PI2-2020-1/documentos/Estrutura/Simulações/Numero de nós.PNG

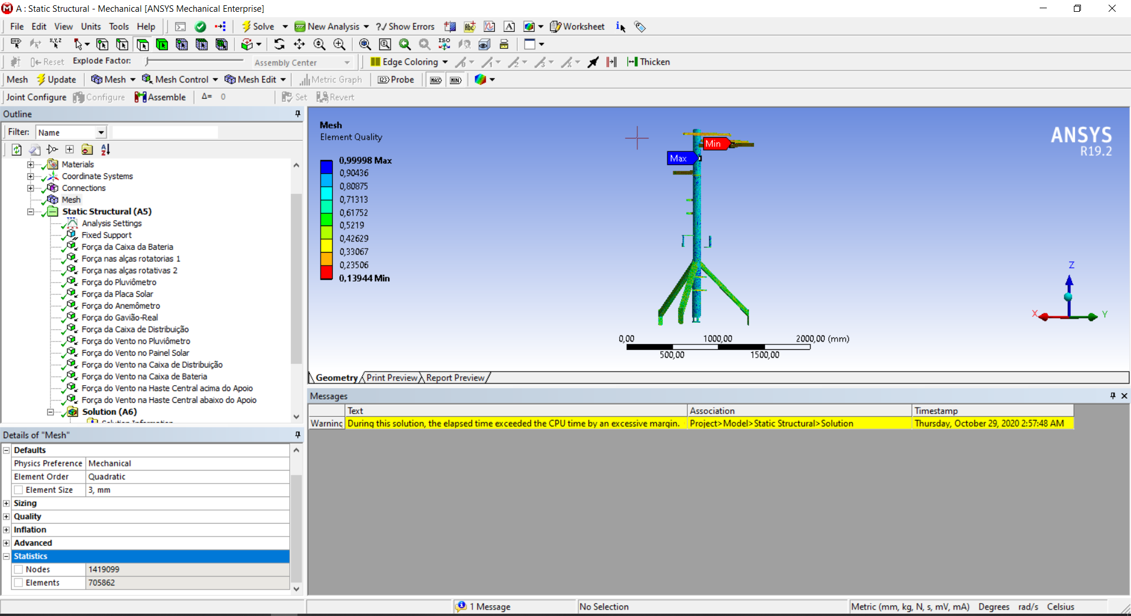
Estrutura/Simulações/Numero de nós.PNG
