PI2-2020-1/documentos/Estrutura/Simulações/vento.png

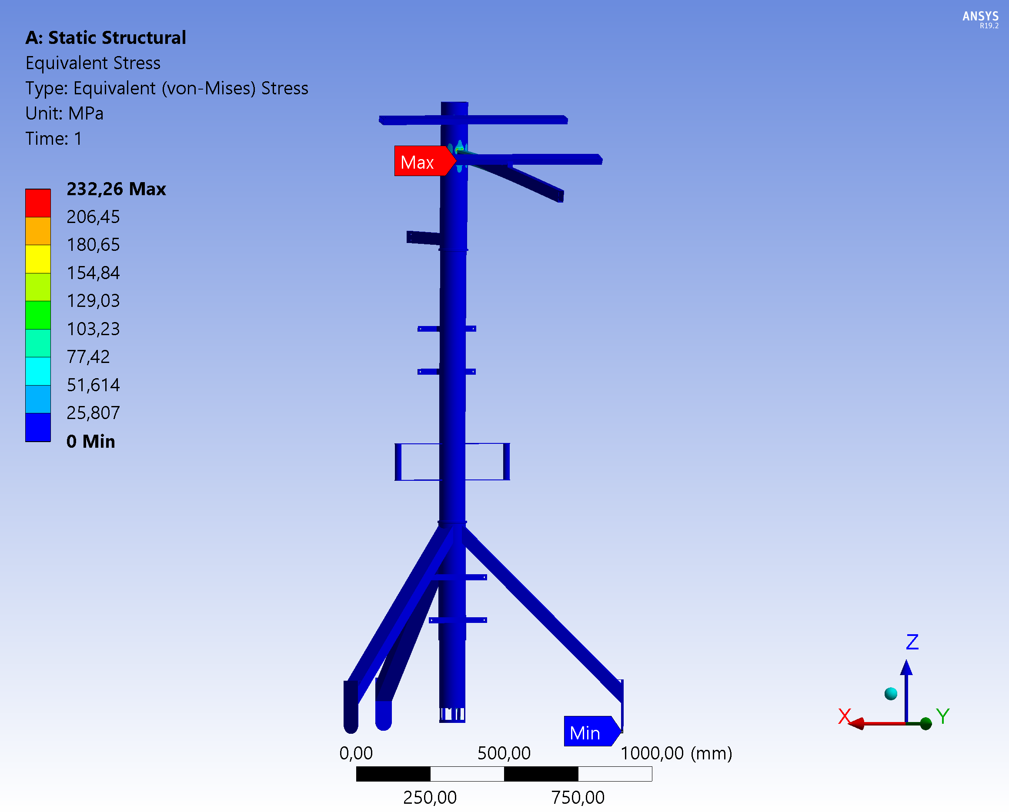
Estrutura/Simulações/vento.png
