PI2-2020-1/documentos/Arquitetura do projeto/Arquitetura_do_Projeto.pptx

Sensores

Estação de Verificação

Estação de Exposição

Sistema de condicionamento de sensores

Leitura e
Processamento
de Dados

Banco
de Dados

Bateria

Sistema de proteção

Sistema de proteção

Controlador de carga

Central de
Envio de Dados

Gerenciamento de
Energia

Software/
Aplicativo

Sistema de proteção

Painel
Fotovoltaico

Radiação solar

## Slide 2

ESP32

Estação de Verificação

Sensor de Velocidade do Vento

Sensor de pH

Sensor de Temperatura

Sensor de Umidade do Ar

Sensor de Umidade do Solo

Antena
LoRa

Controlador de Carga

Sensor de Pressão

Módulo GPS

Módulo GSM

Sistema de condicionamento de potência

Placa Fotovoltaica

Bateria

Radiação Solar
