PI2-2020-1/documentos/Arquitetura do projeto/EAP.pptx

## EAP das áreas

- Adicionar aqui os itens das respectivas EAPs para que seja feita a formatação.

EAP de Estrutura
DEFINIÇÃO DOS REQUISITOS
CÁLCULO DAS CARGAS
ESCOLHA DO MATERIAL
ELABORAÇÃO DO CAD
ANÁLISES CAE
CONFECÇÃO DOS DESENHOS TÉCNICOS
COMPRA DOS MATERIAIS
FABRICAÇÃO
BATERIA DE TESTES
FABRICAÇÃO: ACABAMENTO

EAP de Energia
CÁLCULO DA DEMANDA
DIMENSIONAMENTO DA GERAÇÃO
DIMENSIONAMENTO DO CONTROLADOR DE CARGA
DIMENSIONAMENTO DO BANCO DE BATERIAS
DESENVOLVER SISTEMA DE PROTEÇÃO ELÉTRICA
SISTEMA DE CONDICIONAMENTO DE TENSÃO
ATERRAMENTO DO SISTEMA DE ALIMENTAÇÃO
DIMENSIONAMENTO DOS CABOS
DESENVOLVER O PROJETO ELÉTRICO

EAP de Software
PLANEJAMENTO/DOCS
LEVANTAMENTO DE REQUISITOS
ELABORAÇÃO DO ROADMAP
DOCUMENTO DE CONTROLE DE RISCOS
DOCUMENTO DE CONTROLE DE QUALIDADE
PROTOTIPAÇÃO DA APLICAÇÃO
DOCUMENTO DE VISÃO
DOCUMENTO DE ARQUITETURA
MODELAÇÃO DO BANCO DE DADOS
IMPLEMENTAÇÃO
CRIAÇÃO DO BANCO DE DADOS
DESENVOLVIMENTO DA API
DESENVOLVIMENTO DA APLICAÇÃO WEB (FRONT END)

EAP de Eletrônica
Programar sensores do solo;
Programar sensores da estação meteorológica;
Programar módulo GPS;
Posicionar sensores do solo;
Testar os sensores do solo;
Posicionar a estação meteorológica e GPS;
Testar da estação meteorológica e GPS;
Agrupar os dados;
Verificação do envio e recebimento dos dados;

EAP de Gestão
RISCOS
EAP
CUSTOS
MONITORAMENTO DO PROJETO
INTEGRAÇÃO

## Slide 2

NOME DO PROJETO

GESTÃO

ELETRÔNICA

ENERGIA

ESTRUTURA

SOFTWARE

RISCOS

PROGRAMAÇÃO DOS SENSORES DO SOLO

CÁLCULO DA DEMANDA

LEVANTAMENTO DOS REQUISITOS

LEVANTAMENTO DOS REQUISITOS

EAP

PROGRAMAÇÃO DOS SENSORES DA ESTAÇÃO

DIMENSIONAMENTO DA GERAÇÃO

CÁLCULO DAS CARGAS

ELABORAÇÃO DO ROADMAP

CUSTOS

MONITORA-MENTO

PROGRAMAÇÃO DO MÓDULO GPS

POSICIONAMENTO DOS SENSORES DO SOLO

DIMENSIONAMENTO DO CONTROLADOR DE CARGA

DIMENSIONAMENTO DO BANCO DE BATERIAS

ESCOLHA DO MATERIAL

ELABORAÇÃO DO CAD

DOCUMENTO DE CONTROLE DE RISCOS

DOCUMENTO DE CONTROLE DE QUALIDADE

INTEGRAÇÃO

TESTE DOS SENSORES DO SOLO

DIMENSIONAMENTO DO INVERSOR

ANÁLISES CAE

PROTOTIPAÇÃO DA APLICAÇÃO

POSICIONAMENTO DA ESTAÇÃO E GPS

CONFECÇÃO DOS DESENHOS TÉCNICOS

DOCUMENTO DE VISÃO

TESTE DA ESTAÇÃO E GPS

COMPRA DOS MATERIAIS

DOCUMENTO DE ARQUITETURA

AGRUPAMENTO DOS DADOS

FABRICAÇÃO

MODELAÇÃO DO BANCO DE DADOS

TESTE DA TRANSFERÊNCIA DE DADOS

TESTES

CRIAÇÃO DO BANCO DE DADOS

ACABAMENTO

DESENVOLVIMENTO DA API

DESENVOLVIMENTO DA APLICALÇAO WEB (FRONT END)
