PI2-2020-1/documentos/Eletrônica/EAP-Eletrônica.docx

EAP - Eletrônica

- Programar sensores do solo;
- Programar sensores da estação meteorológica;
- Programar módulo GPS;
- Posicionar sensores do solo;
- Testar os sensores do solo;
- Posicionar a estação meteorológica e GPS;
- Testar da estação meteorológica e GPS;
- Agrupar os dados;
- Verificação do envio e recebimento dos dados;

Restrições e Metas Arquiteturais

O sistema de obtenção de dados do solo será implementado em conjunto com uma estação meteorológica capaz de fornecer dados climáticos acerca do local evitando eventuais danos causados pela intensidade do sol e de chuvas. Com isso os dados colhidos do solo serão fornecidos adequadamente para análise do agricultor. A seguir estão colocados restrições e metas para o uso adequado desse sistema:

- Os sensores de medição de umidade do solo e pH do solo são usadas para obter parâmetros necessários para identificar se o solo está apto a fazer plantações e indicar eventuais medidas corretivas.
- Os dados enviados à estação serão importantes para que o agricultor use procedimentos adequados caso precise melhorar os nutrientes do solo.
- Todos os dados obtidos pelos sensores serão enviados via LoRa para uma estação de processamento de dados em um local específico com a gerência da plantação capaz de analisar corretamente.
