PI2-2020-1/documentos/Eletrônica/Riscos_Eletrônica.docx

Riscos de eletrônica

- Sensores queimarem;
- Não encontrar componentes à venda
- Fios condutores romperem;
- Algoritmos complexos e incorretos;
- Falha na comunicação LoRa
- Falhas ao se integrar sistemas
- Leitura incorreta dos dados
