PI2-2020-1/documentos/Eletrônica/Tarefas_PC2.docx

Daniel | Igor | Wilton
sensor de ph | Colocar sleep | Introduzir restrições e metas
sensor de umidade do solo | Planilha Avaliação Interna | Corrigir páginas em branco
| adicionar referência cap 7 | sensor bme 280
| Anemômetro | pluviômetro
| módulo gsm

- Pesquisar detalhadamente sobre os sensores e escrever no pc2
