PI2-2020-1/documentos/Eletrônica/Untitled document (2).docx

Estação do solo | Preço
Sensor de pH do solo | 178,50
Sensor de umidade do solo | 9,90
Esp 32 | 42,00
Modulo gsm | 179,00
Total | 409,40

Estação Meteorológica | Preço
Anemometro | 237,03
Pluviometro | 265,53
Sensor bme280 | 30,99
Total | 533,55

Sensores | Preço
Sensor de pH do solo | 178,50
Sensor de umidade do solo | 9,90
Esp 32 | 42,00
Anemometro | 237,03
Pluviometro | 265,53
Sensor bme280 | 30,99
Modulo gsm | 179,00
Total | 942,95

[1] Ph do solo: https://produto.mercadolivre.com.br/MLB-797773127-modulo-sensor-ph-eletrodo-sonda-bnc-arduinophmetro-_JM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

[2] Umidade do Solo

https://www.eletrogate.com/modulo-sensor-de-umidade-de-solo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

[3] Esp32

https://produto.mercadolivre.com.br/MLB-1614475865-esp32-wroom-devkit-_JM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

[4] Anemometro

https://www.usinainfo.com.br/estacao-meteorologica-arduino/anemometro-arduino-sensor-de-vento-para-estacao-meteorologica-sv10-3686.html

[5] Pluviometro

https://www.usinainfo.com.br/estacao-meteorologica-arduino/pluviometro-de-bascula-digital-arduino-para-estacao-meteorologica-pb10-4637.html

[6] Sensor Bme280

https://produto.mercadolivre.com.br/MLB-1410976290-sensor-bme280-presso-temperatura-e-umidade-alta-preciso-_JM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

[7] Modulo gsm

https://produto.mercadolivre.com.br/MLB-820363244-modulo-gsm-gprs-quad-band-sim808-com-gps-arduino-_JM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
