PI2-2020-1/documentos/Energia/Anotações de Reuniões com professores/Reunião   09_10_2020.docx

Reunião com o Professor Aléx 09/10/2020

- Revisar o dimensionamento da bateria da Estação Meteorológica
- Calcular fator de segurança
- *Circuito de condicionamento*
- *A corrente do controlador de carga tem que ser maior que a corrente da carga*
- **Conversor CC** (BUCK - sTEP DOWN) *para cada carga*
- Sistema de proteção (fusível/chave)

Empresa que a ICOANA recomendou :
