PI2-2020-1/documentos/PC2_apresentacao_grupo_10.pdf

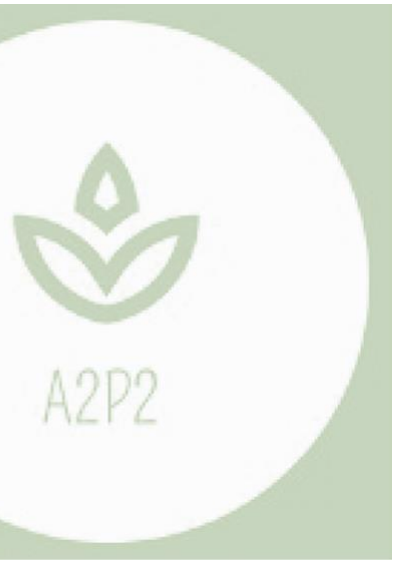
[picture p51: figure]

A2P2

### Analisador de Ambiente para Plantações

Monitoramento de dados do solo e do clima para
tomada de decisão

Seja bem-vindo ao

Responsabilidade
Ambiental

Resposta a demandas
do produtor

# Estrutura

# Sistema de Alimentação

### Demanda energética

- Tempo de medição

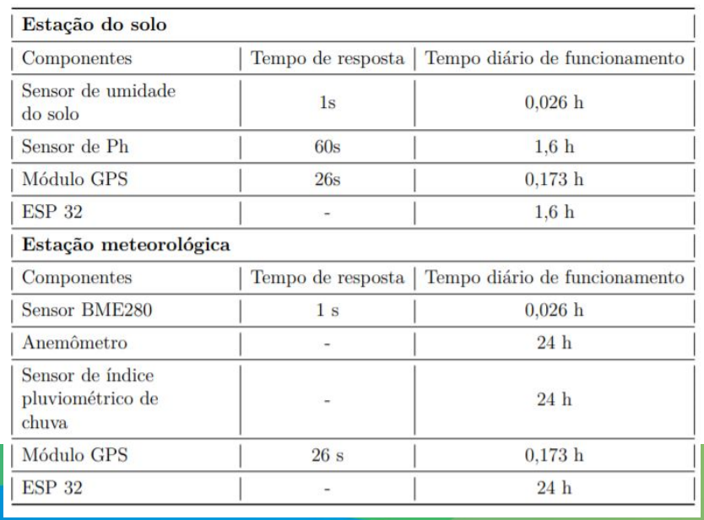
[picture p52: figure]

### Demanda energética

Estação do solo

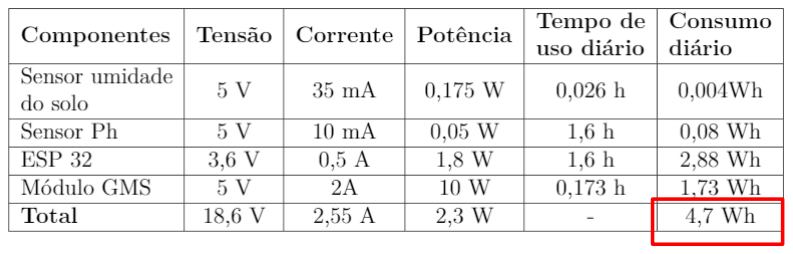
[picture p53: figure]

### Demanda energética

Estação Meteorológica

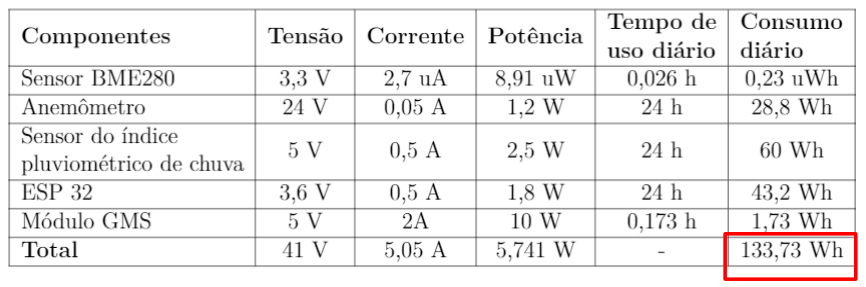
[picture p54: figure]
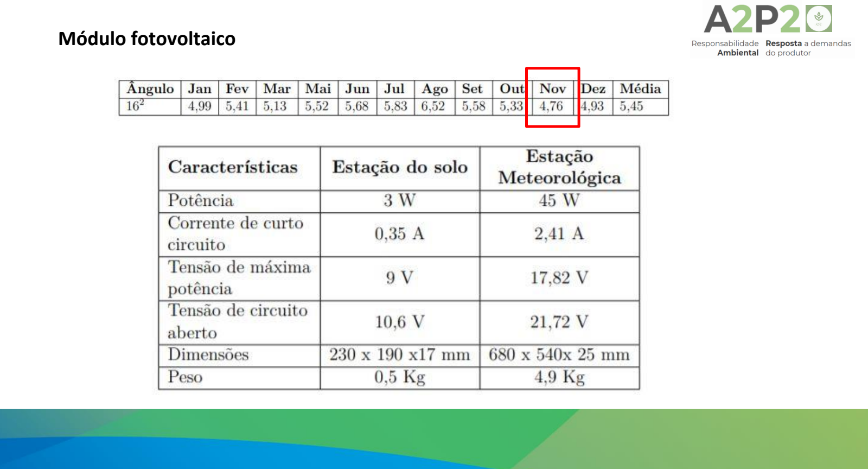
[picture p55: page 8]

### Módulo fotovoltaico

## Bateria

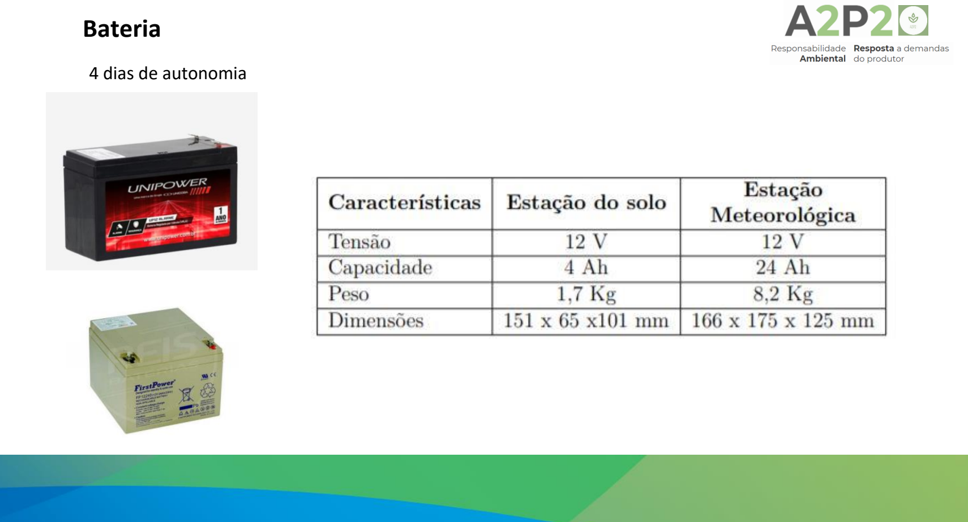
[picture p56: page 9]

4 dias de autonomia

## Controlador de carga

Estação do solo | Estação Meteorológica

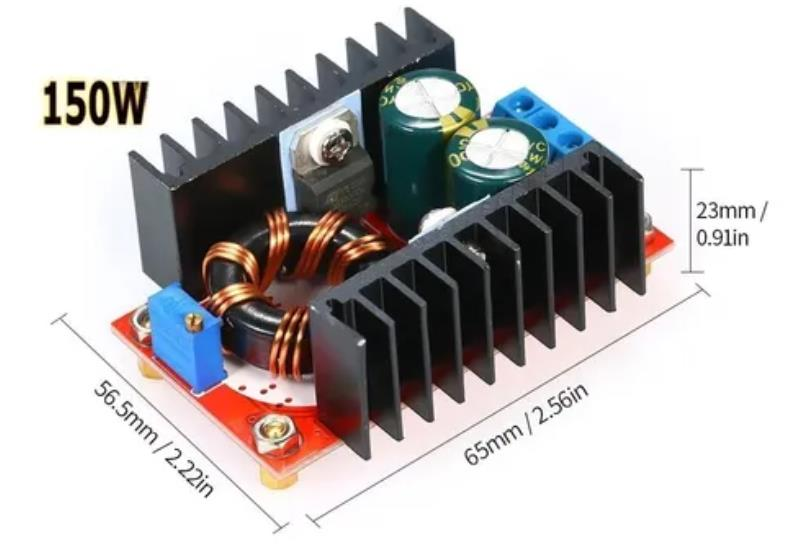
[picture p57: figure]

Entrada: 5V | Corrente: 5A
Saída: 12V

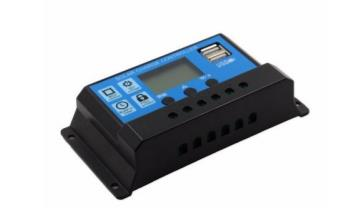
[picture p58: figure]

Entrada: 18V Corrente: 10A Saída: 12V

# Sistema de Condicionamento de Potência

Sistema de
armazenamento

Sistema de
Geração

Sistema de
Condicionamento
de Potência

Cargas

Sistema de condicionamento de potência como conexão entre os sistemas de geração, armazenamento e carga.

## Sistema de Condicionamento de Potência

Estação Meteorológica Estação do solo

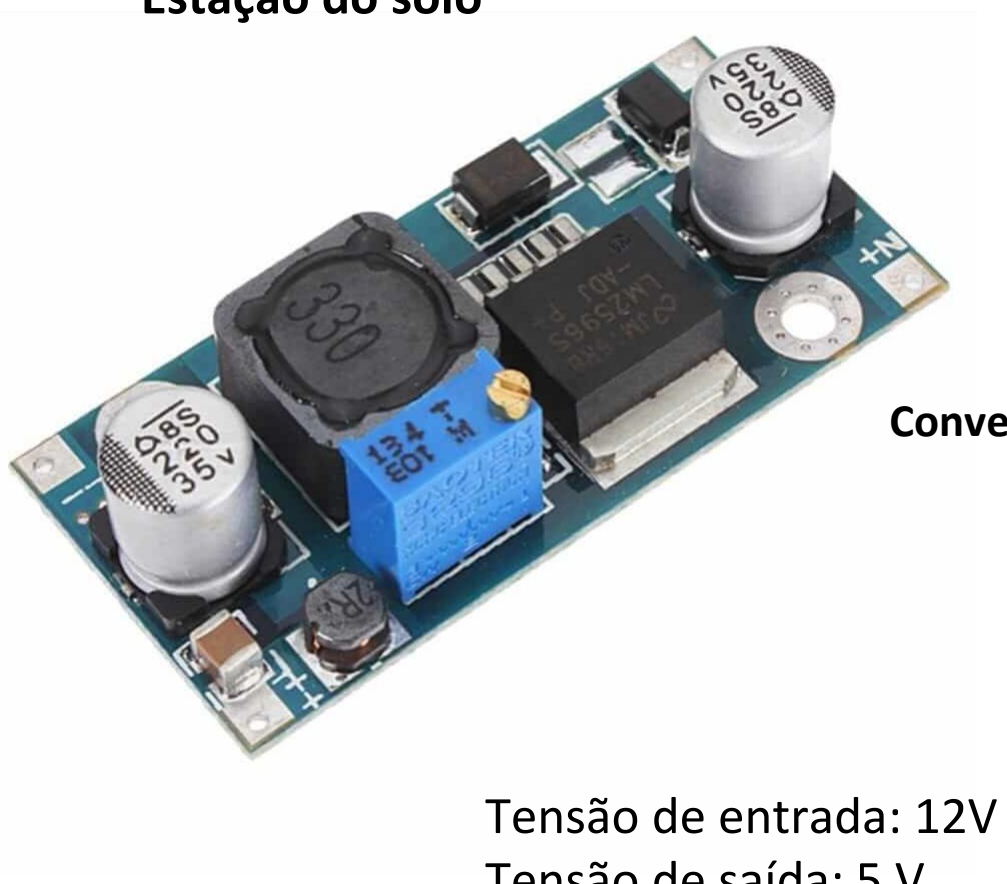
[picture p59: figure]
Tensão de entrada: 12V

Tensão de saída: 5 V
Corrente de saída: 2,5 A

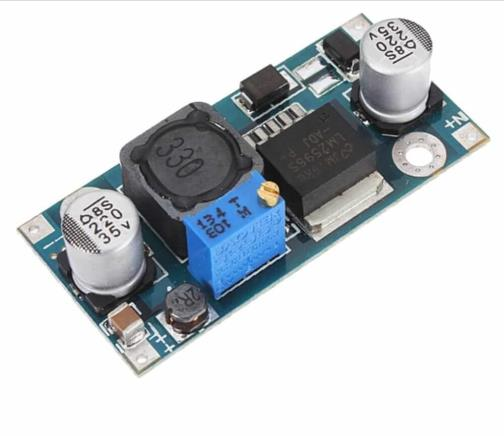
[picture p60: figure]

Tensão de entrada: 12 V
Tensão de saída: 3,3 V e 5 V Corrente de saída: 3 A

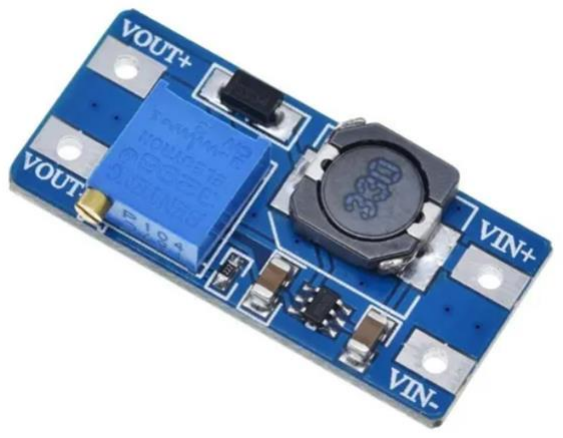
[picture p61: figure]

Conversor CC/CC Step-up

Conversor CC/CC Step
Down

Conversor CC/CC Step Down

Tensão de entrada: 12 V
Tensão de saída: 24 V
Corrente de saída: 3 A

## Diagrama unifilar: Estação do Solo

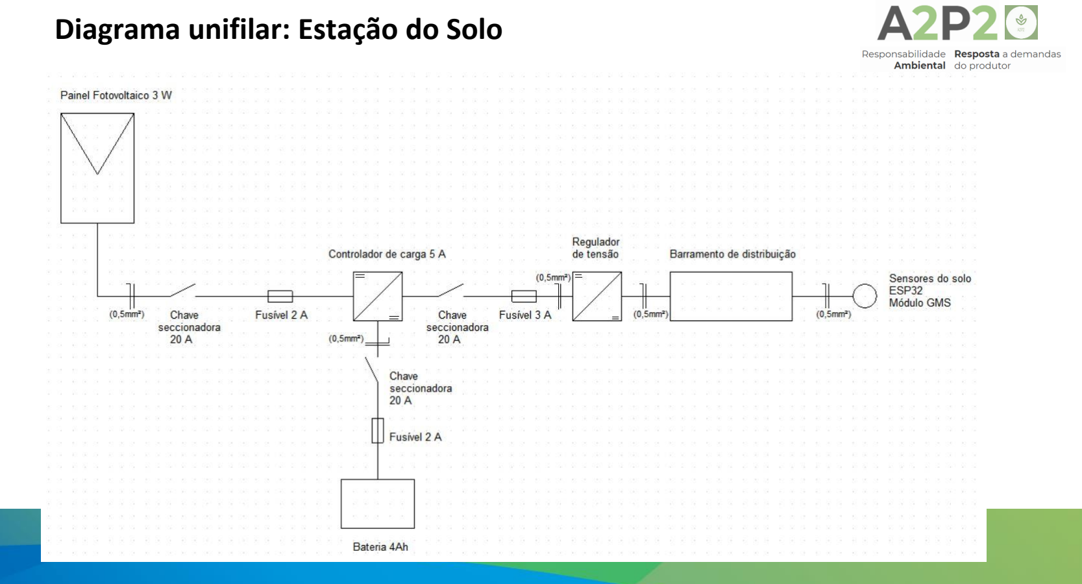
[picture p62: page 13]

## Diagrama unifilar: Estação Meteorológica

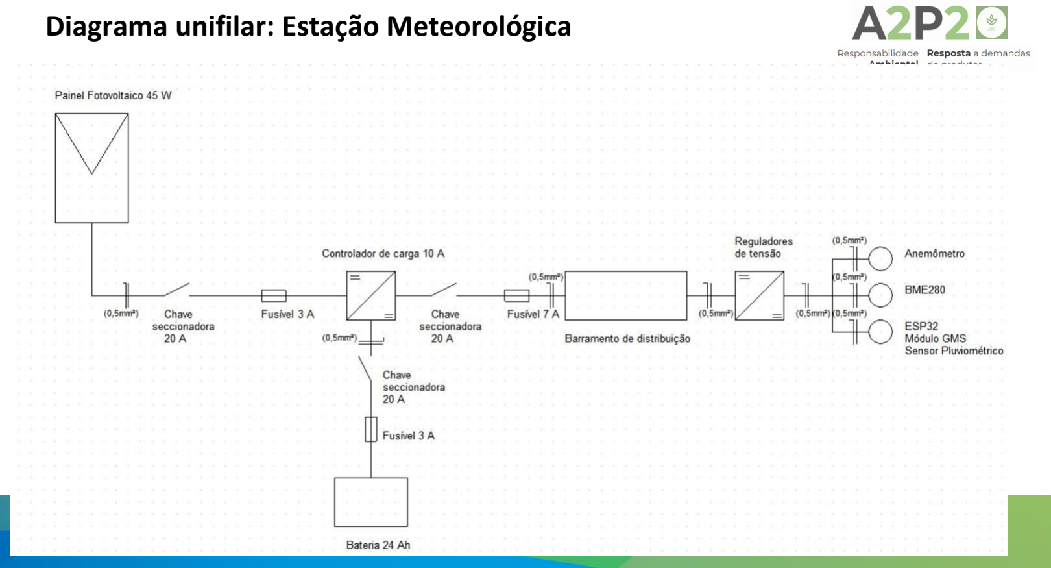
[picture p63: page 14]

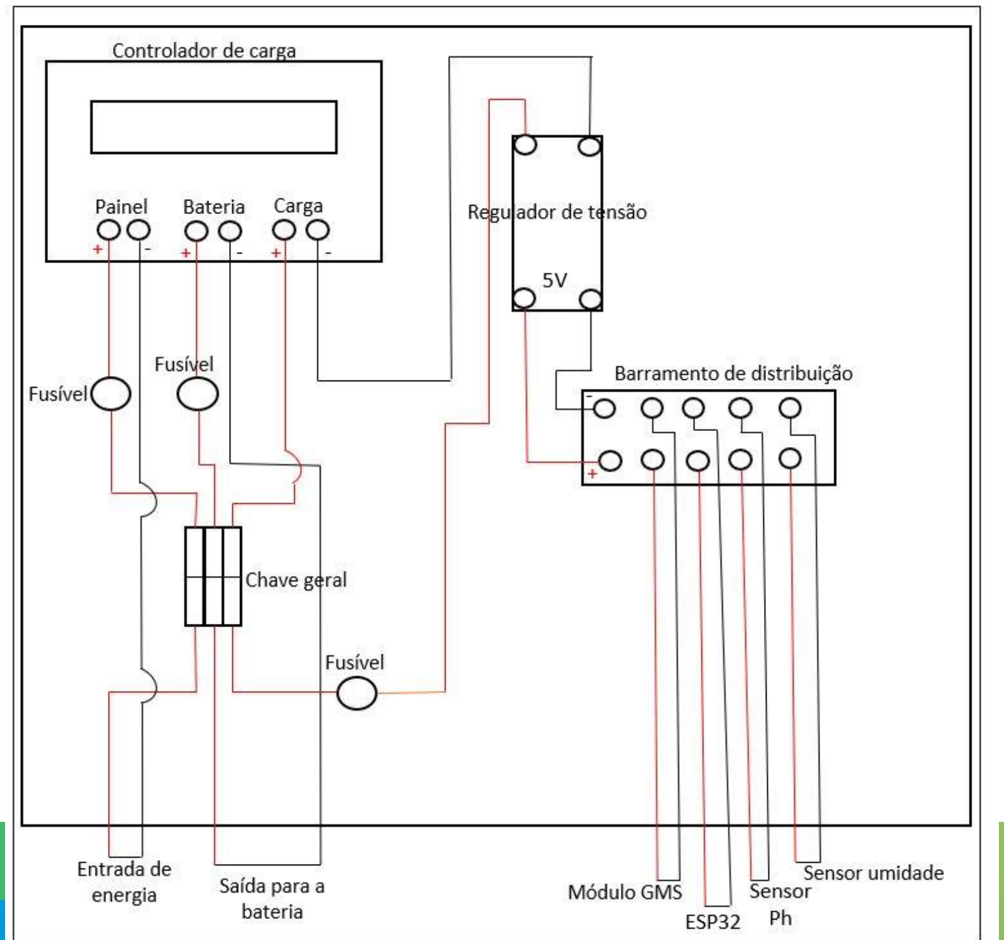
[picture p64: figure]

## Estação do solo

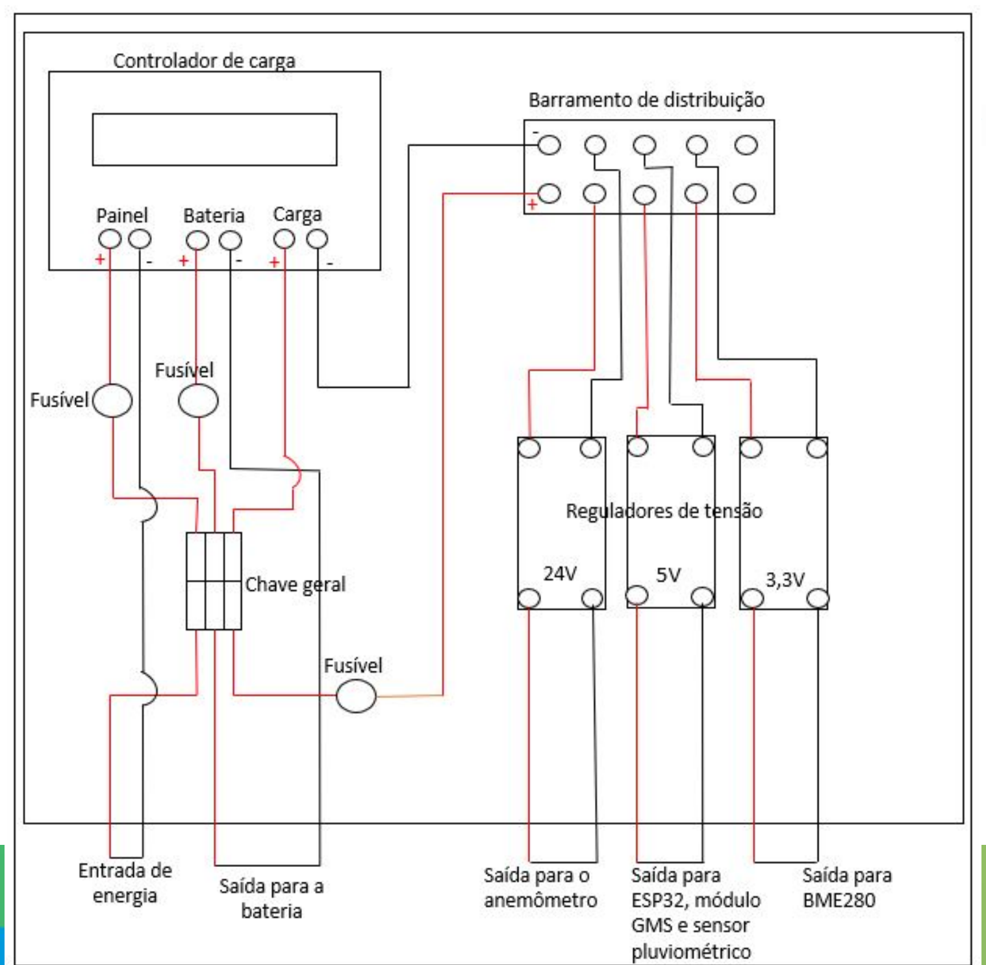
[picture p65: figure]

## Estação Meteorológica

# Eletrônica

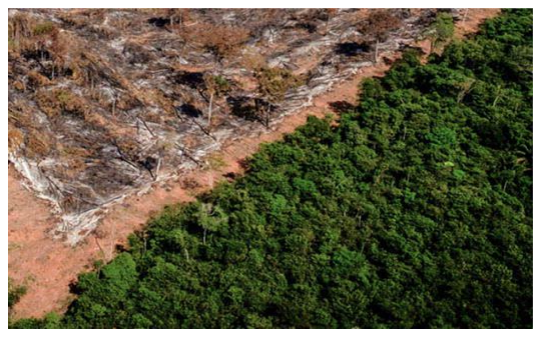
[picture p66: figure]
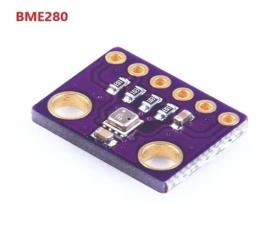
[picture p67: figure]
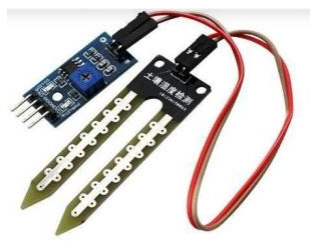
[picture p68: figure]
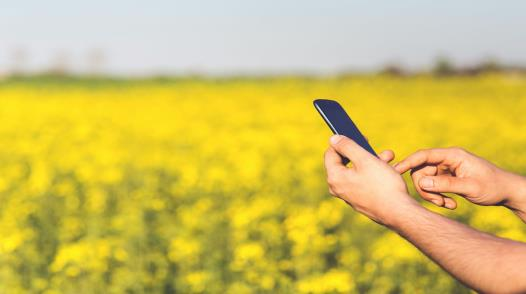
[picture p69: figure]

Responsabilidade
Ambiental

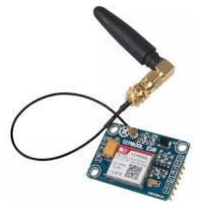
[picture p70: figure]

Resposta a demandas
do produtor

# Características Técnicas

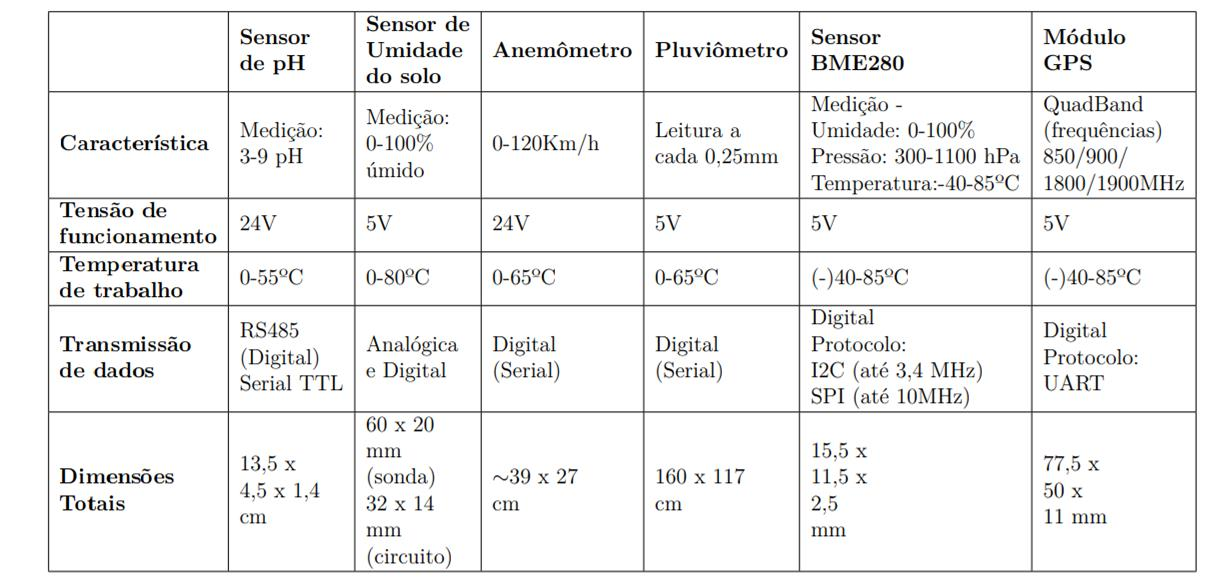
[picture p71: figure]

# Especificações Microcontroladores

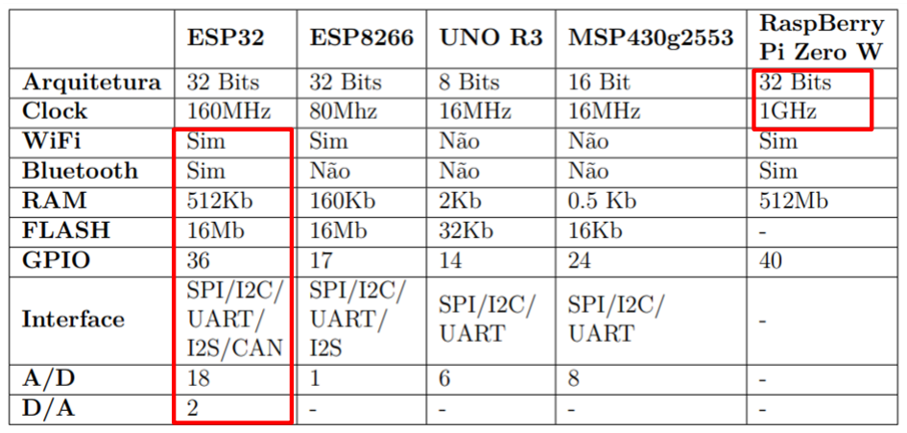
[picture p72: figure]

# Diagramas Lógicos

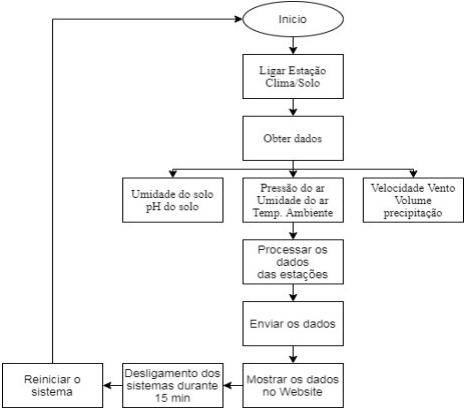
[picture p73: figure]

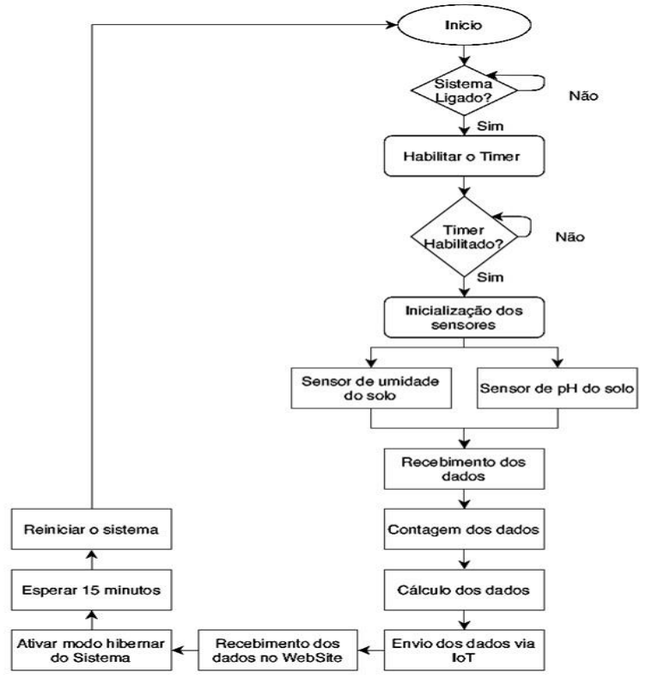
[picture p74: figure]

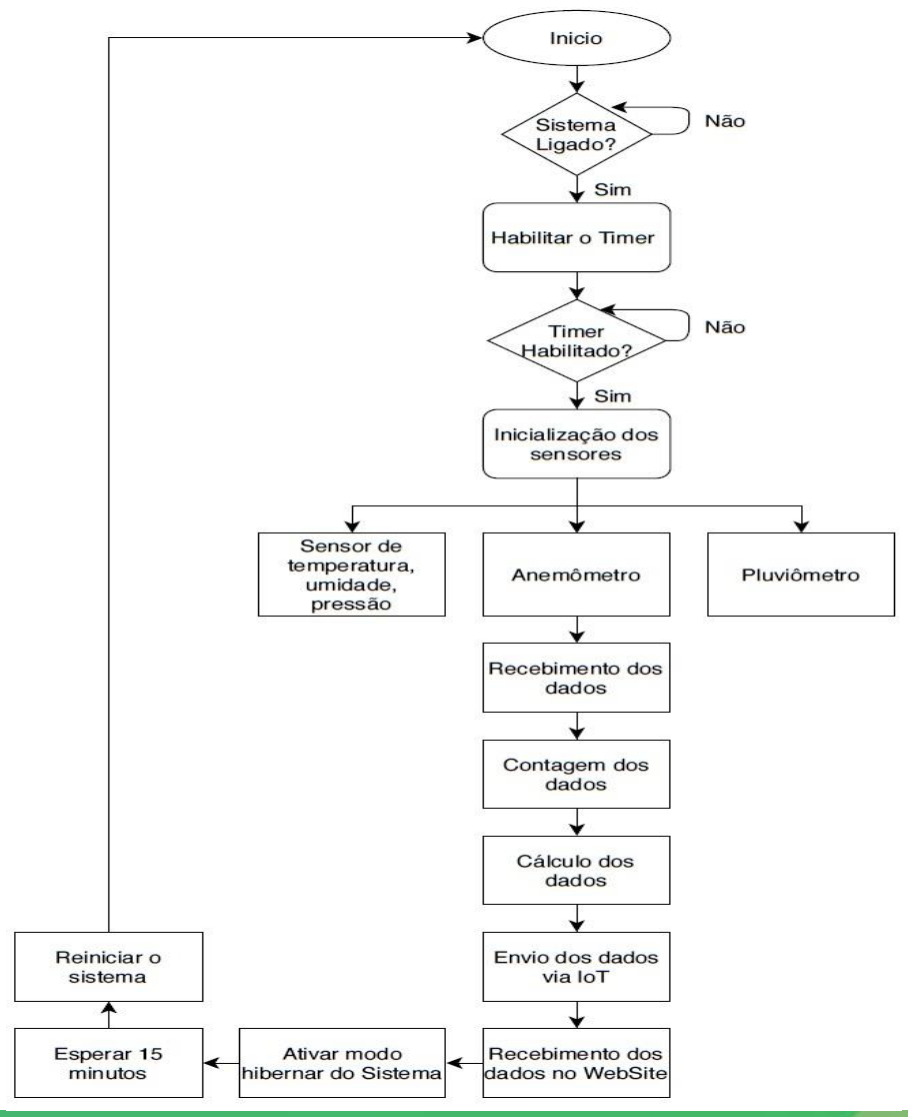
[picture p75: figure]

# Códigos dos Sensores

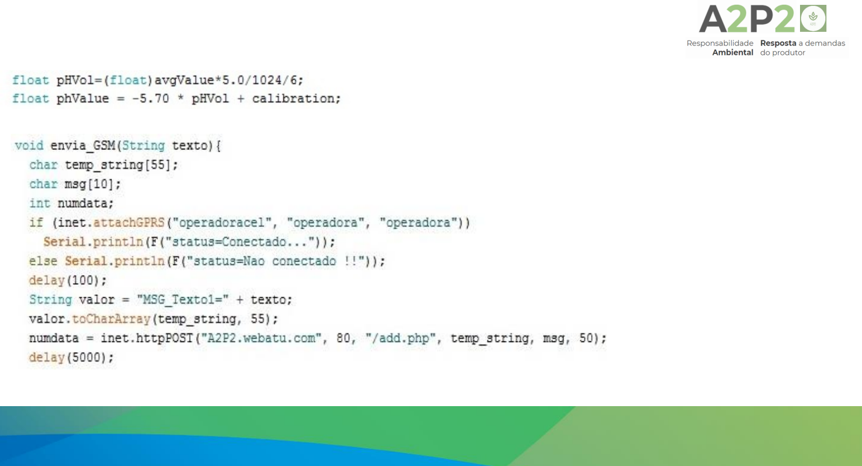
[picture p76: page 26]

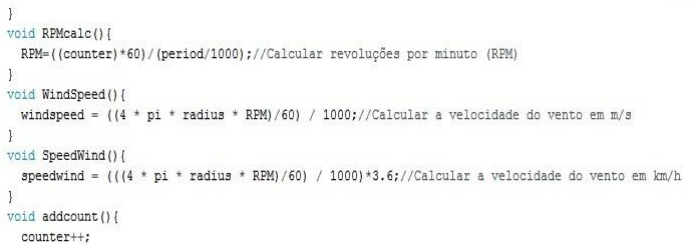
[picture p77: figure]

# Software

# Diagrama Geral

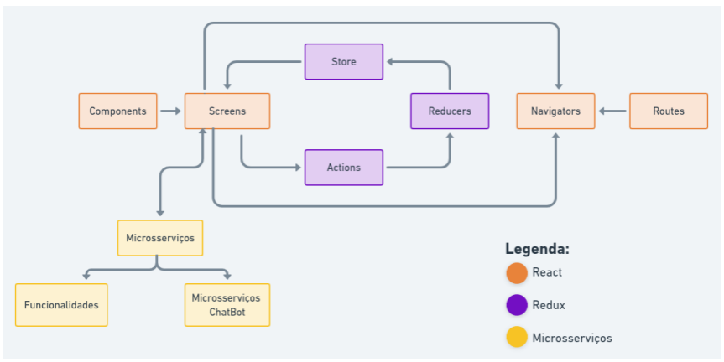
[picture p78: figure]

Diagrama Entidade-Relacionamento (DER) (https://www.devmedia.com.br/modelo-entidade-relacionamento-mer-e-diagrama-entidade-relacionamento-der/14332)

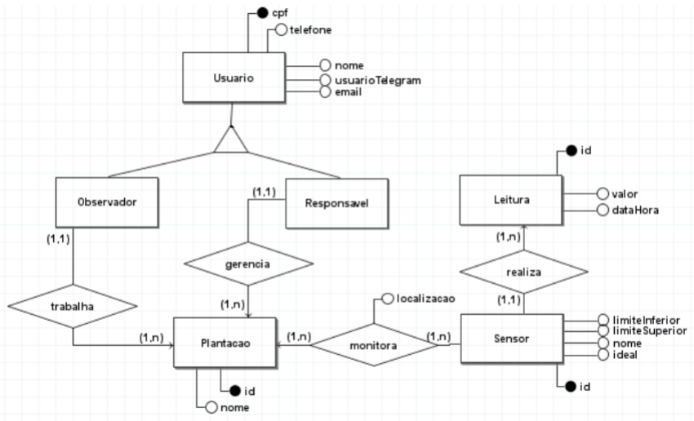
[picture p79: figure]

Demonstração (https://www.devmedia.com.br/modelo-entidade-relacionamento-mer-e-diagrama-entidade-relacionamento-der/14332)

# Schema

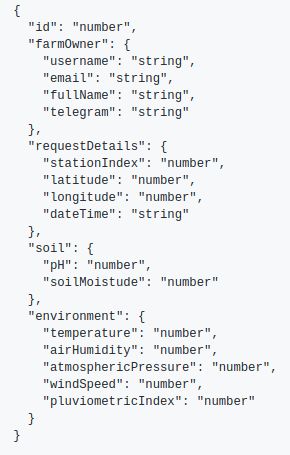
[picture p80: figure]

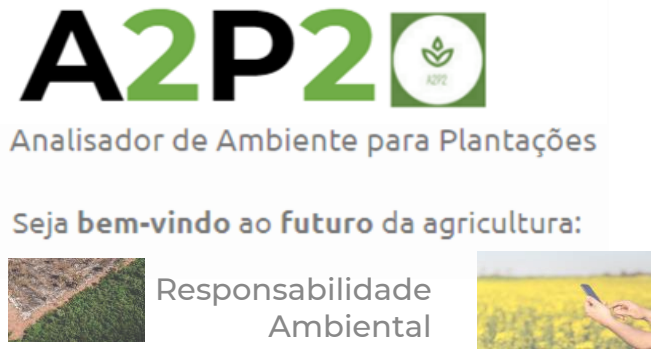
[picture p81: figure]
Responsabilidade Ambiental

# Muito Obrigado

!

Resposta a demandas
do produtor
