PI2-2020-1/documentos/PC3_apresentacao_grupo_10.pdf

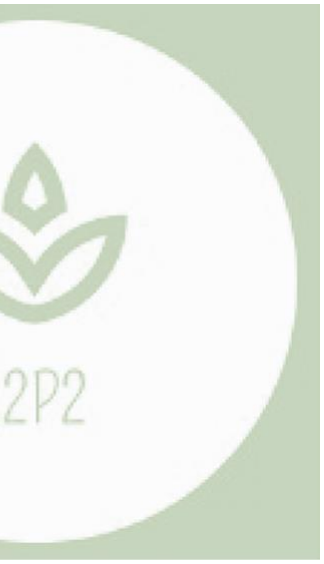
[picture p82: figure]

A2P2

Analisador de Ambiente para Plantações

Monitoramento de dados do solo e do clima para
tomada de decisão

Seja bem-vindo ao

Responsabilidade
Ambiental

Resposta a demandas
do produtor

# Software

# Software

# Web

Admin | Fazendeiro | Funcionário

# Perfis de Usuário

(Empresa) | (Cliente)

# Software

# Chatbot

# Eletrônica

## Comunicação do sistema embarcado

A ligação entre os sensores e a ESP32 depende do protocolo ou padrão de comunicação em que os sensores se baseiam. Dessa forma, os protocolos ou padrão presentes são:

- I²C
- RS-485
- UART

## Plano de montagem

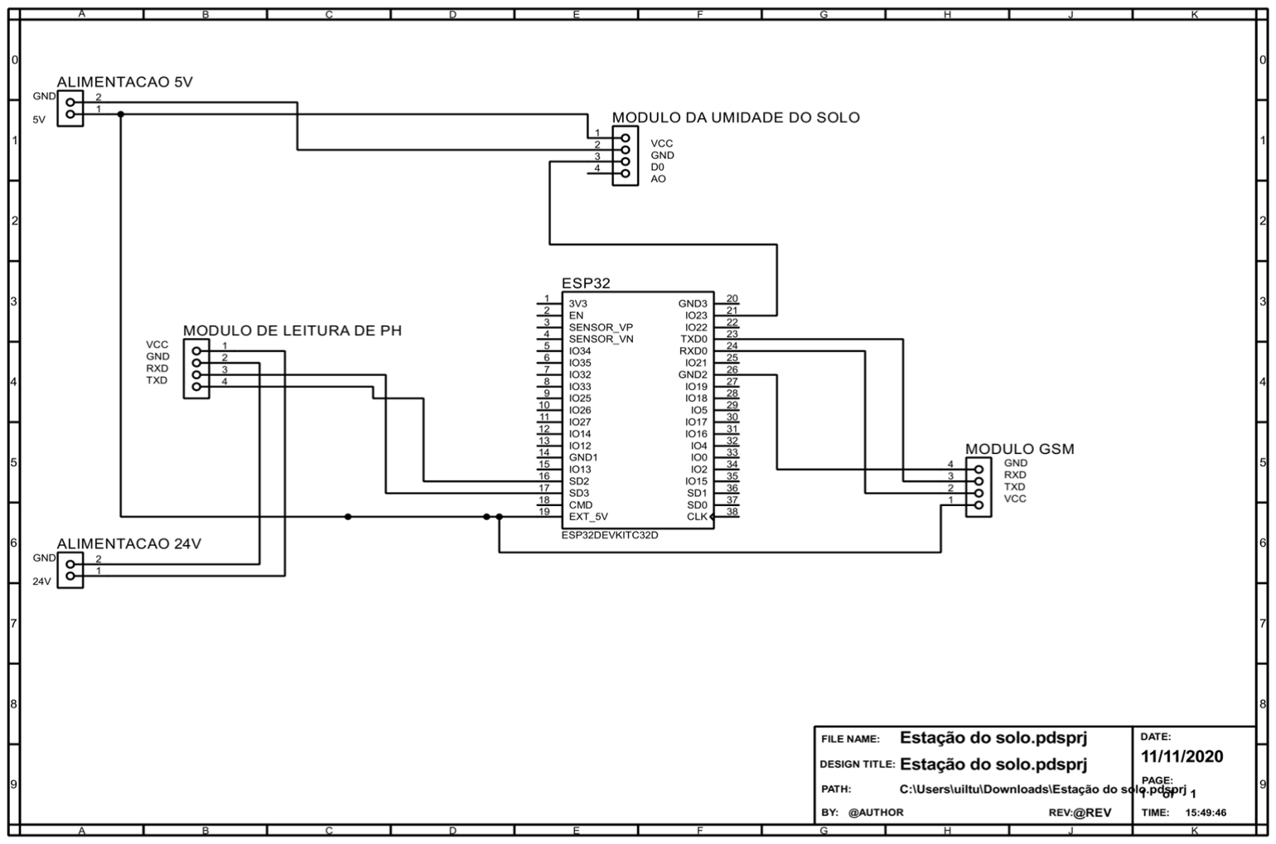
[picture p83: figure]

## Plano de montagem

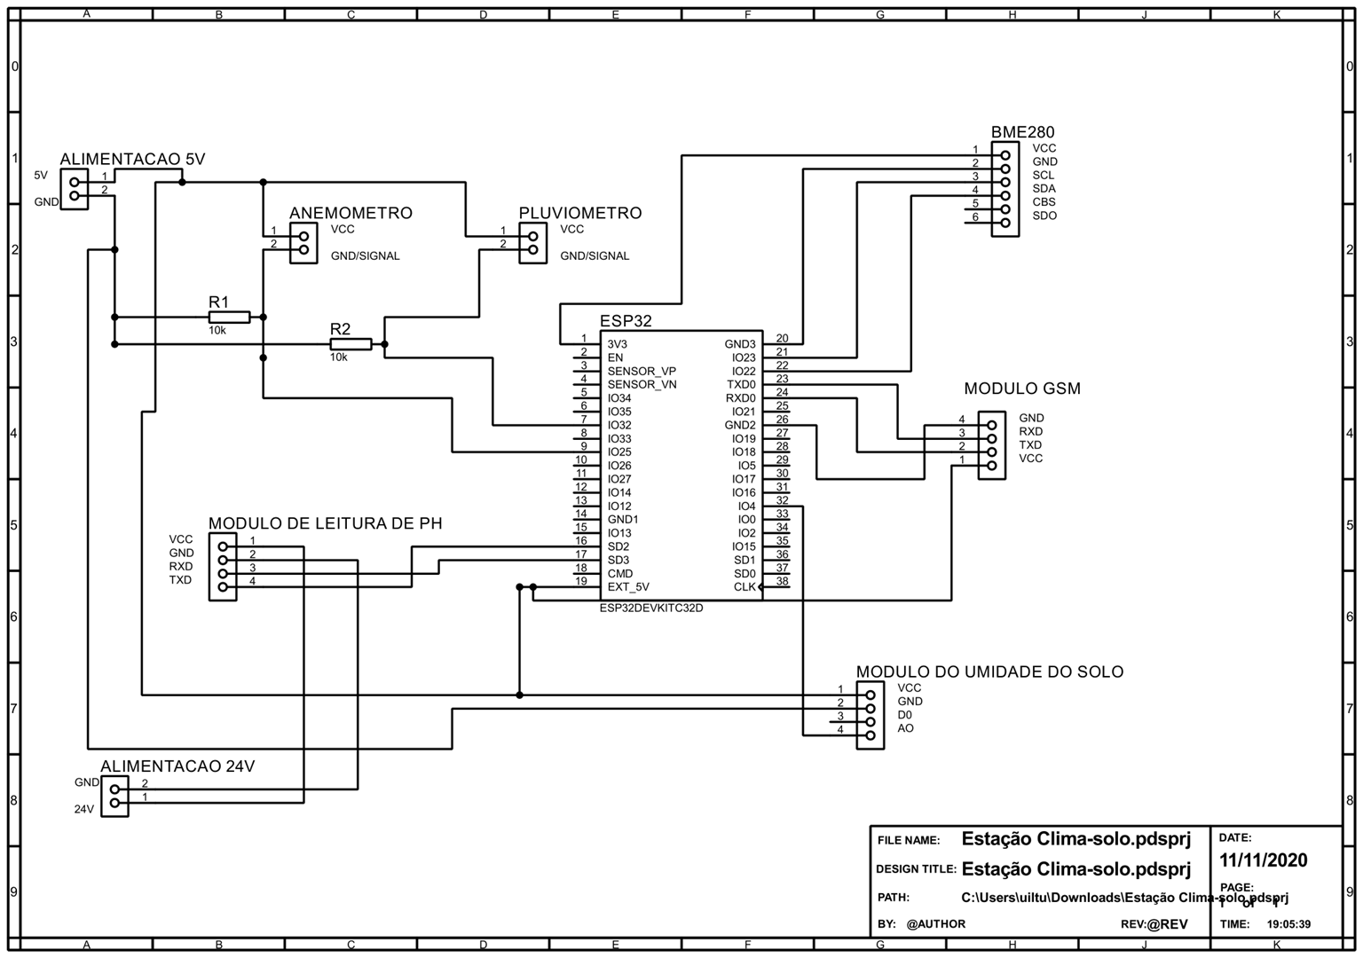
[picture p84: figure]

## Plano de fabricação

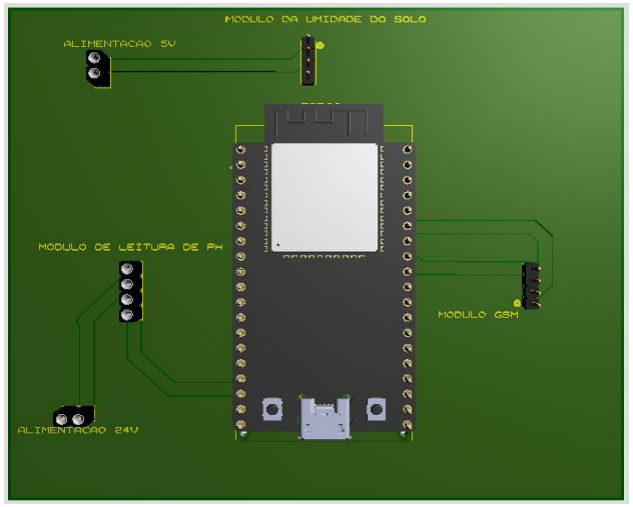
[picture p85: figure]

## Plano de fabricação

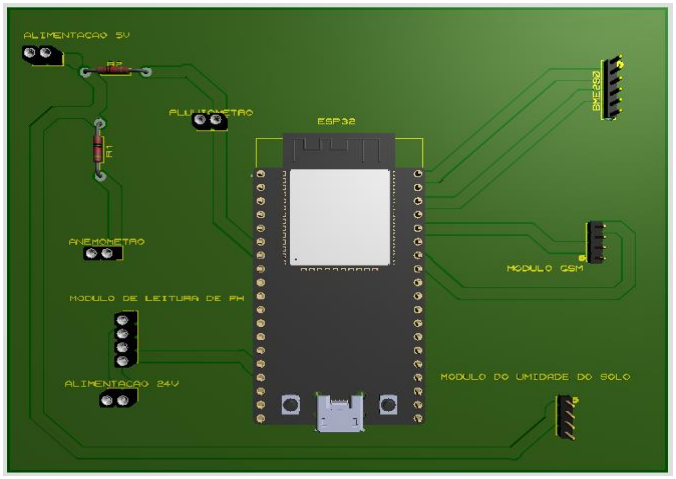
[picture p86: figure]

# Testes dos sensores

- Bme 280;
- Anemômetro;
- Pluviômetro;
- Umidade do solo e pH;
- Módulo GSM;

# Testes dos sensores

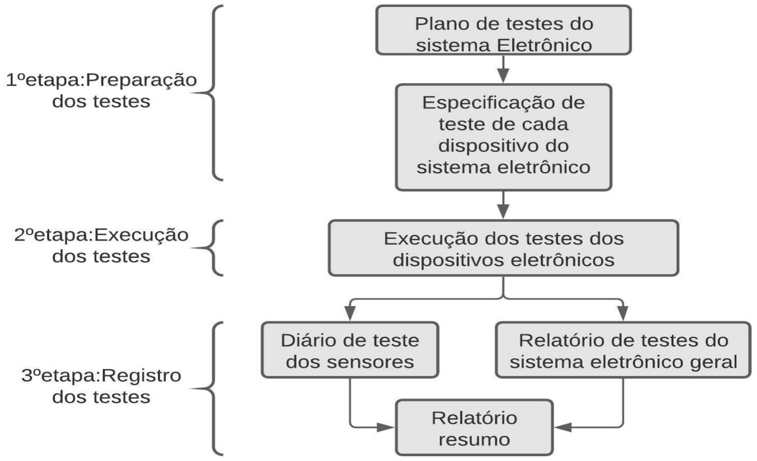
[picture p87: figure]

# Manutenção dos sensores

- Estação Clima-Solo;
- Estação Solo;

# Validação dos sensores - Comparação dos valores medidos por todos

os | sensores | utilizando | equipamentos
validados que sensoriam as mesmas variáveis;

# - Comparação dos valores obtidos pelos

sensores com valores padronizados. Ex:pH;

# Manutenção dos sensores

# - Comparação dos dados obtidos por meio dos sensores do clima, da estação Clima-Solo, com os dados do banco de dados obtidos em tempo real disponibilizados a partir do site do

INMET.

# Sistema de Alimentação

## Sistema de Alimentação

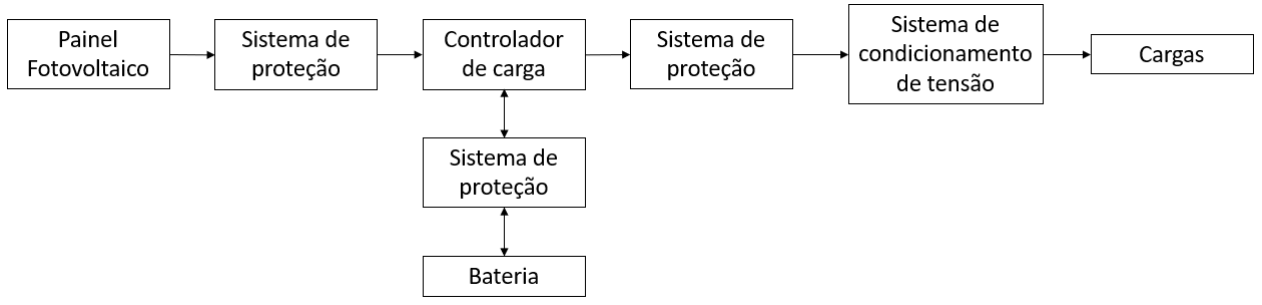
[picture p88: figure]

## Sistema de Alimentação

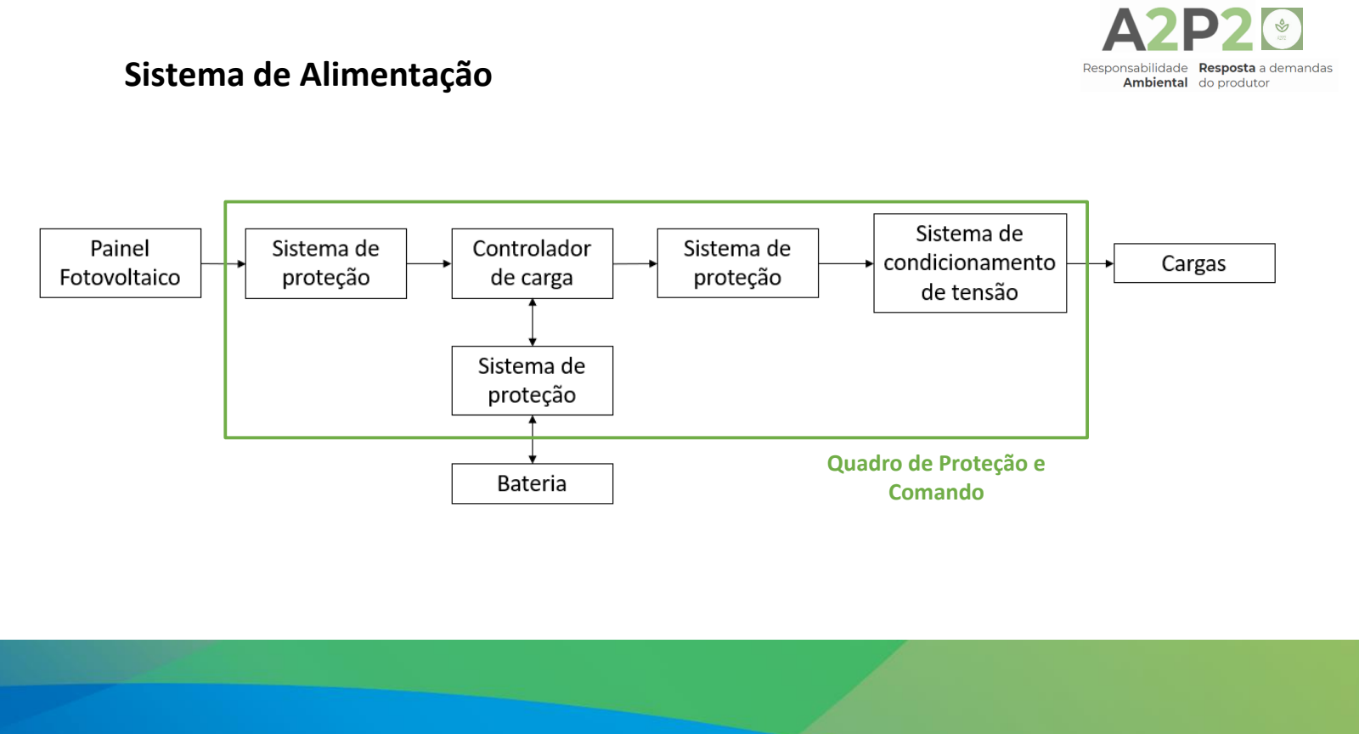
[picture p89: page 19]

Quadro de Proteção e
Comando

## Quadro de proteção e comando

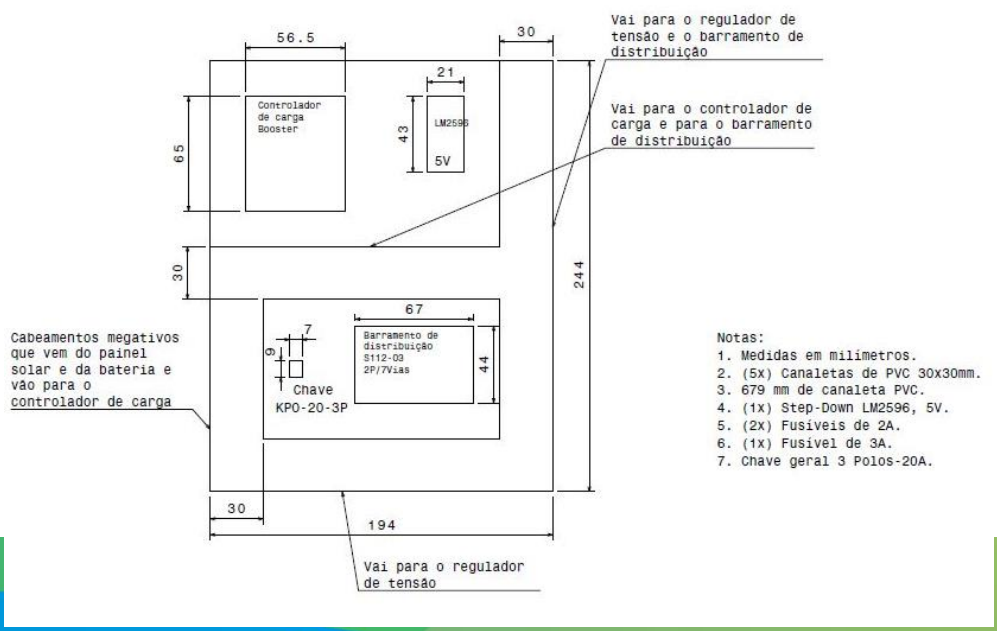
[picture p90: figure]

## Estação Solo

## Quadro de proteção e comando

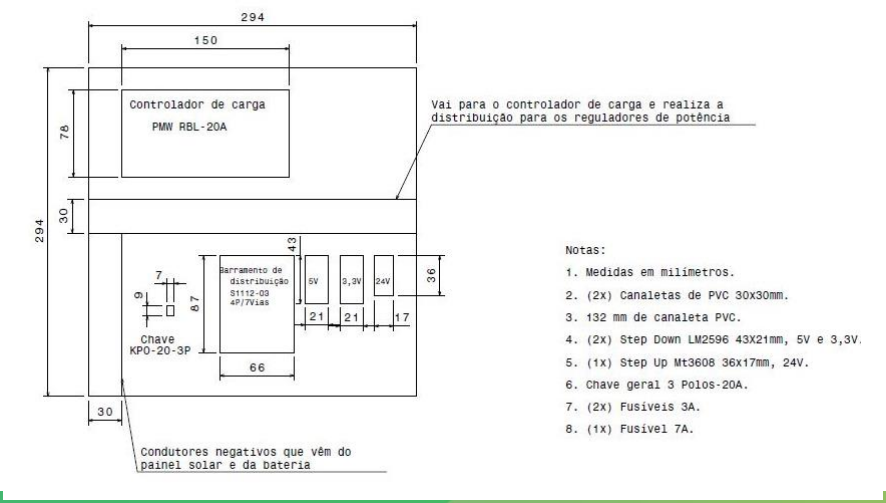
[picture p91: figure]

## Estação Clima-Solo

## Plano de fabricação

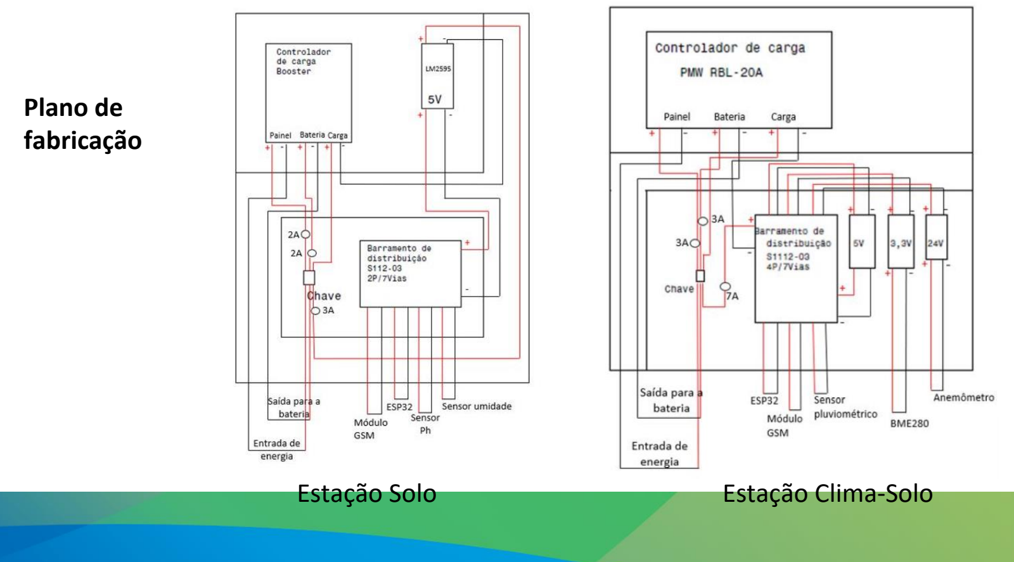
[picture p92: page 22]

Estação Solo | Estação Clima-Solo

## Plano de fabricação

Para o painel solar,

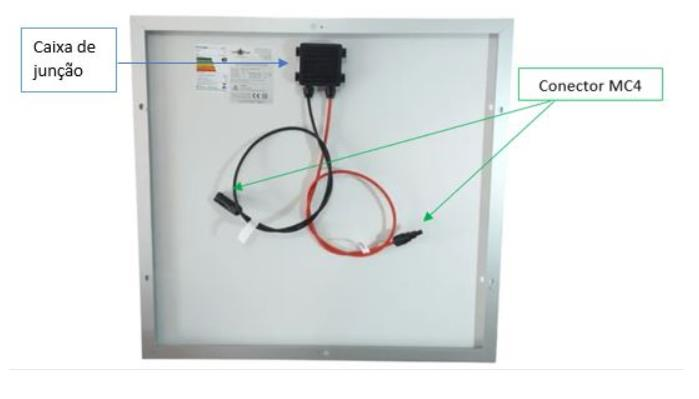
[picture p93: figure]

## Plano de teste

## Atividade de Comissionamento

## Inspeção visual

## Testes operacionais

## Plano de teste

## Inspeção visual:

Qualidade dos equipamentos;
Identificar as conexões;
Presença de placas de advertência de choque elétrico;
Montagem e segurança do painel solar e da estrutura de sustentação; Orientação e inclinação do painel solar;
Se a estrutura e o painel solar não apresentam danos aparentes; Montagem adequada da bateria;
Documentação completa do sistema de alimentação.

## Plano de teste

## Testes operacionais:

Medição da tensão de circuito aberto Voc.

Medição da corrente de curto-circuito Isc.

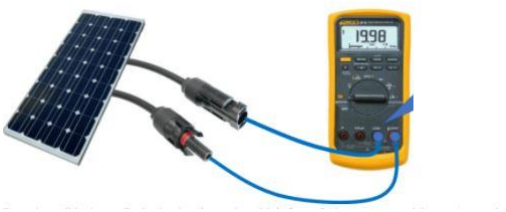
[picture p94: figure]

# Estrutura

# Integração

# Integração

# Módulos e Alimentação

## Modo sleep

## Tempo de uso diário = 24h

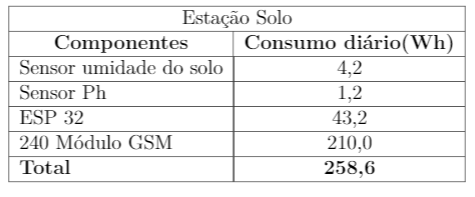
[picture p95: figure]
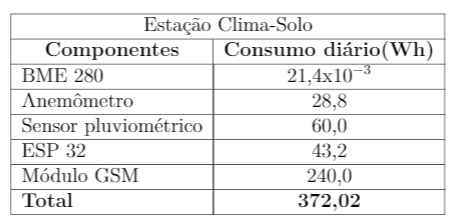
[picture p96: figure]

## Modo sleep: 15 min

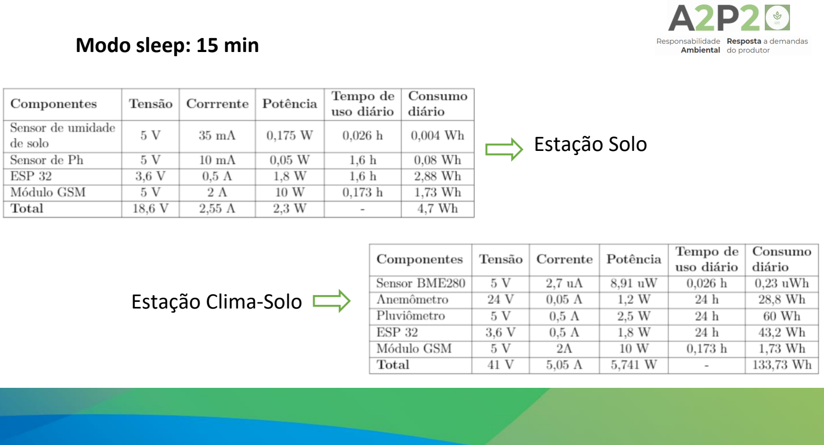
[picture p97: page 31]

## Estação Clima-Solo

## Estação Solo

## Modo sleep

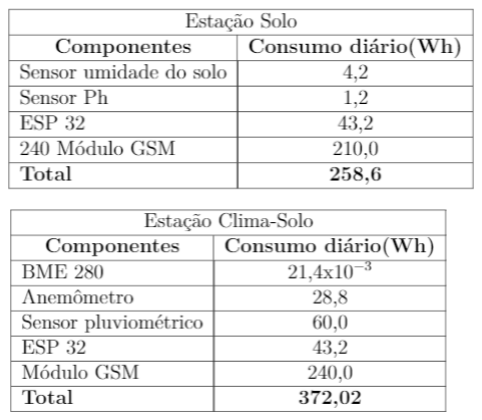
[picture p98: figure]

## Redução de 54% e

1,8%

Tempo de medição 15min:
Estação Solo = 4,7 Wh
Estação Clima-Solo = 133,73 Wh

# Integração

# Software e Sensores

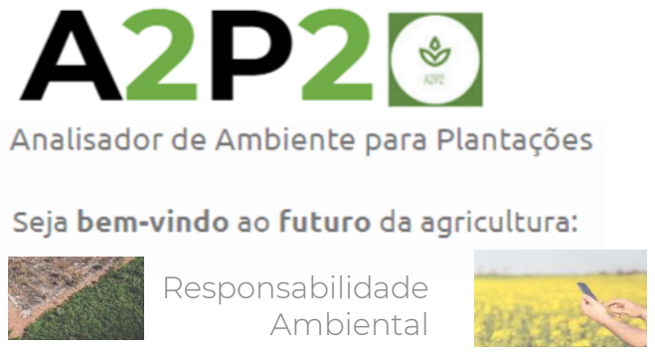
[picture p99: figure]
Responsabilidade Ambiental

# Muito Obrigado

!

Resposta a demandas
do produtor
