PI2-2020-1/documentos/Energia/ Roteiro_Dimensionamento.docx

1. Cálculo da demanda
2. Dimensionamento da geração

2.1 Avaliação da irradiação solar

2.2 Escolha do painel fotovoltaico

3. Dimensionamento do controlador de carga
4. Dimensionamento do banco de baterias

4.1 Autonomia sem insolação

4.2 Escolha da bateria

4.3 Profundidade de descarga

5. Dimensionamento do controlador de carga
6. Sistema de proteção elétrica
7. Sistema de condicionamento de potência
8. Aterramento
9. Dimensionamento dos cabos
10. Projeto elétrico
