PI2-2020-1/documentos/Energia/Tabela_Preços_Energia.docx

Componente | Preço
Painel fotovoltaico | R$ 21,87
Bateria | R$ 79,50
Controlador de carga | R$ 89,00
