PI2-2020-1/documentos/Software/Roteiro Apresentação PC3.docx

Específico

- Perfis de Usuário
  - Admin
  - Fazendeiro
  - Funcionário
- WEB
  - Fluxo de Cadastro (Para todos os perfis)
  - Dashboard
  - Página de Perfil
  - Relatórios
  - Definição e Alteração dos Parâmetros
- CHATBOT
  - Alterar Parâmetro
  - Simular notificação de parâmetro fora do limite
  - Mostrar dados mais recentes

Integração

- POST da placa para a API no insomnia (valor dos sensores)
- CHATBOT
  - Mostrar notificação
