PI2-2020-1/documentos/Estrutura/DTs/0_clima_solo/DT2_CLIMA-SOLO.jpg

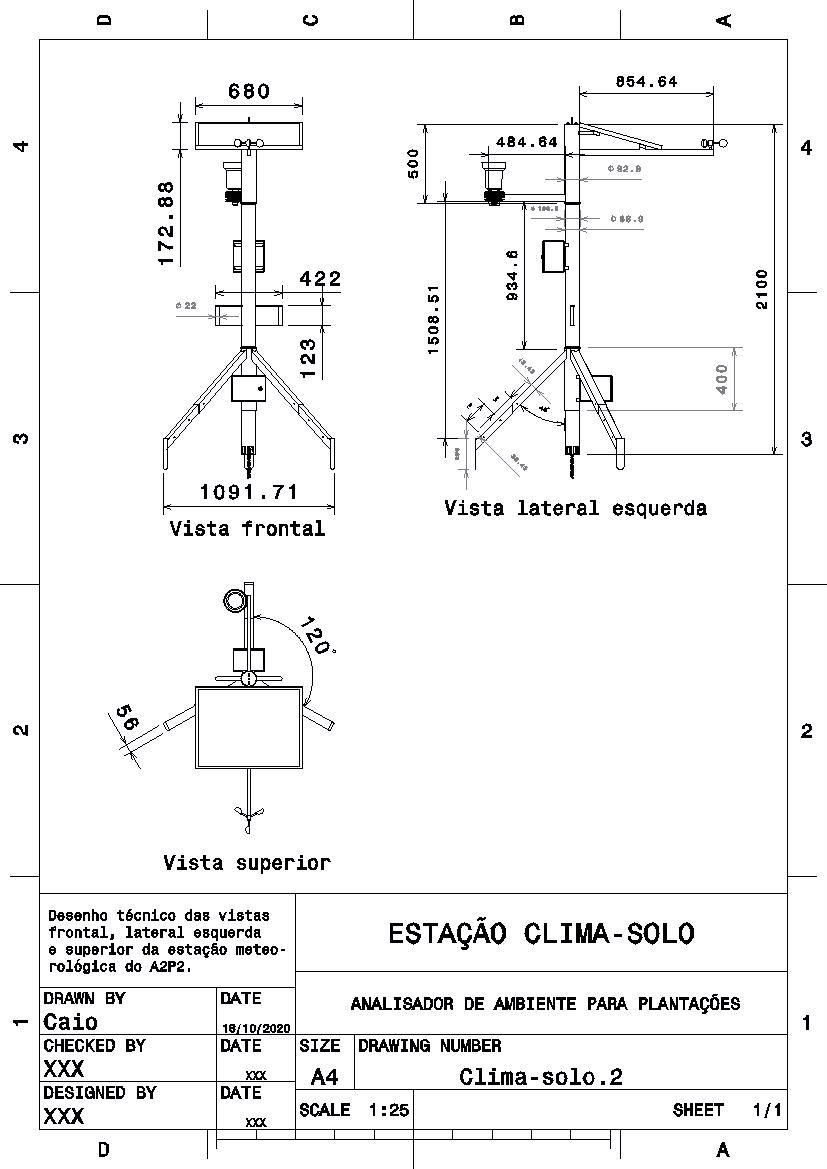
Estrutura/DTs/0_clima_solo/DT2_CLIMA-SOLO.jpg
