PI2-2020-1/documentos/Estrutura/DTs/0_clima_solo/DT4_CLIMA-SOLO-exploded.jpg

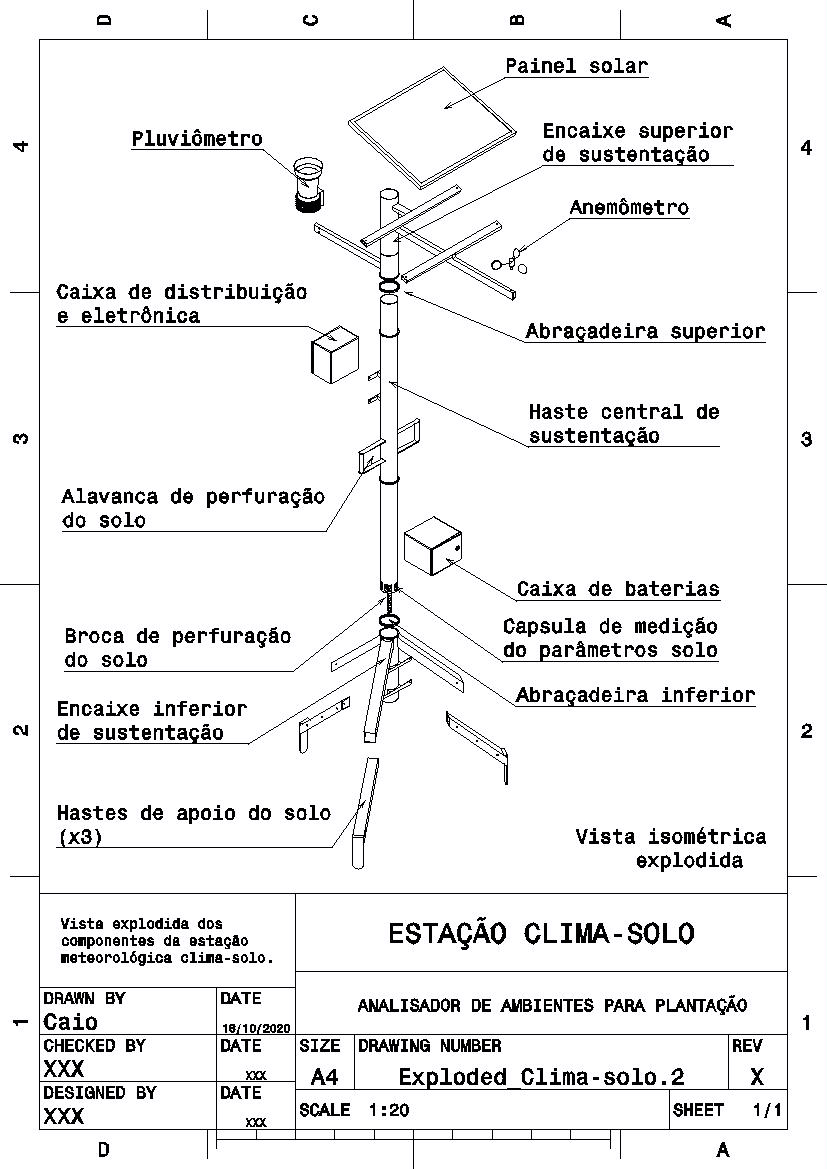
Estrutura/DTs/0_clima_solo/DT4_CLIMA-SOLO-exploded.jpg
