PI2-2020-1/documentos/Estrutura/DTs/0_CORTES_CHAPAS_3MM/CORTES_CHAPAS_3MM.jpg

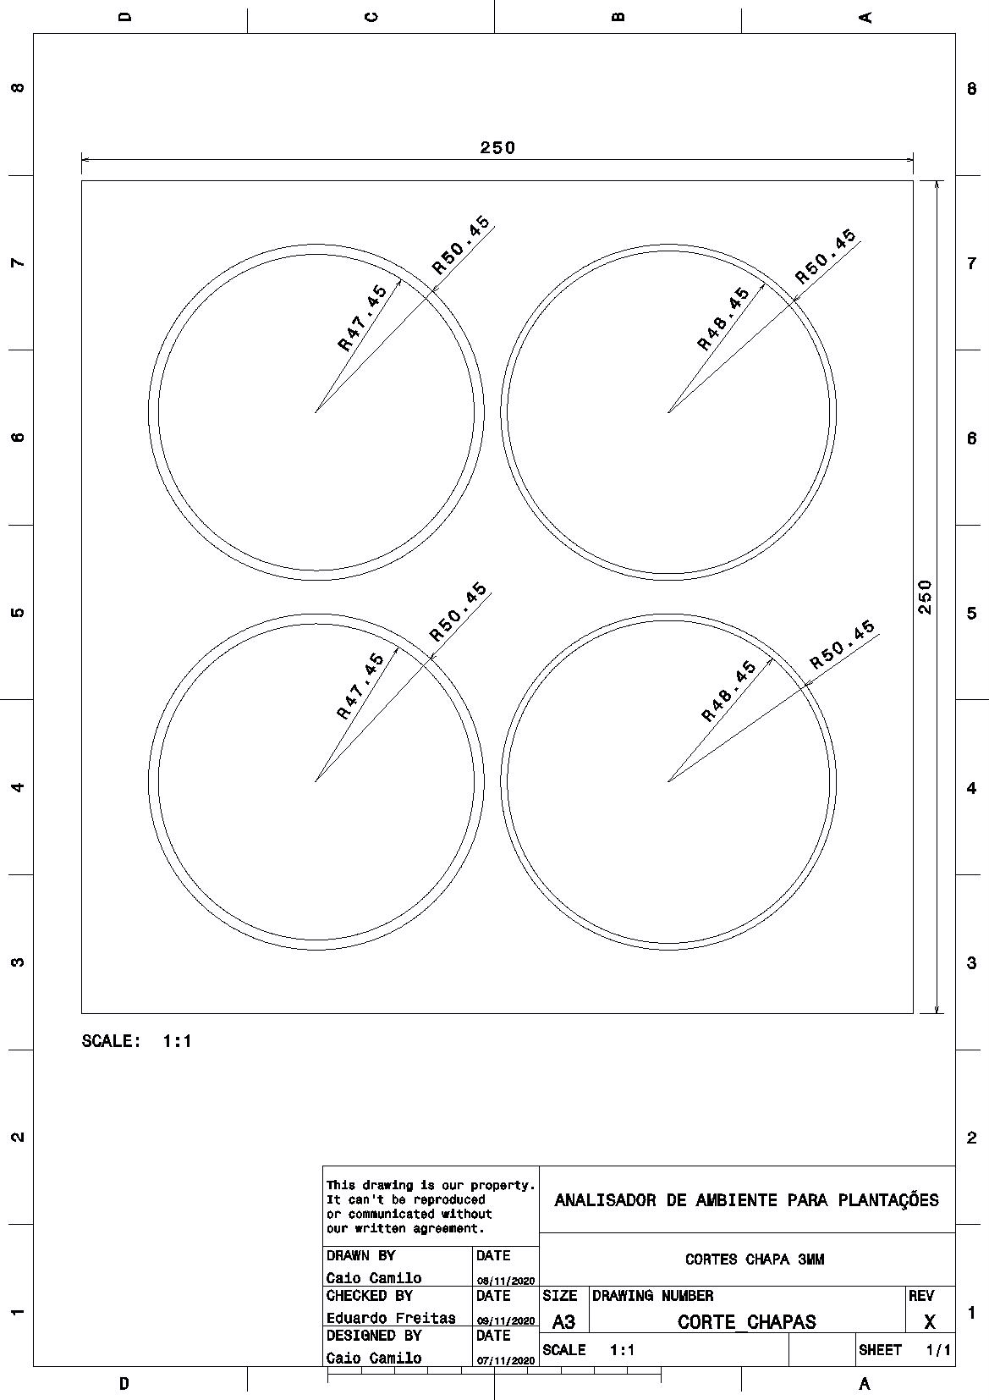
Estrutura/DTs/0_CORTES_CHAPAS_3MM/CORTES_CHAPAS_3MM.jpg
