PI2-2020-1/documentos/Estrutura/DTs/broca_DT06/broca.jpg

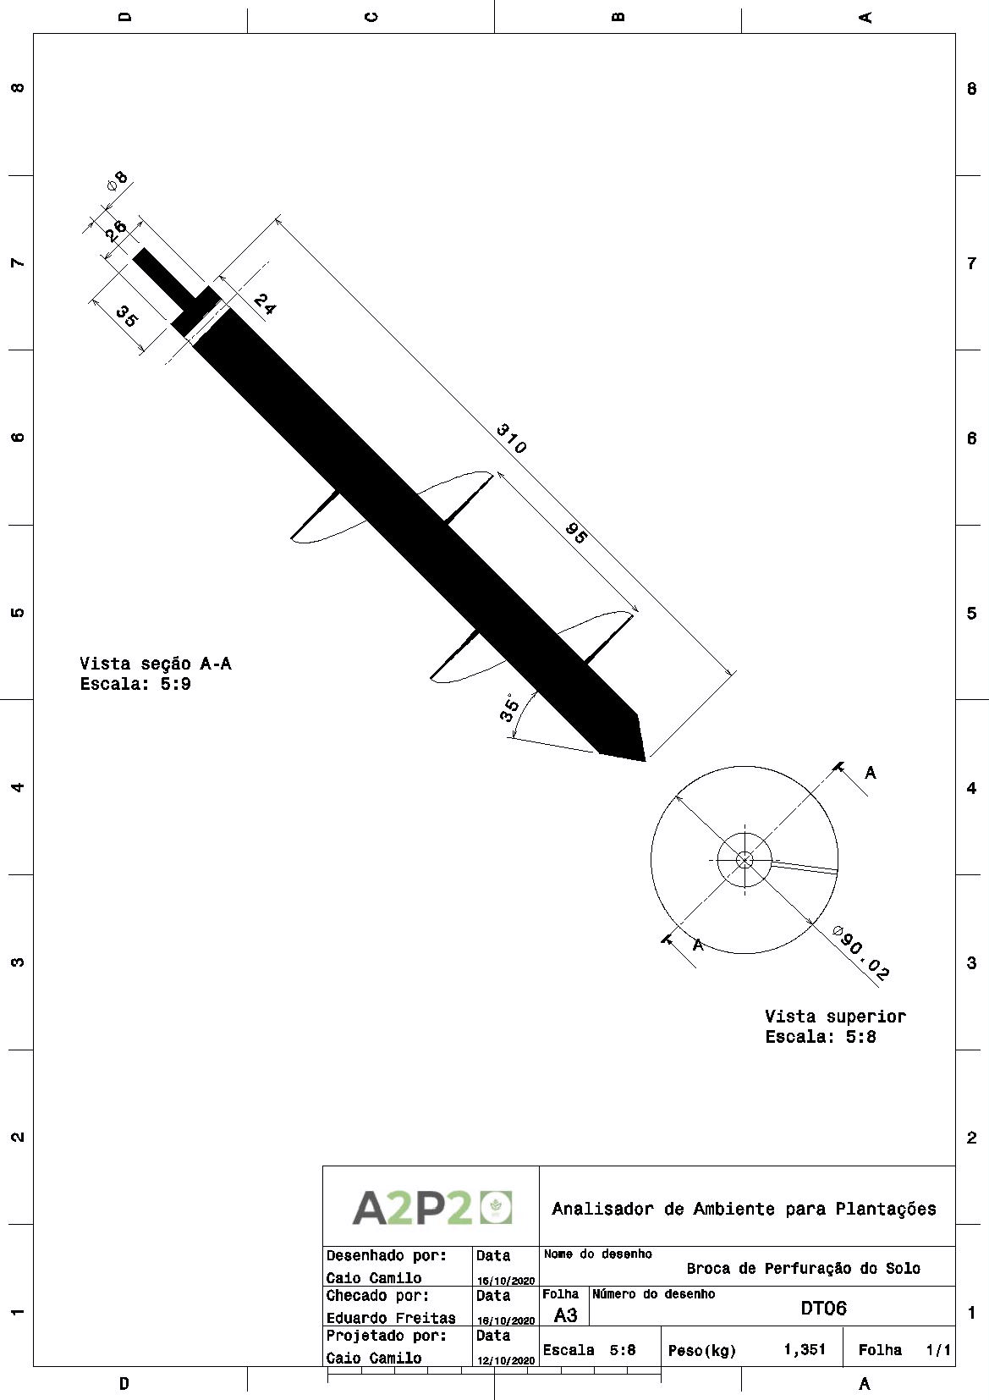
Estrutura/DTs/broca_DT06/broca.jpg
