PI2-2020-1/documentos/Estrutura/DTs/clima-solo_DT07_2/clima-solo.jpg

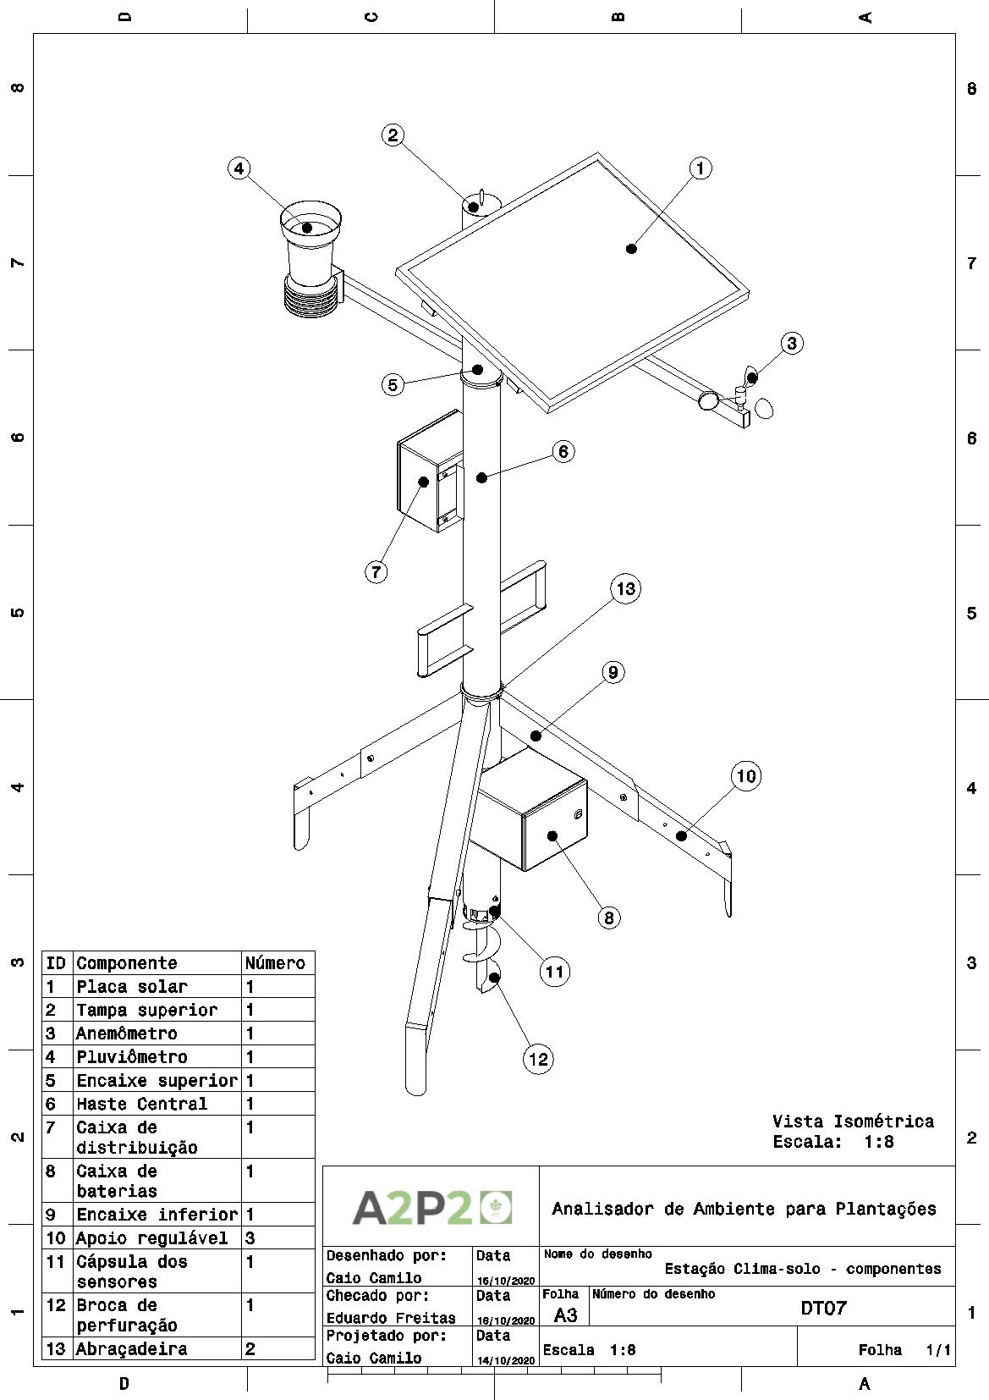
Estrutura/DTs/clima-solo_DT07_2/clima-solo.jpg
