PI2-2020-1/documentos/Estrutura/DTs/encaixe_inferior_DT02/encaixe_inferior.jpg

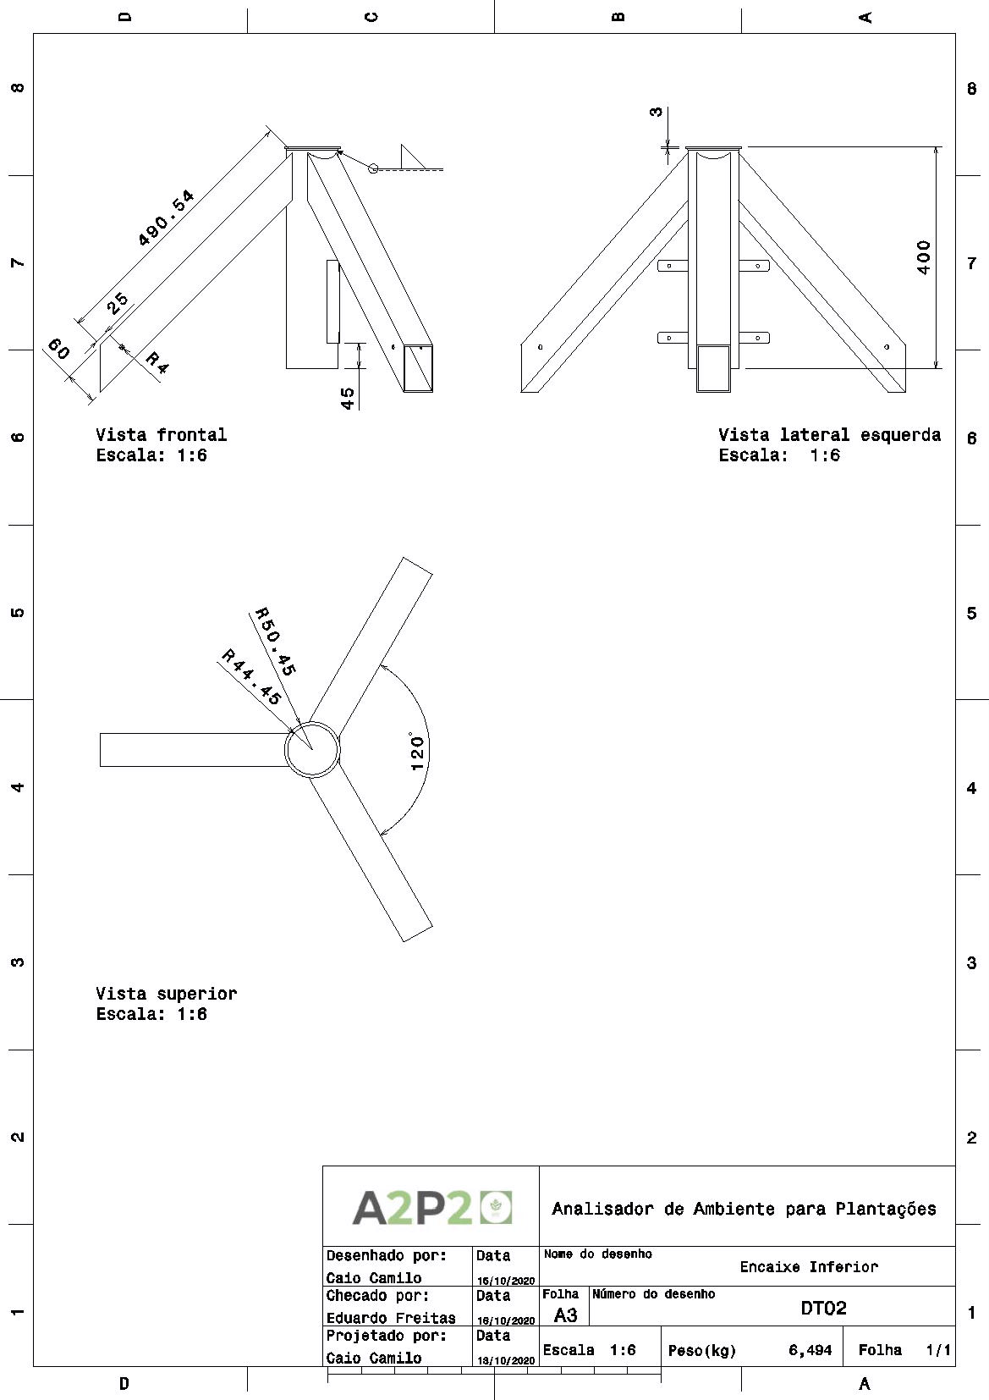
Estrutura/DTs/encaixe_inferior_DT02/encaixe_inferior.jpg
