PI2-2020-1/documentos/Estrutura/DTs/encaixe_superior_DT03/encaixe_superior.jpg

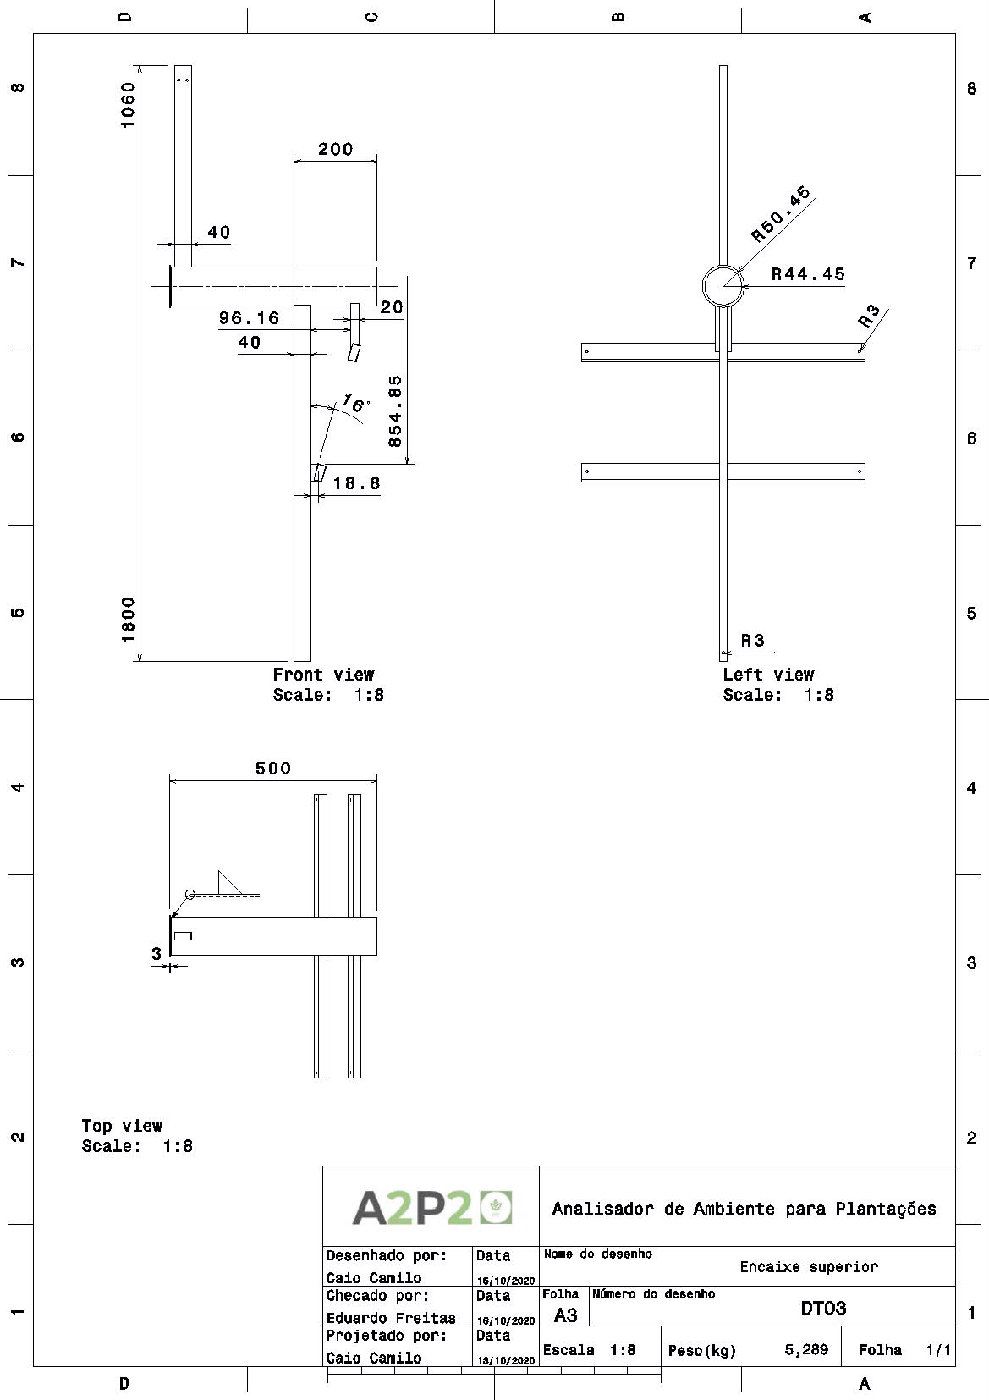
Estrutura/DTs/encaixe_superior_DT03/encaixe_superior.jpg
