PI2-2020-1/documentos/Estrutura/DTs/haste_central_clima_solo_DT01/haste_central_clima_solo.jpg

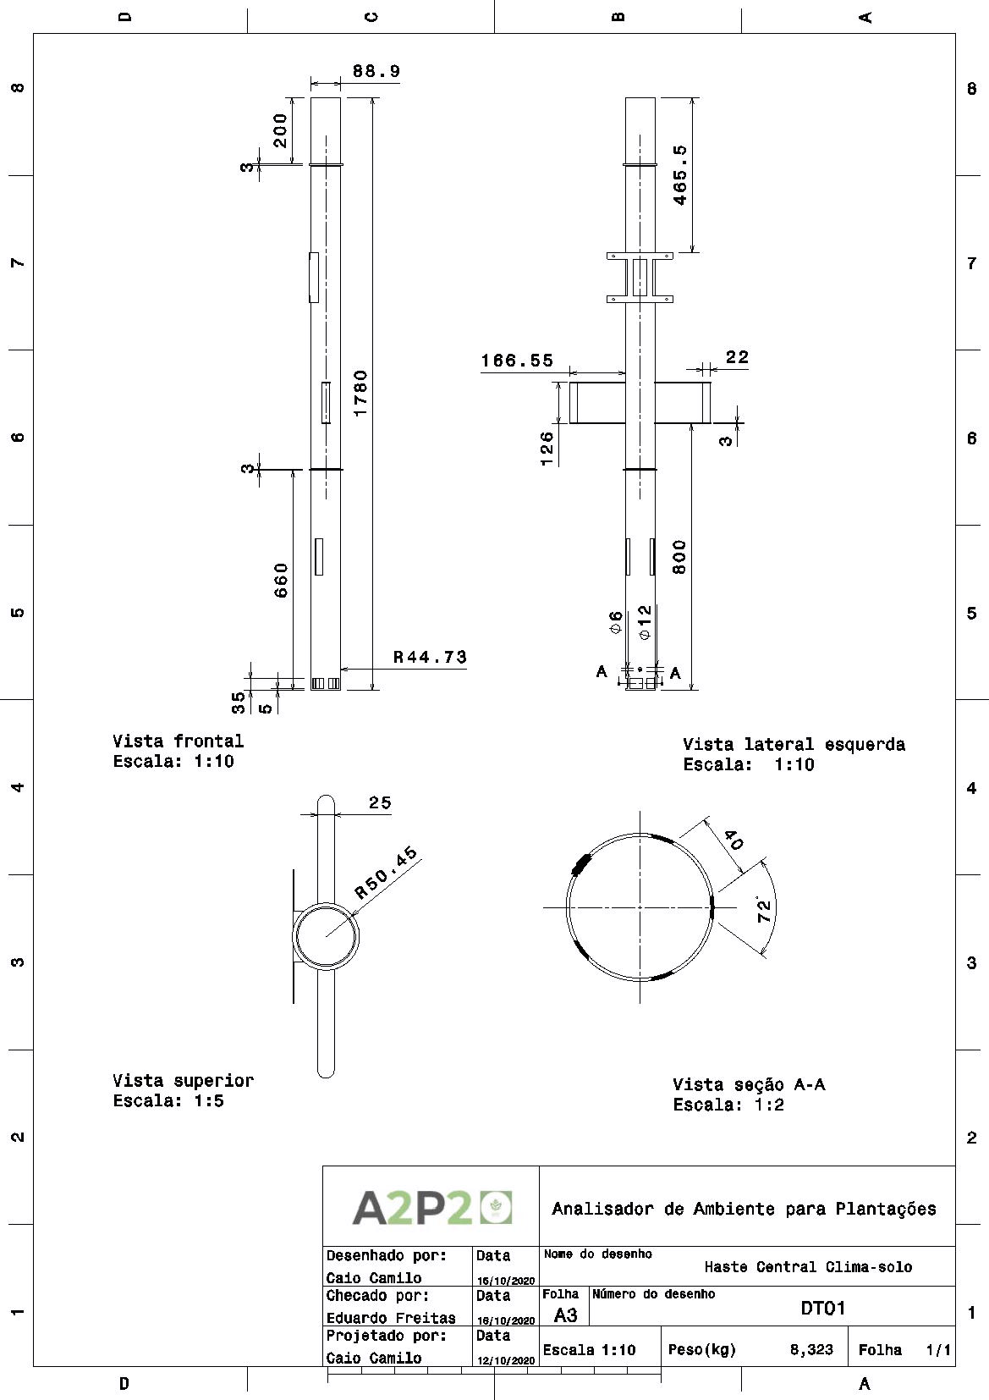
Estrutura/DTs/haste_central_clima_solo_DT01/haste_central_clima_solo.jpg
