PI2-2020-1/documentos/Estrutura/DTs/haste_central_solo_DT10/haste_central_solo.jpg

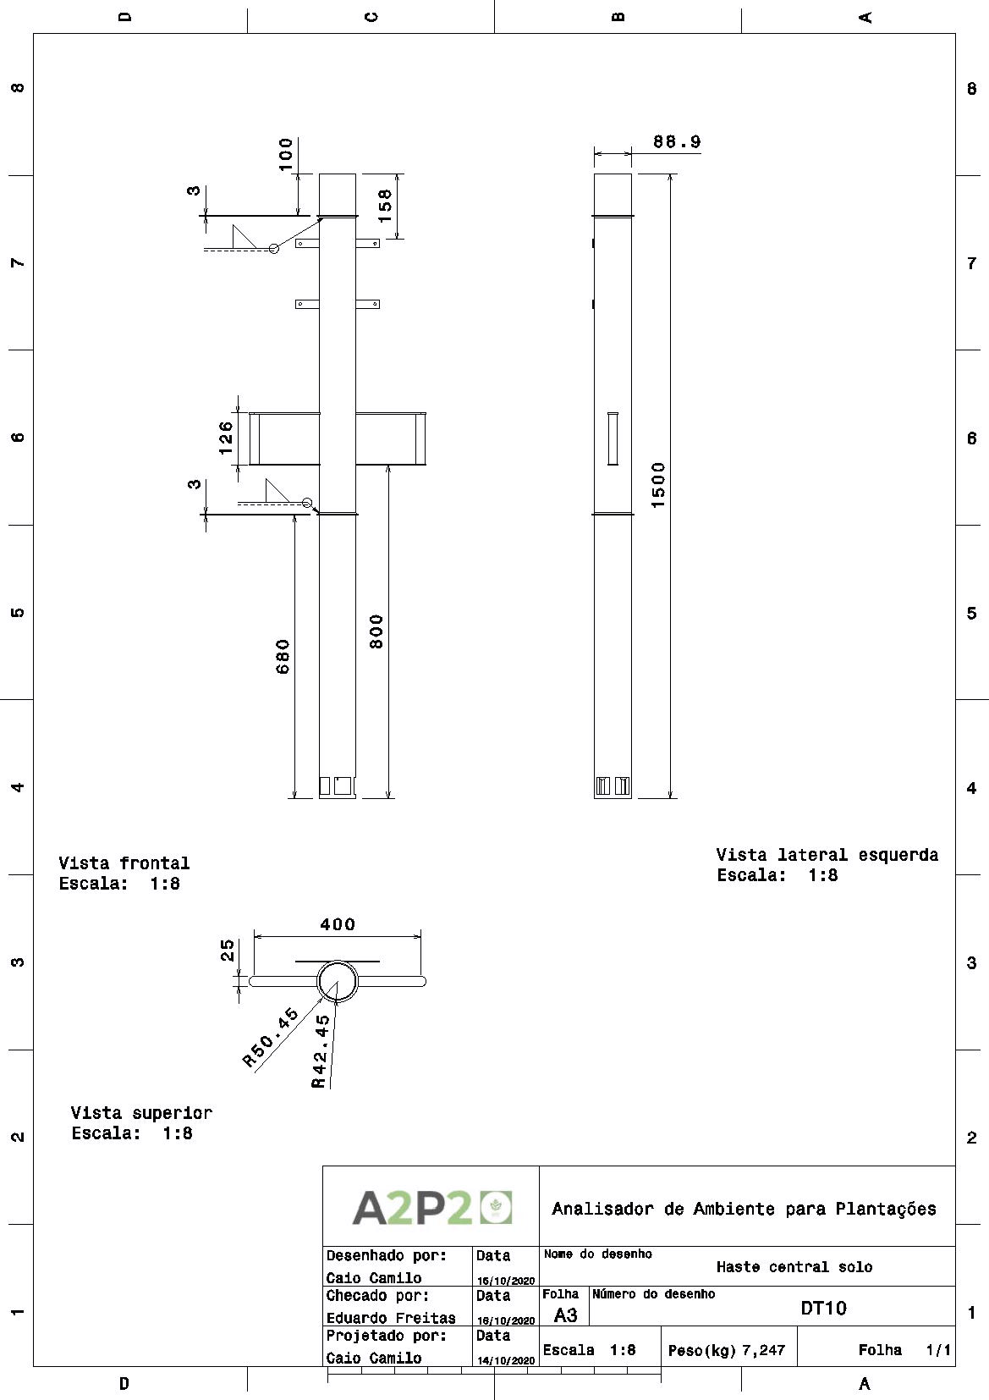
Estrutura/DTs/haste_central_solo_DT10/haste_central_solo.jpg
