PI2-2020-1/documentos/Estrutura/DTs/regulagem_apoio_DT07/regulagem_apoio.jpg

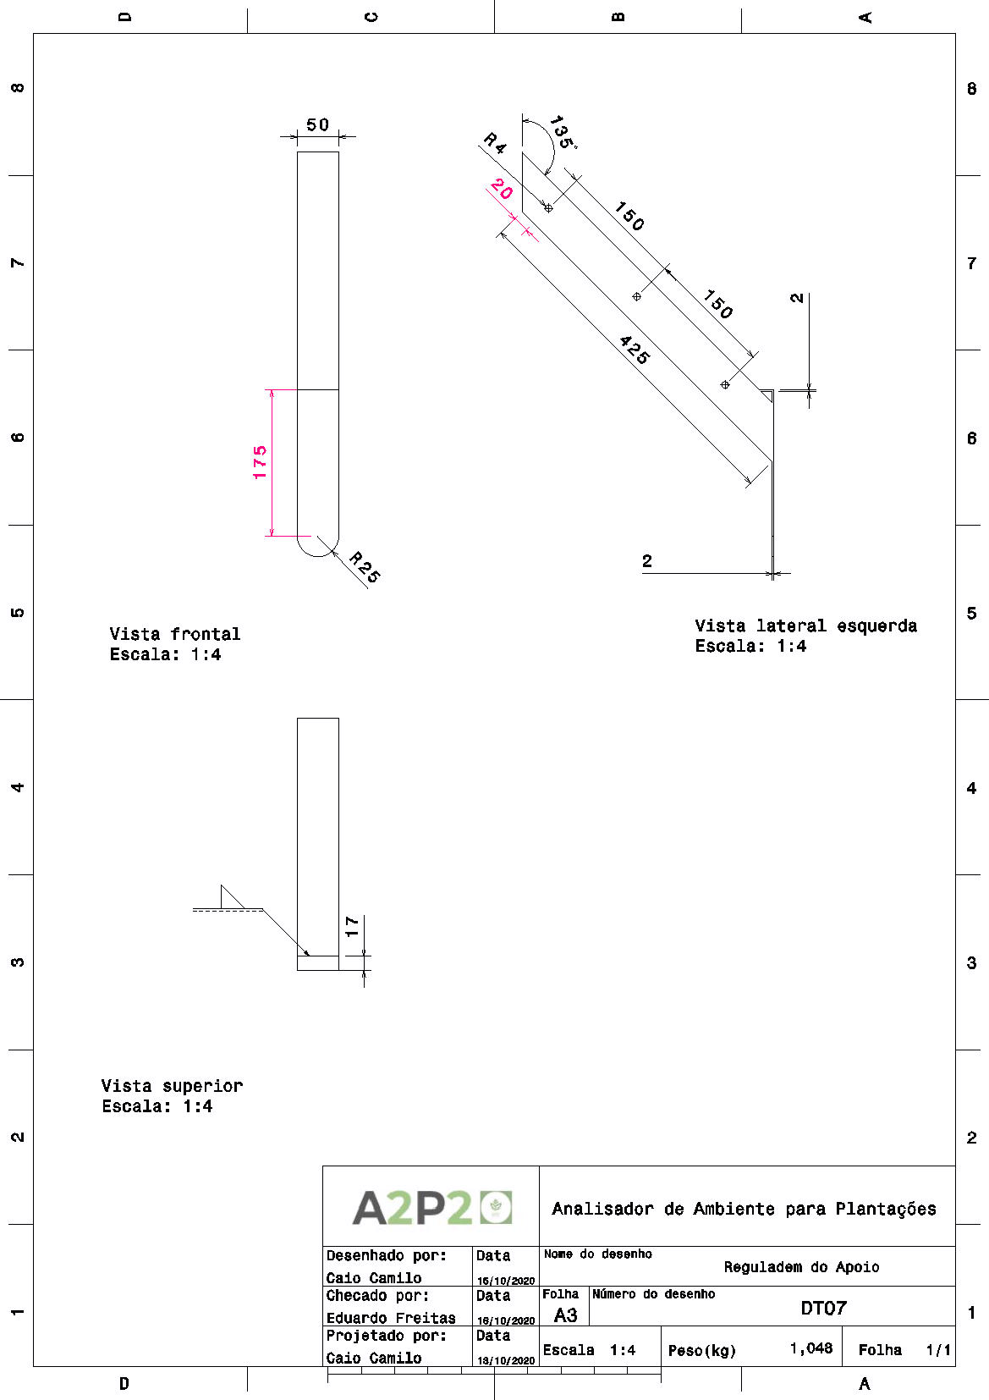
Estrutura/DTs/regulagem_apoio_DT07/regulagem_apoio.jpg
