PI2-2020-1/documentos/Estrutura/DTs/solo_DT09/solo.jpg

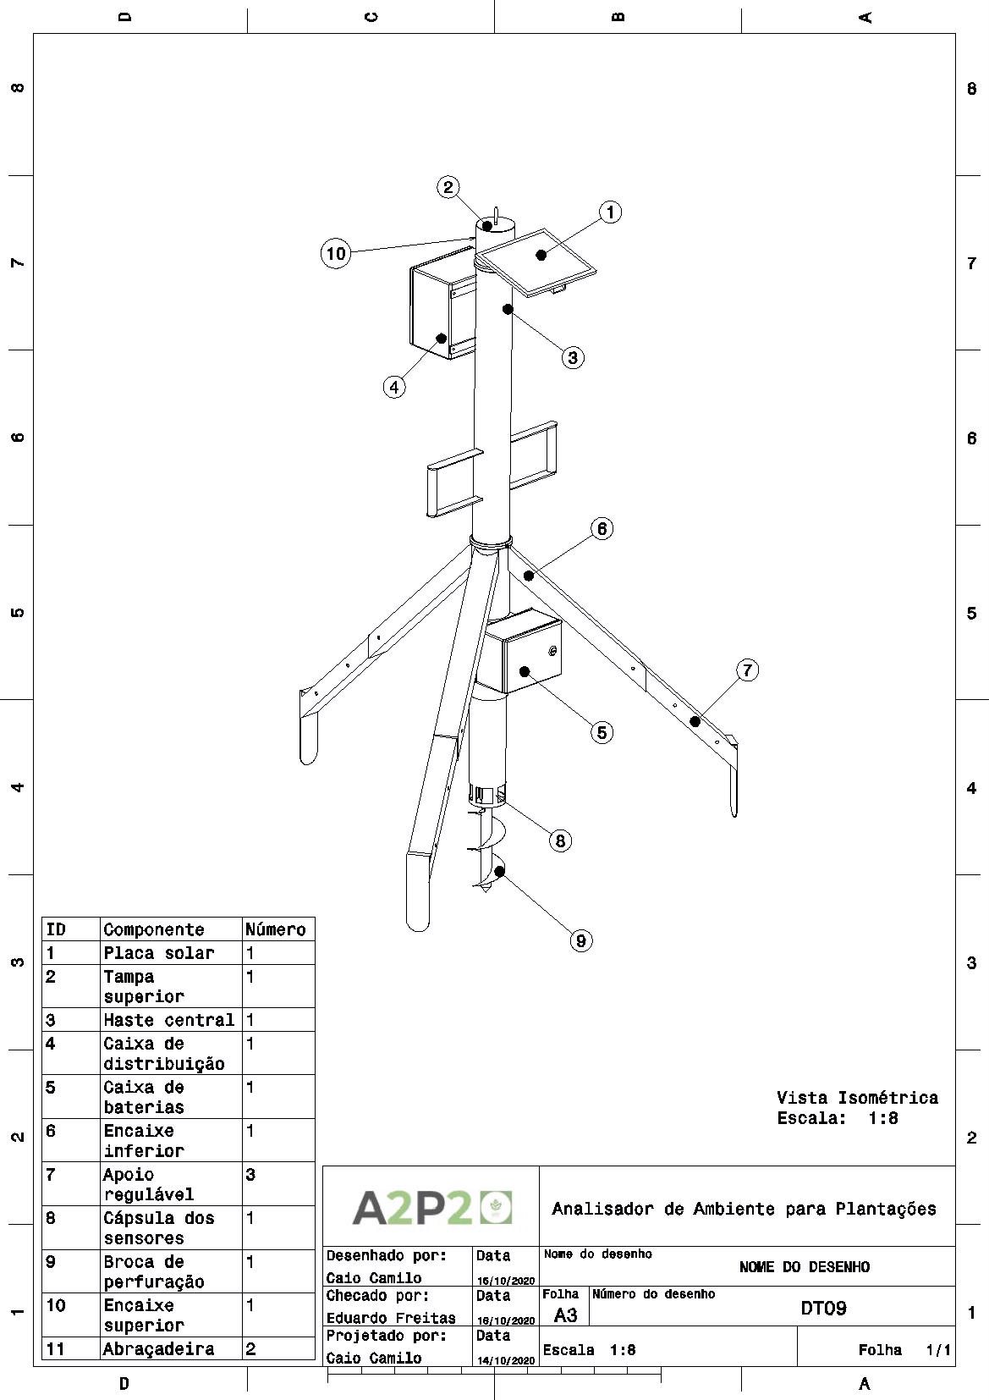
Estrutura/DTs/solo_DT09/solo.jpg
