PI2-2020-1/documentos/Estrutura/DTs/tampa_inferior_DT04/tampa_inferior.jpg

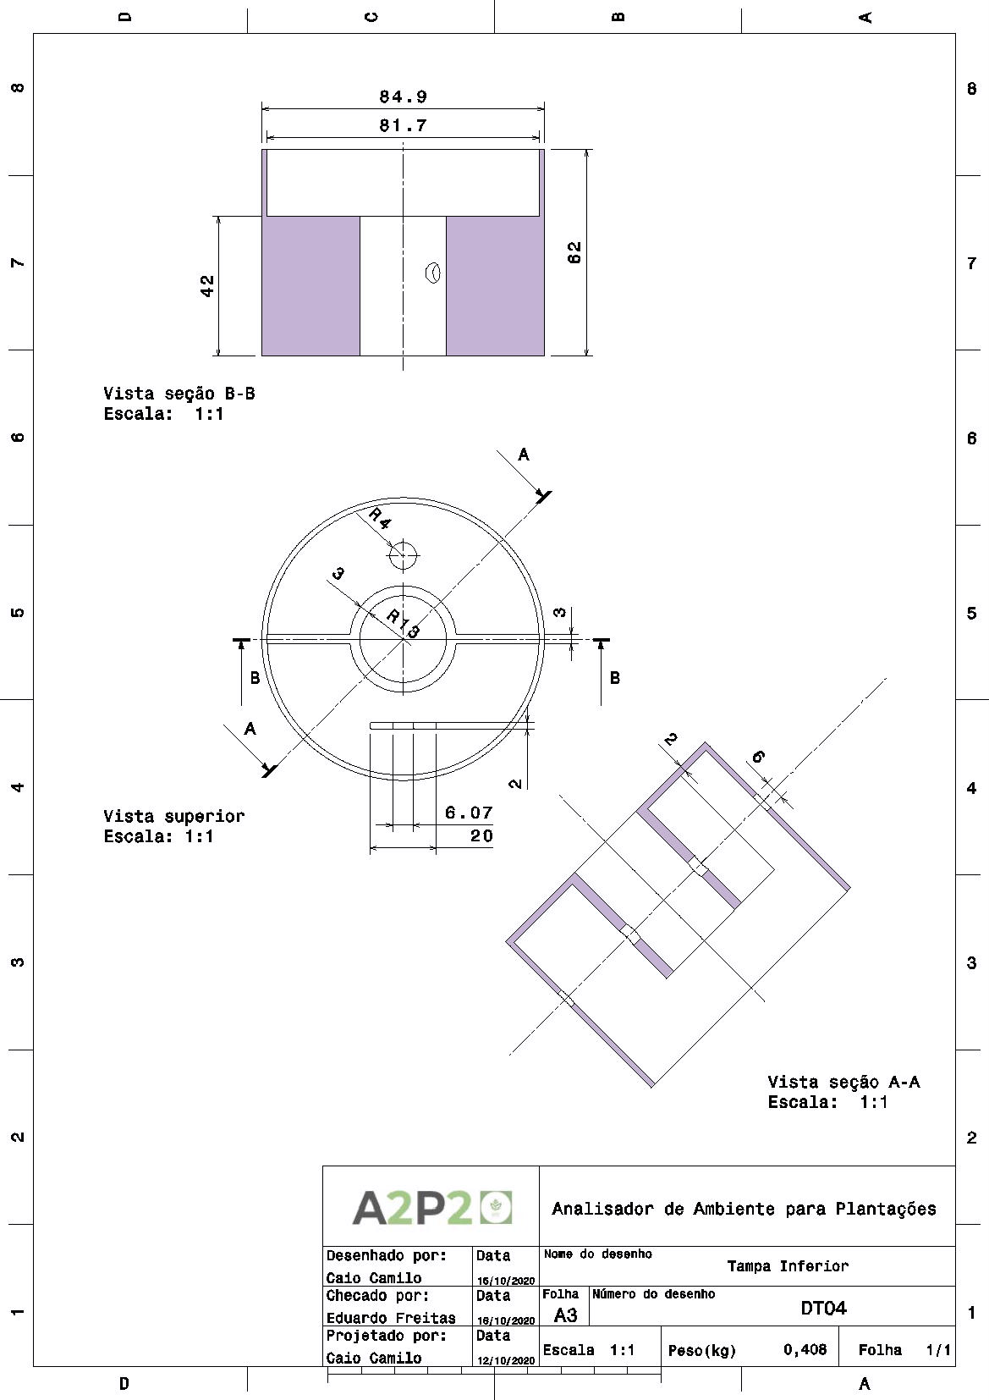
Estrutura/DTs/tampa_inferior_DT04/tampa_inferior.jpg
