PI2-2020-1/documentos/Estrutura/DTs/tampa_superior_DT05/tampa_superior.jpg

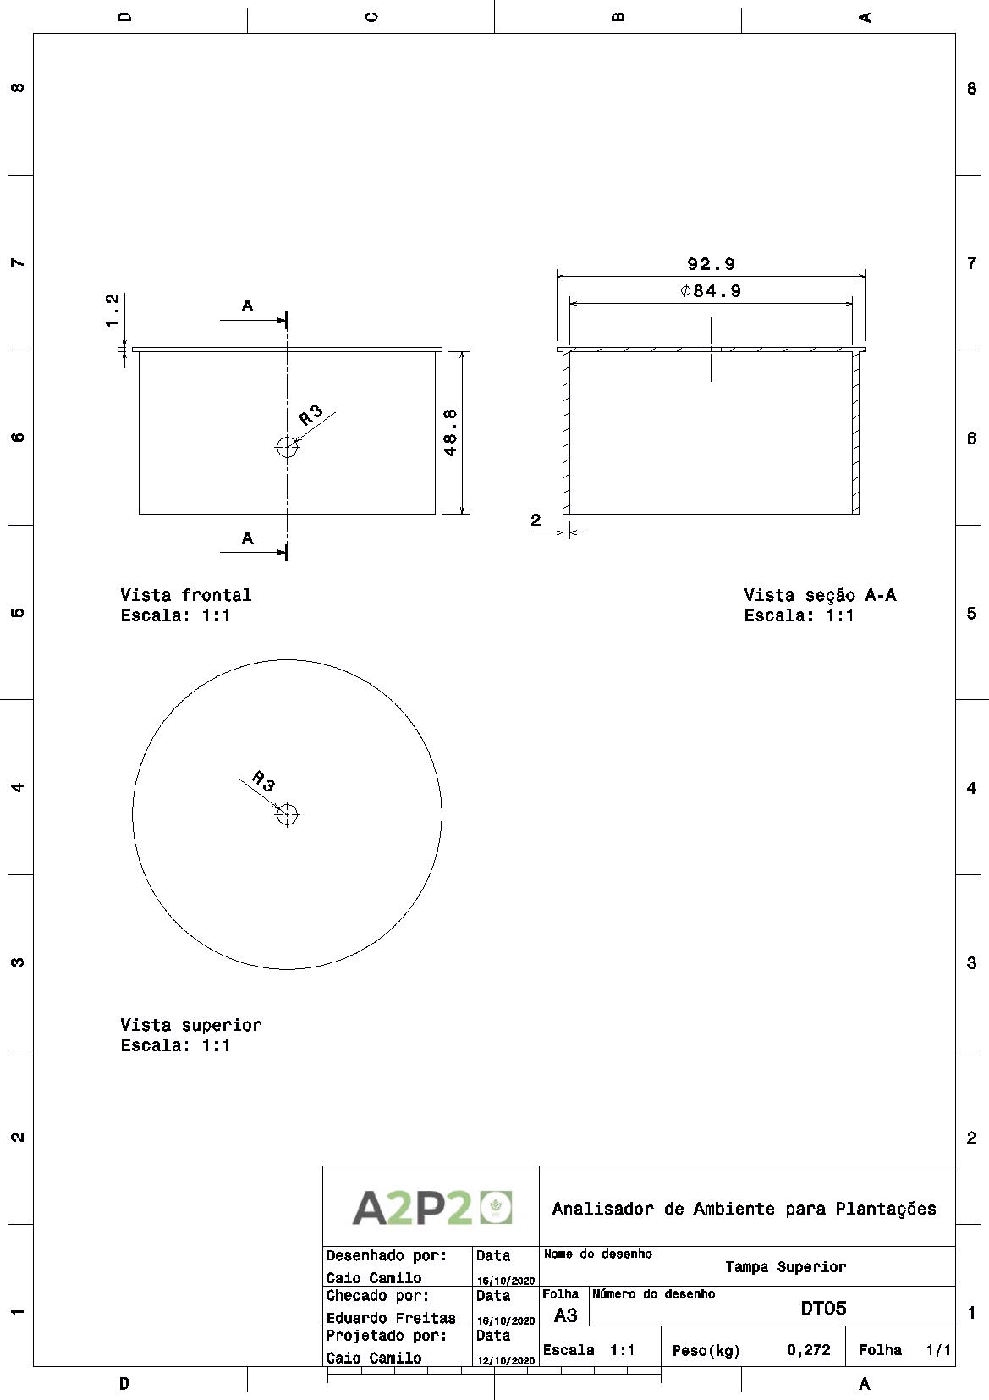
Estrutura/DTs/tampa_superior_DT05/tampa_superior.jpg
