PI2-2020-1/documentos/Estrutura/Simulações/alcas.png

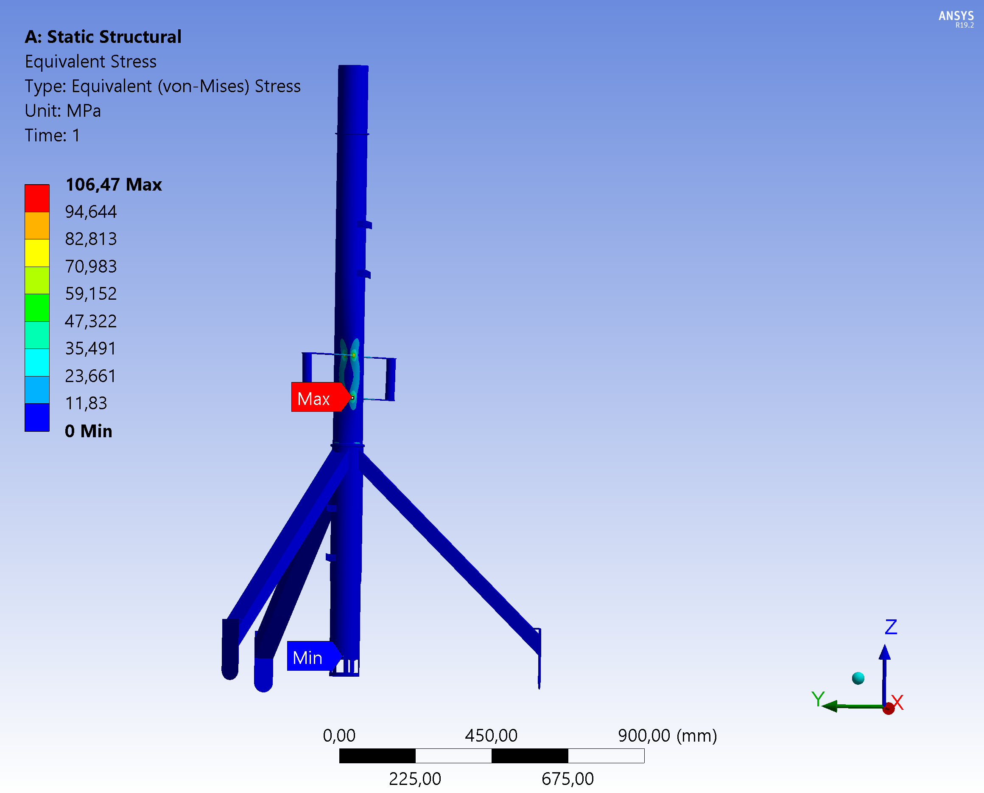
Estrutura/Simulações/alcas.png
