PI2-2020-1/documentos/Estrutura/Simulações/Cargas Aplicadas Na estrutura só do vento.png

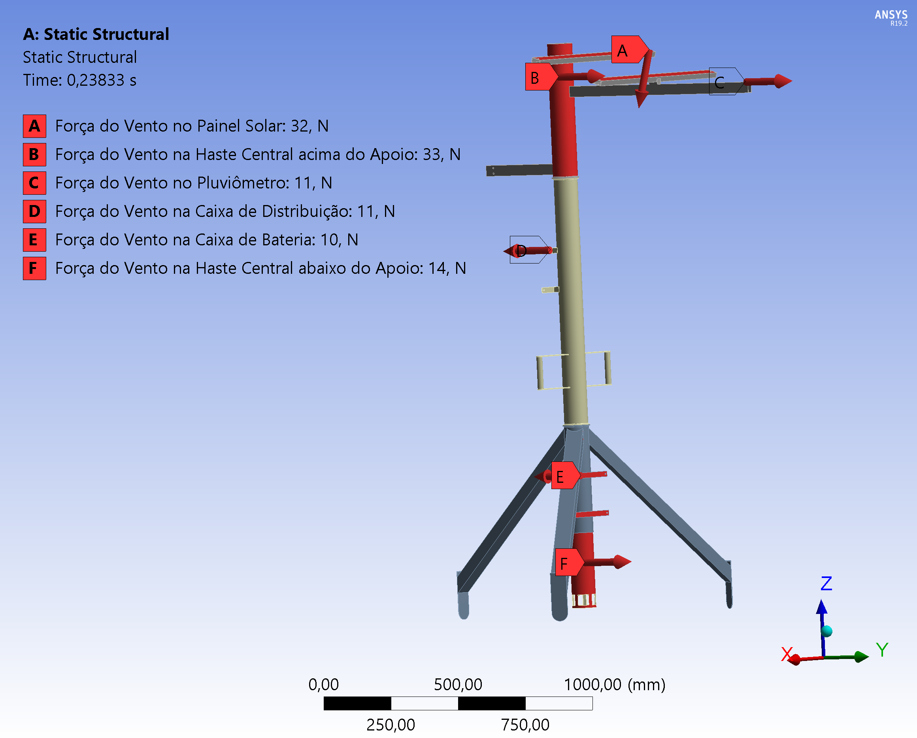
Estrutura/Simulações/Cargas Aplicadas Na estrutura só do vento.png
