PI2-2020-1/documentos/Estrutura/Simulações/Cargas Aplicadas Na estrutura.png

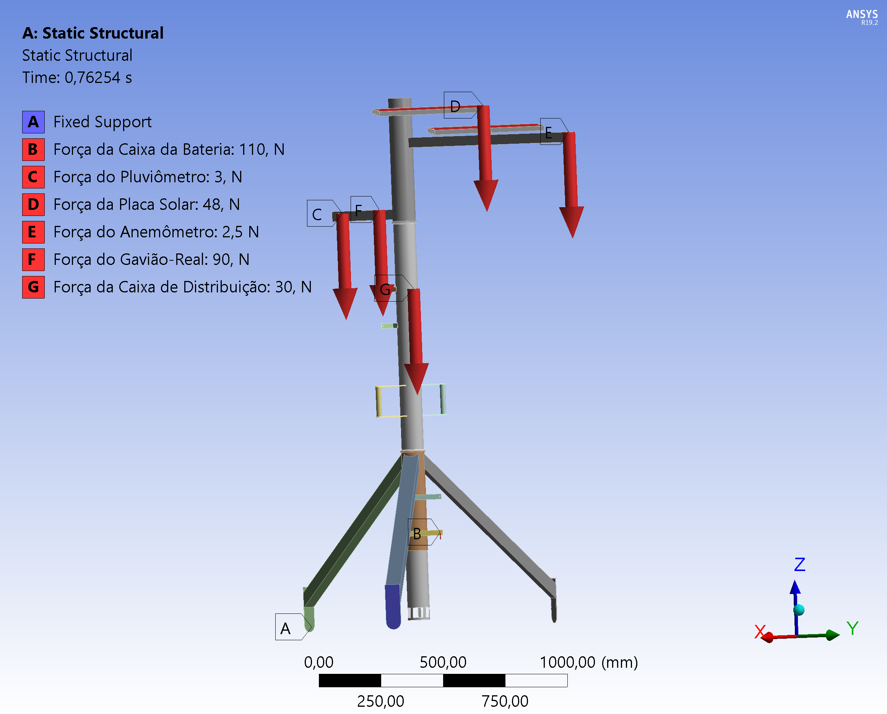
Estrutura/Simulações/Cargas Aplicadas Na estrutura.png
