PI2-2020-1/documentos/Estrutura/Simulações/Forças aplicadas nas alças.png

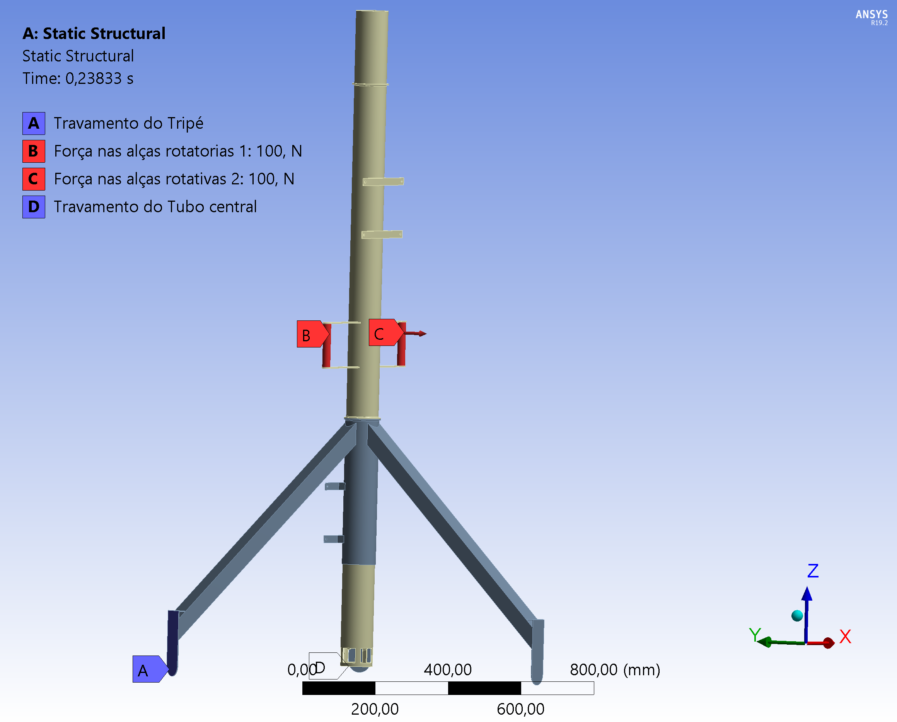
Estrutura/Simulações/Forças aplicadas nas alças.png
