PI2-2020-1/documentos/Estrutura/Simulações/malha.png

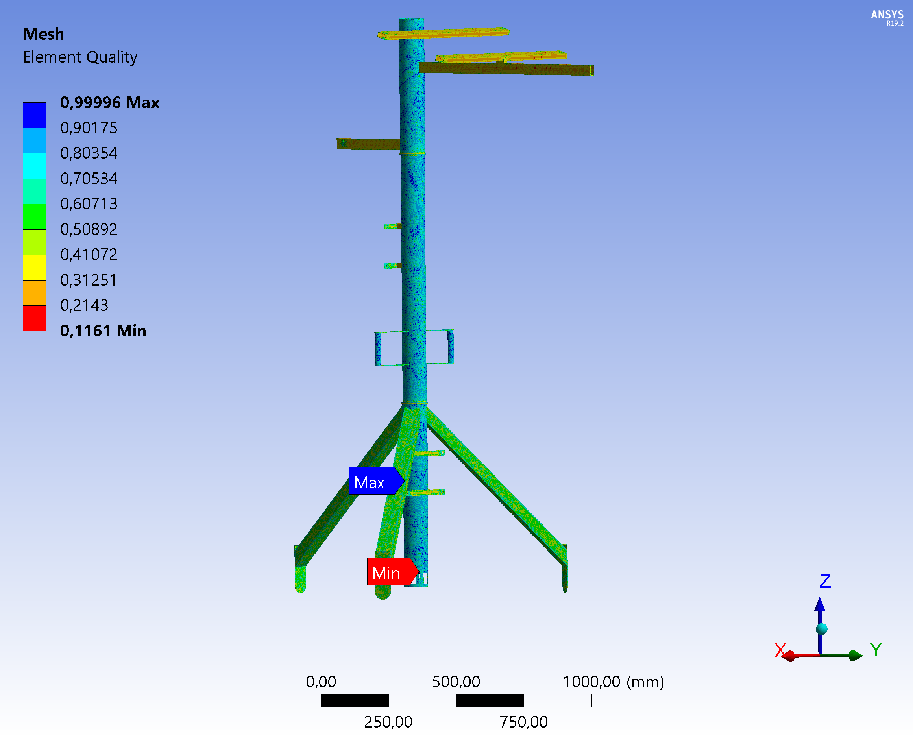
Estrutura/Simulações/malha.png
