PI2-2020-1/documentos/Software/Conceitual.png

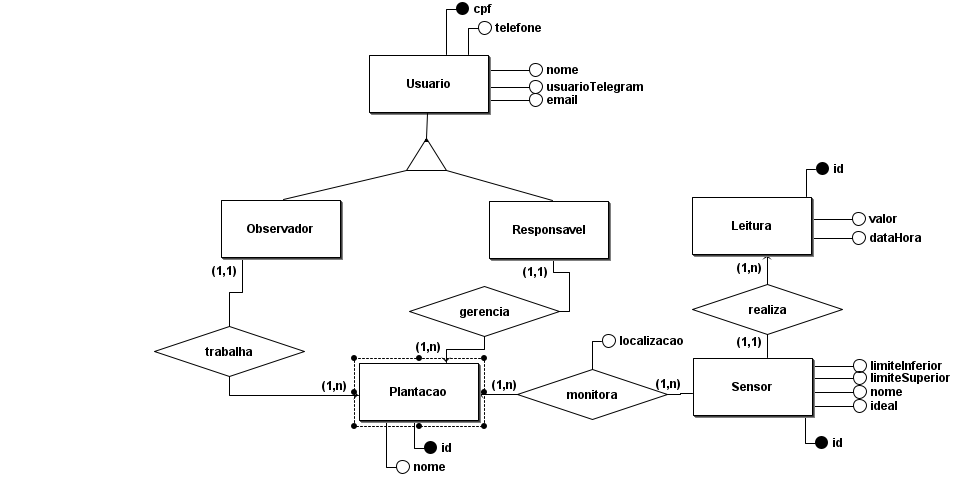
Software/Conceitual.png
