PI2-2020-1/documentos/Estrutura/Lista de Materiais.xlsx

Estação Clima/Solo
Elemento | Número de peças | Quantidade | Unidade | Preço unidade | Total preço | Link | Espessura / parede (m) | Tipo | Valor efetivo (m/m^2) / Comprimento (m) | Diâmetro Externo (m) | (in) | Diâmetro Interno (m) | (in) | Largura (m) | Altura (m)
Tubo haste central 3,5" | 1 | 2.08 | m | R$445.00 | R$925.60 | https://produto.mercadolivre.com.br/MLB-1190591746-tubo-aco-inox-316l-od-ccost-polido-pipeesp-2mm-dn-3-_JM | 0.002 | Tubo | 2.080 | 88.9 | 3.5 | - | - | - | - | o
Tubo de apoios externo superior 3,7" | 1 | 0.50 |  | R$480.00 | R$240.00 |  | 0.002 | Tubo | 0.500 | 92.9 | 3.7 | - | - | - | - | o
Tubo de apoios externo inferior 3,7" | 1 | 0.40 |  | R$480.00 | R$192.00 |  | 0.002 | Tubo | 0.400 | 92.9 | 3.7 | - | - | - | - | o
Tubo alavanca 1" | 2 | 0.24 |  | R$75.00 | R$18.00 |  | 0.0012 | Tubo | 0.120 | 0.0254 | 1.0 | - | - | - | -
Metalon 6 m (40x20X1,2) mm | 1 | 2.16 | m | R$215.00 | R$463.54 |  | 0.0012 | Metalon | 2.156
Metalon pluviômetro e bme | 1 | 0.48 |  | R$215.00 | R$104.28 | https://casaserralheiro.com.br/product/metalon-em-aco-inox/?attribute_pa_dimensoes=40x15x120mm | 0.0012 | Metalon | 0.485 |  |  |  |  | 0.04 | 0.02 | o
Metalon anemômetro | 1 | 0.85 |  | R$215.00 | R$183.82 |  | 0.0012 | Metalon | 0.855 |  |  |  |  | 0.04 | 0.02 | o
Metalon placa solar | 1 | 0.12 |  | R$215.00 | R$24.94 |  | 0.0012 | Metalon | 0.116 |  |  |  |  | 0.04 | 0.02 | o
Metalon placa solar transversal | 2 | 1.36 |  | R$215.00 | R$292.40 |  | 0.0012 | Metalon | 0.680 |  |  |  |  | 0.04 | 0.02 | o
Metalon placa solar apoio | 1 | 0.02 |  | R$215.00 | R$4.30 |  | 0.0012 | Metalon | 0.020 |  |  |  |  | 0.04 | 0.02 | o
Metalon apoio inferior (60x60) mm | 3 | 1.50 | m | R$203.00 | R$304.50 |  | 0.0016 | Metalon | 0.500 | - | - | - | - | 0.60 | 0.60 | o
Metalon pé (50x50) mm | 3 | 1.20 |  | R$192.00 | R$230.40 |  | 0.0016 | Metalon | 0.400 | - | - | - | - | 0.50 | 0.50 | o
Arranjo dos cortes em chapa 2 mm | 1 | 0.21 | m^2 | R$1929.00 | R$414.74 |  | 0.002 | Chapa | 0.2150 | - | - | - | - | 0.43 | 0.50
Chapa antena | 1 | 0.05 |  |  |  |  | 0.002 | Chapa | - | 0.0929 | 3.7 | 0.06 | 0.002 | - | - | o
Chapa fundo | 1 | 0.04 |  |  |  |  | 0.002 | Chapa | - | 0.0845 | 3.3 | 0.007408 | 0.0002916535433 | - | - | o
Chapa caixas fixação | 2 | 0.03 |  |  |  |  | 0.002 | Chapa | - | - | - | - | - | 0.20 | 0.15 | o
Chapa caixas lateral tubo | 4 | 0.04 |  |  |  |  | 0.002 | Chapa | - | - | - | - | - | 0.03 | 0.15 | o
Chapa caixas bocal de lobo tubo | 4 | 0.02 |  |  |  |  | 0.002 | Chapa | - | - | - | - | - | 0.08 | 0.25 | o
Chapas das alavancas | 4 | 0.04 |  |  |  |  | 0.002 | Chapa | - | - | - | - | - | 0.17 | 0.25 | o
Arranjo dos cortes em chapa 3 mm | 1 | 0.06 | m^2 | R$2893.00 | R$180.81 |  | 0.003 | Chapa | 0.0625 | - | - | - | - | 0.25 | 0.25 | o
Chapa batente do tubo da haste central | 2 | 0.03 |  |  |  | produto.mercadolivre.com.br/MLB-721825698-chapa-inox-316l-90cm-x-60cm''-para-hho-garantia-e-certificado-_JM#position=1&type=item&tracking_id=efe615da-208f-4379-b97e-9dbe992b523d | 0.003 | Chapa | - | 0.1009 | 4.0 | 0.0949 | 0.003736220472 | - | - | o
Chapa batente do tubo de apoio | 2 | 0.03 |  |  |  |  | 0.003 | Chapa | - | 0.1009 | 4.0 | 0.0969 | 0.00381496063 | - | - | o
Broca Escavadeira 90x300 mm | 1 | 1.00 | unid. | R$80.20 | R$80.20 | https://br.banggood.com/Drillpro-9x25304560cm-Garden-Auger-Small-Earth-Planter-Drill-Bit-Post-Hole-Digger-Earth-Planting-Auger-Drill-Bit-for-Electric-Drill-p-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 | - | Broca |  | 15.875 | 0.6 |  |  |  |  | o
Abraçadeira V-band 3,5" | 2 | 2.00 |  | R$41.00 | R$82.00 | https://produto.mercadolivre.com.br/MLB-988741016-abracadeira-de-2-polegadas-100-inox-v-band-v-clamp-_JM | - | Abraçadeira | 2.000 |  |  |  |  |  |  | o
Parafuso M6x16 Sextavado Interno | 8 | 8.00 |  | R$1.25 | R$10.00 |  | - | Parafuso | 8.000 |  |  |  |  |  |  | o
Parafuso M6x30 Sextavado Interno | 6 | 6.00 |  | R$1.75 | R$10.50 |  | - | Parafuso | 6.000 |  |  |  |  |  |  | o
Parafuso M6x50 Sextavado Interno | 1 | 1.00 |  | R$1.85 | R$1.85 |  | - | Parafuso | 1.000 |  |  |  |  |  |  | o
Parafuso M8x70 Sextavado Interno | 3 | 3.00 |  | R$2.80 | R$8.40 |  | - | Parafuso | 3.000 |  |  |  |  |  |  | o
Porca M6 | 14 | 14.00 |  | R$0.60 | R$8.40 |  | - | Porca | 14.000 |  |  |  |  |  |  | o
Porca M8 | 3 | 3.00 |  | R$0.80 | R$2.40 |  | - | Porca | 3.000 |  |  |  |  |  |  | o
Anel vedativo 3,5" | 1 | 1.00 |  | R$30.00 | R$30.00 |  | - | Anel | 1.000 |  |  |  |  |  |  | o
Caixa de distribuição | 1 | 1.00 |  | R$114.00 | R$114.00 | https://produto.mercadolivre.com.br/MLB-1392821946-caixa-painel-eletrico-20x20x14-quadro-comando-hermetica-_JM | - | Caixa | 1.000 |  |  |  |  | 0.20 | 0.20 | o
Tampa de acabamento para metalon 40x20 | 6 | 6.00 |  | R$1.00 | R$6.00
Caixa de baterias | 1 | 1.00 |  | R$156.00 | R$156.00 | https://produto.mercadolivre.com.br/MLB-1237958582-caixa-de-montagem-30x20x20-painel-eletrico-quadro-comando-_JM | - | Caixa | 1.000 |  |  |  |  | 0.21 | 0.17 | o
Organizador de Fios 12,4 mm | 1 | 5.00 | m | R$1.63 | R$8.15 | https://produto.mercadolivre.com.br/MLB-1415433270-100-mt-guaina-organizador-preto-espiral-tubo-guia-124mm-_JM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
Termoretrátil 5 mm | 1 | 5.00 | m | R$1.20 | R$6.00 | https://produto.mercadolivre.com.br/MLB-1577349320-64mm-preto-termo-retratil-padro-rolo-25-metros-cnf-_JM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
Total |  |  |  |  | R$4097.23
Estação Solo
Elemento | Número de peças | Quantidade | Unidade | Preço unidade | Total preço
Tubo haste central 3,5" | 1 | 1.50 | m | R$445.00 | R$667.50
Tubo de apoios externo superior 3,7" | 1 | 0.12 |  | R$480.00 | R$60.00
Tubo de apoios externo inferior 3,7" | 1 | 0.40 |  | R$480.00 | R$192.00
Tubo alavanca 1" | 2 | 0.24 |  | R$75.00 | R$18.00
Metalon 6 m (40x20X1,2) mm | 1 | 0.50 | m | R$215.00 | R$107.50
Metalon apoio inferior (60x60) mm | 3 | 1.50 | m | R$203.00 | R$304.50
Metalon pé (50x50) mm | 3 | 1.20 |  | R$192.00 | R$230.40
Arranjo dos cortes em chapa 2 mm | 1 | 0.22 | m^2 | R$1929.00 | R$424.38
Chapa antena | 1 | 0.05
Chapa fundo | 1 | 0.04
Chapa caixas fixação | 2 | 0.03
Chapa caixas lateral tubo | 4 | 0.04
Chapa caixas bocal de lobo tubo | 4 | 0.02
Chapas das alavancas | 4 | 0.04
Arranjo dos cortes em chapa 3 mm | 1 | 0.06 | m^2 | R$2893.00 | R$173.58
Chapa batente do tubo da haste central | 2 | 0.03
Chapa batente do tubo de apoio | 2 | 0.03
Broca Escavadeira 90x300 mm | 1 | 1.00 | unid. | R$80.20 | R$80.20
Abraçadeira V-band 3,5" | 2 | 2.00 |  | R$41.00 | R$82.00
Parafuso M6x16 Sextavado Interno | 6 | 6.00 |  | R$1.25 | R$7.50
Parafuso M6x30 Sextavado Interno | 4 | 4.00 |  | R$1.75 | R$7.00
Parafuso M6x50 Sextavado Interno | 1 | 1.00 |  | R$1.85 | R$1.85
Parafuso M8x70 Sextavado Interno | 3 | 3.00 |  | R$2.80 | R$8.40
Porca M6 | 14 | 14.00 |  | R$0.60 | R$8.40
Tampa de acabamento para metalon 40x20 | 6 | 6.00 |  | R$1.00 | R$6.00
Porca M8 | 3 | 3.00 |  | R$0.80 | R$2.40
Anel vedativo 3,5" | 1 | 1.00 |  | R$30.00 | R$30.00
Caixa de distribuição | 1 | 1.00 |  | R$114.00 | R$114.00
Caixa de baterias | 1 | 1.00 |  | R$156.00 | R$156.00
Organizador de Fios 12,4 mm | 1 | 5.00 | m | R$1.63 | R$8.15
Termoretrátil 5 mm | 1 | 5.00 | m | R$1.20 | R$6.00
Total |  |  |  |  | R$2695.76
