PI2-2020-1/documentos/Finanças/Custos.xlsx

Ítem | Quantidade | Preço (Reais) | Total
Sensor de pH do solo | 2 | 178.50 | 357.00
Sensor de Umidade do solo | 2 | 9.90 | 19.80
Anemômetro | 1 | 237.03 | 237.03
Pluviômetro | 1 | 265.53 | 265.53
Sensor bme280 | 1 | 30.99 | 30.99
Esp 32 | 2 | 42.00 | 84.00
Módulo GSM | 2 | 179.00 | 358.00
Painel fotovoltaico | 2 | 21.87 | 43.74
Bateria | 2 | 79.50 | 159.00
Controlador de carga | 2 | 89.00 | 178.00
Metalon (30 x 30 x 2) mm | 6 m | 70.50 | 70.50
Metalon (60 x 60 x 2) mm | 6 m | 185.00 | 185.00
Tinta Anticorrosiva | 1 | 79.60 | 79.60
Chapa de aço | 1 m2 | 60.00 | 60.00
Kit Parafusos e porcas | 1 | 40.00 | 40.00
Termoretratil isolante | 1 | 9.70 | 9.70
Total |  |  | 2177.89
ESTAÇÃO SOLO |  |  |  | ESTAÇÃO CLIMA-SOLO
Ítem | Quantidade | Preço (Reais) | Total | Ítem | Quantidade | Preço (Reais) | Total
Sensor de pH do solo | 1 | 178.50 | 178.50 | Sensor de pH do solo | 1 | 178.50 | 178.50
Sensor de Umidade do solo | 1 | 9.90 | 19.80 | Sensor de Umidade do solo | 1 | 9.90 | 9.90
Esp 32 | 1 | 42.00 | 42.00 | Anemômetro | 1 | 237.03 | 237.03
Módulo GSM | 1 | 179.00 | 179.00 | Pluviômetro | 1 | 265.53 | 265.53
Painel fotovoltaico | 1 | 21.87 | 43.74 | Sensor bme280 | 1 | 30.99 | 30.99
Bateria | 1 | 79.50 | 79.50 | Esp 32 | 2 | 42.00 | 42.00
Controlador de carga | 1 | 89.00 | 89.00 | Módulo GSM | 1 | 179.00 | 179.00
Metalon (30 x 30 x 2) mm | 6 m | 70.50 | 70.50 | Painel fotovoltaico | 1 | 21.87 | 43.74
Metalon (60 x 60 x 2) mm | 6 m | 185.00 | 185.00 | Bateria | 1 | 79.50 | 79.50
Tinta Anticorrosiva | 1 | 79.60 | 79.60 | Controlador de carga | 1 | 89.00 | 89.00
Chapa de aço | 1 m2 | 60.00 | 60.00 | Metalon (30 x 30 x 2) mm | 6 m | 70.50 | 70.50
Kit Parafusos e porcas | 1 | 40.00 | 40.00 | Metalon (60 x 60 x 2) mm | 6 m | 185.00 | 185.00
Termoretratil isolante | 1 | 9.70 | 9.70 | Tinta Anticorrosiva | 1 | 79.60 | 79.60
Total |  |  | 1076.34 | Chapa de aço | 1 m2 | 60.00 | 60.00
 |  |  |  | Kit Parafusos e porcas | 1 | 40.00 | 40.00
 |  |  |  | Termoretratil isolante | 1 | 9.70 | 9.70
 |  |  |  | Total |  |  | 1599.99
