PI2-2020-1/documentos/(list of files, cad)

Other CAD files:
Estrutura/Prototipos/1ª versões/MECANISMO/EIXO_DA_BROCA.CATPart
Estrutura/Prototipos/1ª versões/MECANISMO/Mecanismo_de_Perfuracao.CATProduct
Estrutura/Prototipos/1ª versões/MECANISMO/Part1.CATPart
Estrutura/Prototipos/1ª versões/MECANISMO/SENSOR_DE_PH.CATPart
Estrutura/Prototipos/1ª versões/MECANISMO/SENSOR_UMIDADE_DO_SOLO.CATPart
Estrutura/Prototipos/1ª versões/MECANISMO/TUBO_INTERNO.CATPart
Estrutura/Prototipos/1ª versões/PROTO3-solo/CASE BATERIAS.CATPart
Estrutura/Prototipos/1ª versões/PROTO3-solo/HASTE.CATPart
Estrutura/Prototipos/1ª versões/PROTO3-solo/PAINEL SOLAR.CATPart
Estrutura/Prototipos/1ª versões/PROTO3-solo/PROTO3.CATProduct
Estrutura/Prototipos/1ª versões/PROTO3-solo/TRIPE.CATPart
Estrutura/Prototipos/1ª versões/PROTO3/PROTO3/ANEMOMETRO.CATPart
Estrutura/Prototipos/1ª versões/PROTO3/PROTO3/CASE BATERIAS.CATPart
Estrutura/Prototipos/1ª versões/PROTO3/PROTO3/HASTE.CATPart
Estrutura/Prototipos/1ª versões/PROTO3/PROTO3/PAINEL SOLAR.CATPart
Estrutura/Prototipos/1ª versões/PROTO3/PROTO3/PROTO3.CATProduct
Estrutura/Prototipos/1ª versões/PROTO3/PROTO3/SENSOR DE CHUVA.CATPart
Estrutura/Prototipos/1ª versões/PROTO3/PROTO3/TRIPE.CATPart
Estrutura/Prototipos/1ª versões/Prototipo1.CATPart
