PI2-2020-1/documentos/Estrutura/DTs/0_CORTES_CHAPAS_2MM/CORTES_CHAPAS_2MM.pdf

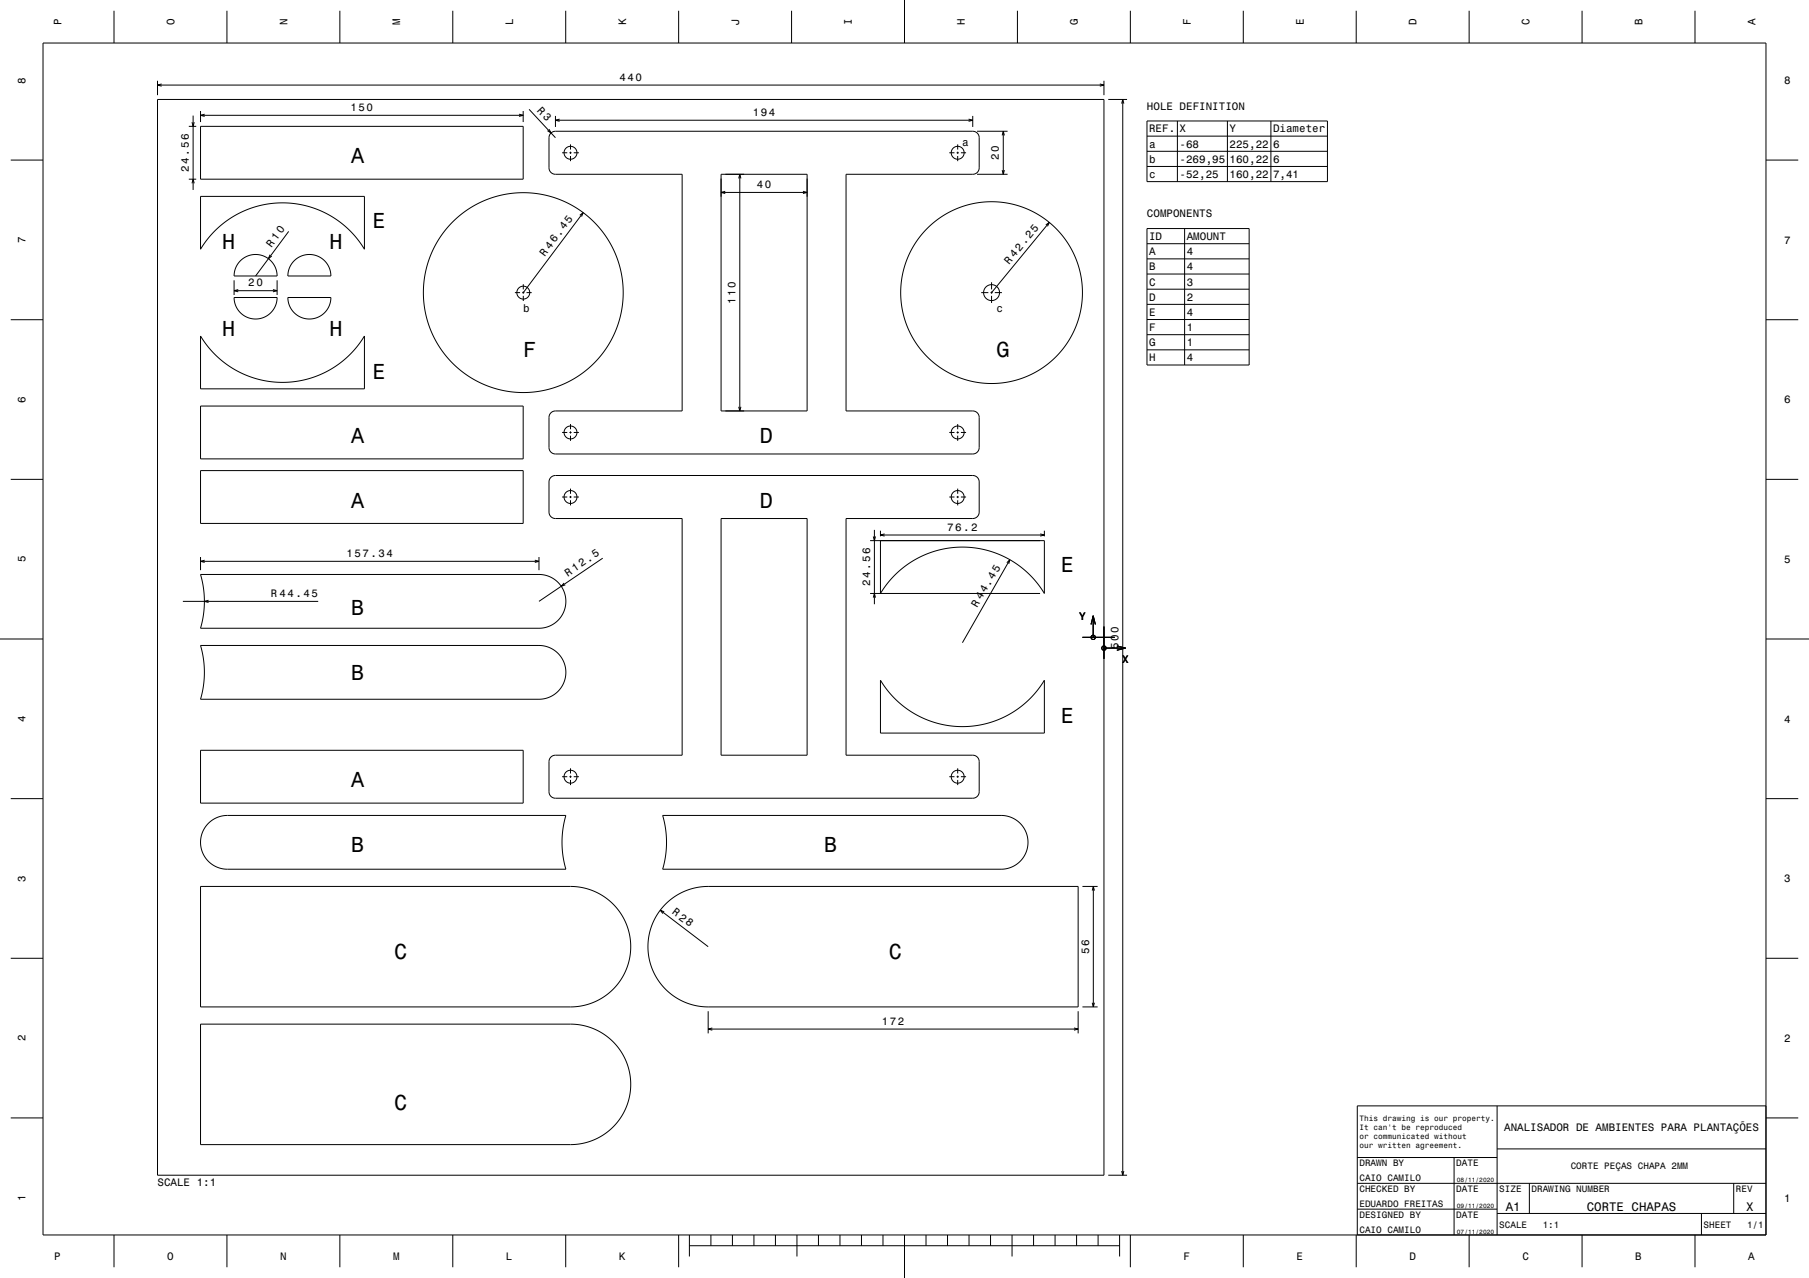
[picture p179: page 1]
SCALE 1:1; HOLE DEFINITION

REF. | X | Y | Diameter
a | -68 | 225,22 | 6
b | -269,95 | 160,22 | 6
c | -52,25 | 160,22 | 7,41

ID | AMOUNT

This drawing is our property.
It can't be reproduced
or communicated without
our written agreement.

ANALISADOR DE AMBIENTES PARA PLANTAÇÕES

DRAWN BY CAIO CAMILO | DATE 08/11/2020

CORTE PEÇAS CHAPA 2MM

CHECKED BY EDUARDO FREITAS | DATE 09/11/2020 | SIZE A1 | DRAWING NUMBER CORTE_CHAPAS | REV X

DESIGNED BY CAIO CAMILO | DATE 07/11/2020

SCALE 1:1 | SHEET 1/1
