PI2-2020-1/documentos/Estrutura/DTs/0_CORTES_CHAPAS_3MM/CORTES_CHAPAS_3MM.pdf

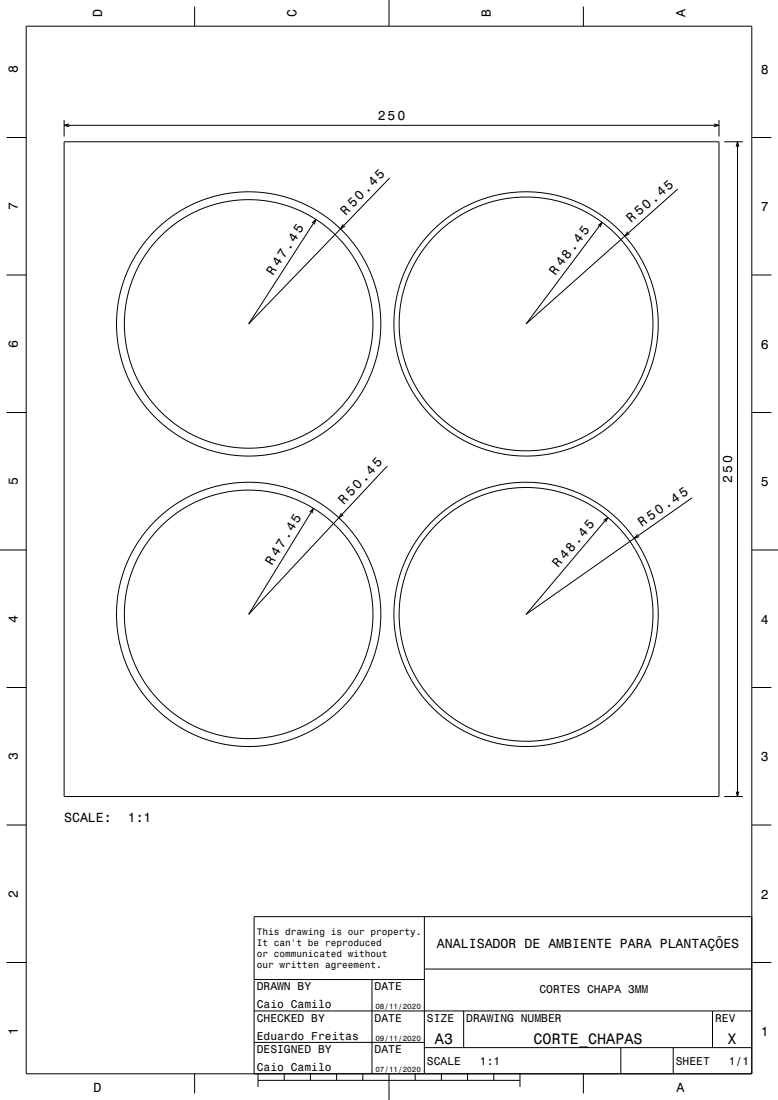
[picture p180: page 1]
CORTES CHAPA 3MM; SCALE: 1:1

This drawing is our property.
It can't be reproduced
or communicated without
our written agreement.

ANALISADOR DE AMBIENTE PARA PLANTAÇÕES

DRAWN BY Caio Camilo | DATE 08/11/2020

CHECKED BY Eduardo Freitas | DATE 09/11/2020 | SIZE A3 | DRAWING NUMBER CORTE_CHAPAS | REV X

DESIGNED BY Caio Camilo | DATE 07/11/2020

SCALE 1:1 | SHEET 1/1
