PI2-2020-1/documentos/Estrutura/DTs/0_clima_solo/DT1_CLIMA-SOLO.pdf

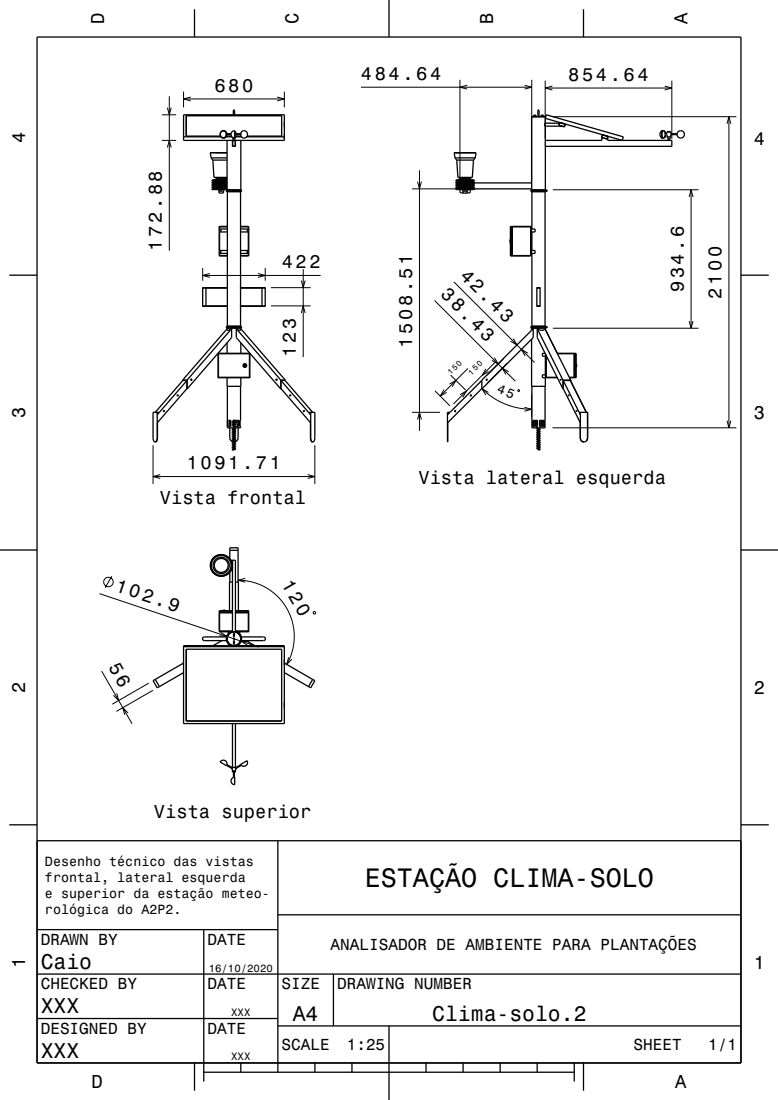
[picture p181: page 1]
Vista frontal; Vista superior

Vista lateral esquerda

Desenho técnico das vistas
frontal, lateral esquerda
e superior da estação meteo-
rológica do A2P2.

ESTAÇÃO CLIMA-SOLO

DRAWN BY Caio | DATE 16/10/2020

ANALISADOR DE AMBIENTE PARA PLANTAÇÕES

CHECKED BY XXX | DATE XXX | SIZE A4 | DRAWING NUMBER Clima-solo.2

DESIGNED BY XXX | DATE XXX

SCALE 1:25 | SHEET 1/1
