PI2-2020-1/documentos/Estrutura/DTs/0_clima_solo/DT4_CLIMA-SOLO-exploded.pdf

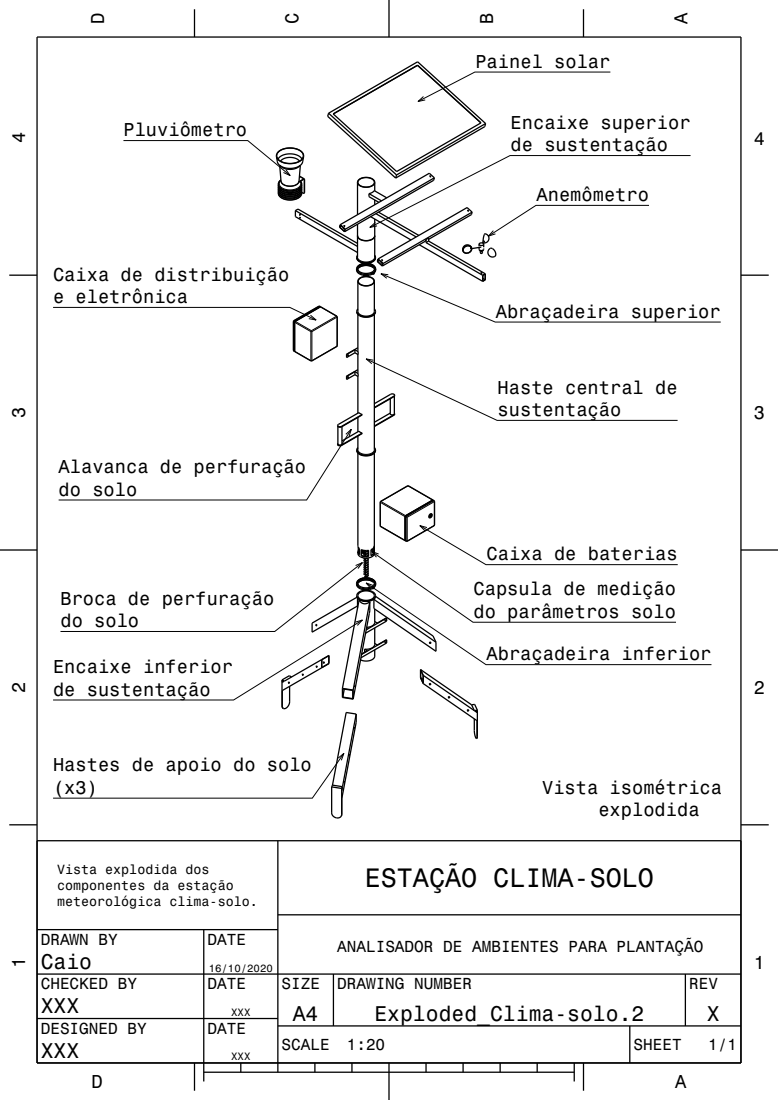
[picture p182: page 1]
Vista isométrica; Painel solar; Encaixe superior de sustentação; Abraçadeira superior; Encaixe inferior de sustentação; Abraçadeira inferior

Caixa de distribuição
e eletrônica

Haste central de
sustentação

Alavanca de perfuração
do solo

Caixa de baterias
Capsula de medição
do parâmetros solo

Broca de perfuração

Hastes de apoio do solo

Vista explodida dos
componentes da estação
meteorológica clima-solo.

ESTAÇÃO CLIMA-SOLO

DRAWN BY Caio | DATE 16/10/2020

ANALISADOR DE AMBIENTES PARA PLANTAÇÃO

CHECKED BY XXX | DATE XXX | SIZE A4 | DRAWING NUMBER Exploded_Clima-solo.2 | REV X

DESIGNED BY XXX | DATE XXX

SCALE 1:20 | SHEET 1/1
