PI2-2020-1/documentos/Estrutura/DTs/broca_DT06/broca.pdf

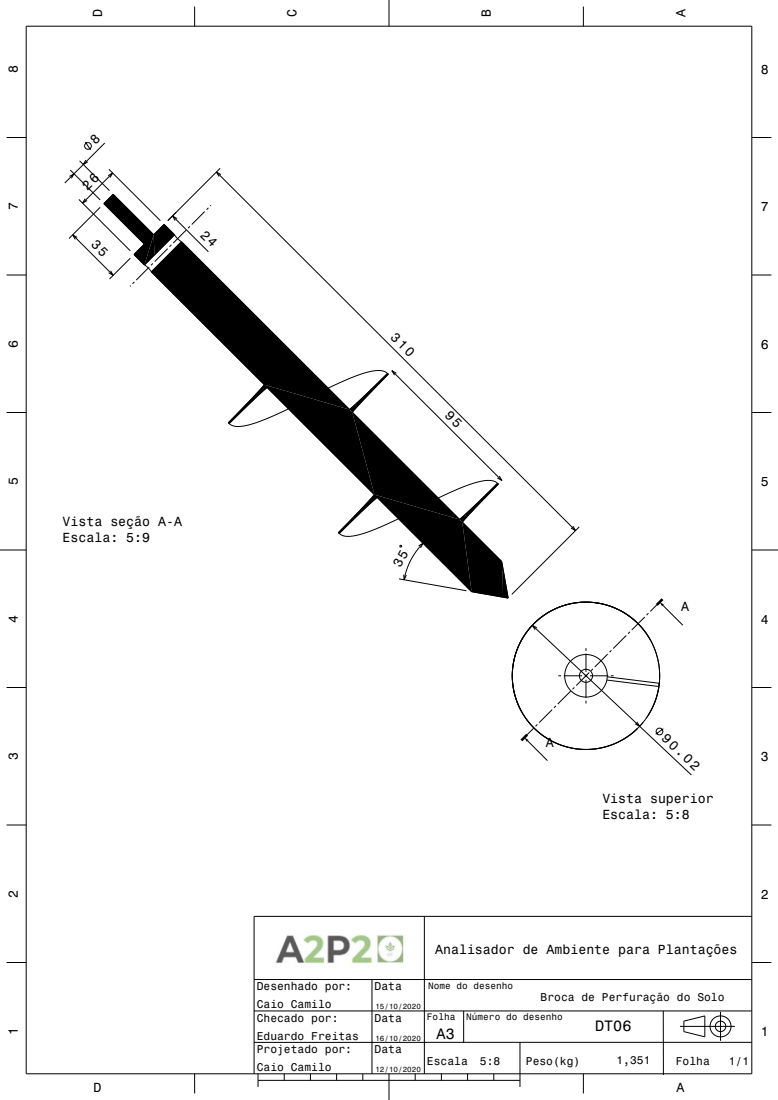
[picture p183: page 1]
Vista superior Escala: 5:8; Vista seção A-A Escala: 5:9

Analisador de Ambiente para Plantações

Desenhado por: Caio Camilo | Data 15/10/2020 | Nome do desenho Broca de Perfuração do Solo

Checado por: Eduardo Freitas | Data 16/10/2020 | Folha A3 | Número do desenho DT06

Projetado por: Caio Camilo | Data 12/10/2020 | Escala 5:8 | Peso(kg) 1,351 | Folha 1/1
