PI2-2020-1/documentos/Estrutura/DTs/clima-solo_DT07_2/clima-solo.pdf

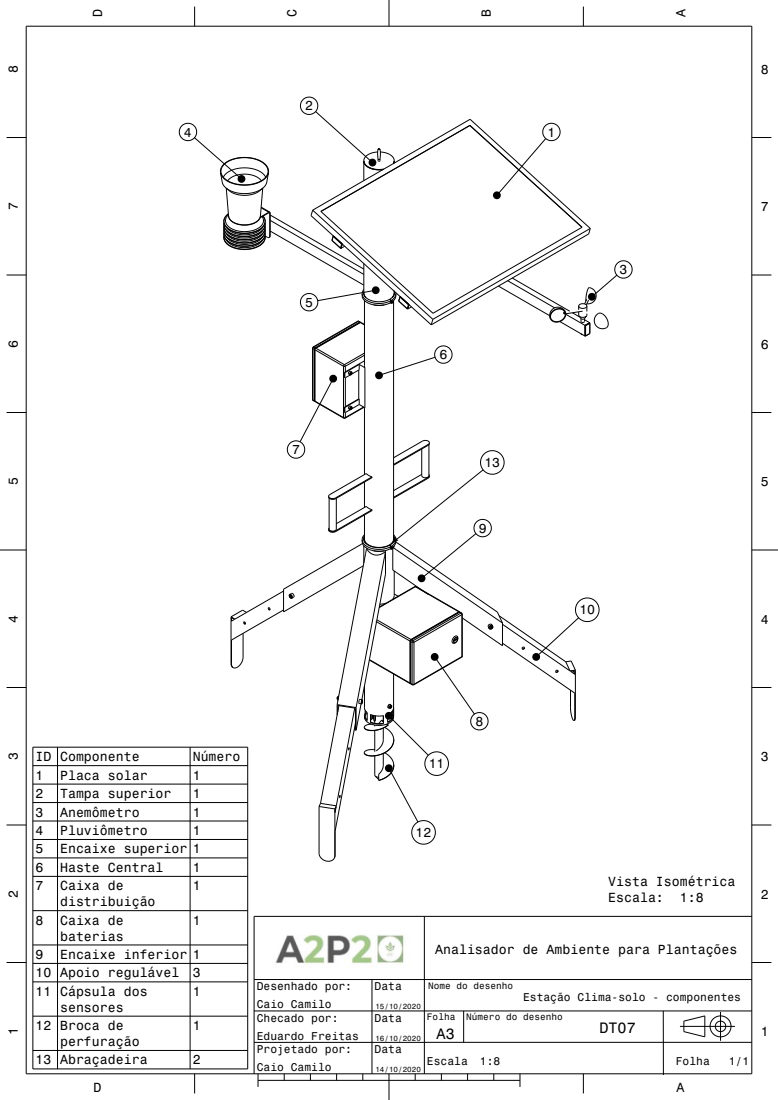
[picture p184: page 1]
Vista Isométrica Escala: 1:8

ID | Componente | Número
1 | Placa solar | 1
2 | Tampa superior | 1
3 | Anemômetro | 1
4 | Pluviômetro | 1
5 | Encaixe superior | 1
6 | Haste Central | 1
7 | Caixa de distribuição | 1

8 | Caixa de baterias | 1

Analisador de Ambiente para Plantações

9 | Encaixe inferior | 1
10 | Apoio regulável | 3
11 | Cápsula dos sensores | 1

Desenhado por: Caio Camilo | Data 15/10/2020 | Nome do desenho Estação Clima-solo - componentes

Checado por: Eduardo Freitas | Data 16/10/2020 | Folha A3 | Número do desenho DT07

12 | Broca de perfuração | 1

Projetado por: Caio Camilo | Data 14/10/2020 | Escala 1:8 | | Folha 1/1

13 | Abraçadeira | 2
