PI2-2020-1/documentos/Estrutura/DTs/encaixe_inferior_DT02/encaixe_inferior.pdf

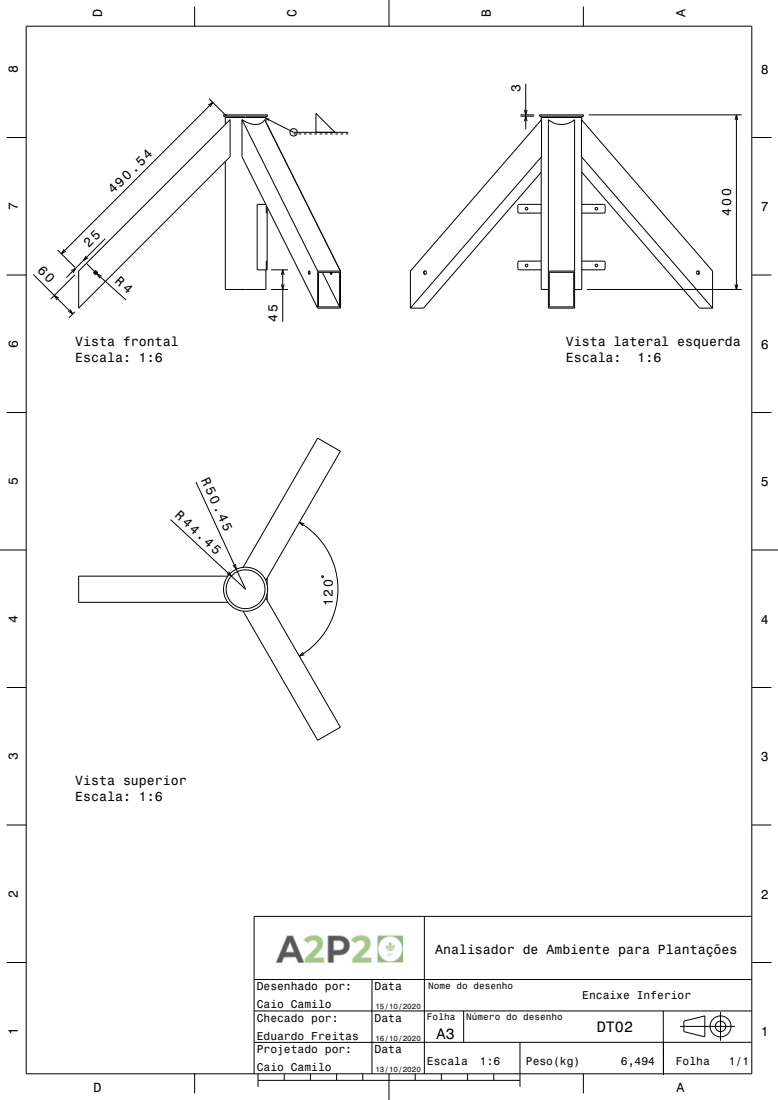
[picture p185: page 1]
Vista frontal Escala: 1:6; Vista superior Escala: 1:6

Vista lateral esquerda
Escala: 1:6

Analisador de Ambiente para Plantações

Desenhado por: Caio Camilo | Data 15/10/2020 | Nome do desenho Encaixe Inferior

Checado por: Eduardo Freitas | Data 16/10/2020 | Folha A3 | Número do desenho DT02

Projetado por: Caio Camilo | Data 13/10/2020 | Escala 1:6 | Peso(kg) 6,494 | Folha 1/1
