PI2-2020-1/documentos/Estrutura/DTs/encaixe_superior_DT03/encaixe_superior.pdf

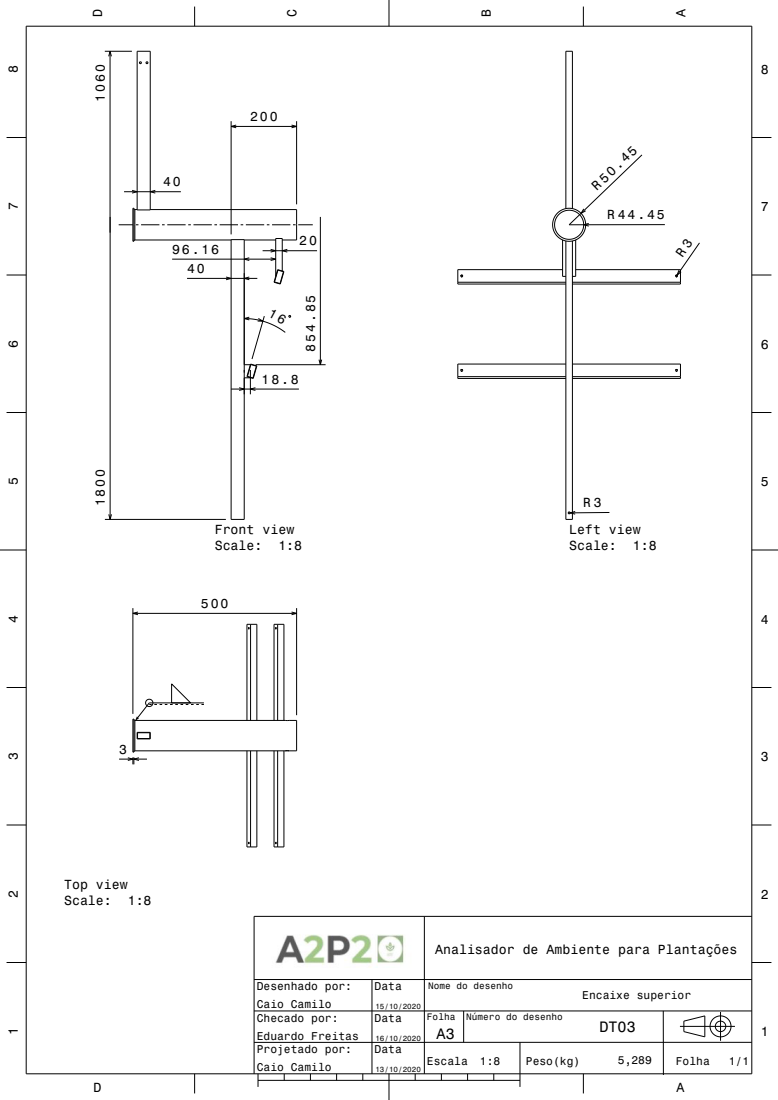
[picture p186: page 1]
Front view Scale: 1:8; Top view Scale: 1:8; Left view Scale: 1:8

Analisador de Ambiente para Plantações

Desenhado por: Caio Camilo | Data 15/10/2020 | Nome do desenho Encaixe superior

Checado por: Eduardo Freitas | Data 16/10/2020 | Folha A3 | Número do desenho DT03

Projetado por: Caio Camilo | Data 13/10/2020 | Escala 1:8 | Peso(kg) 5,289 | Folha 1/1
