PI2-2020-1/documentos/Estrutura/DTs/haste_central_clima_solo_DT01/haste_central_clima_solo.pdf

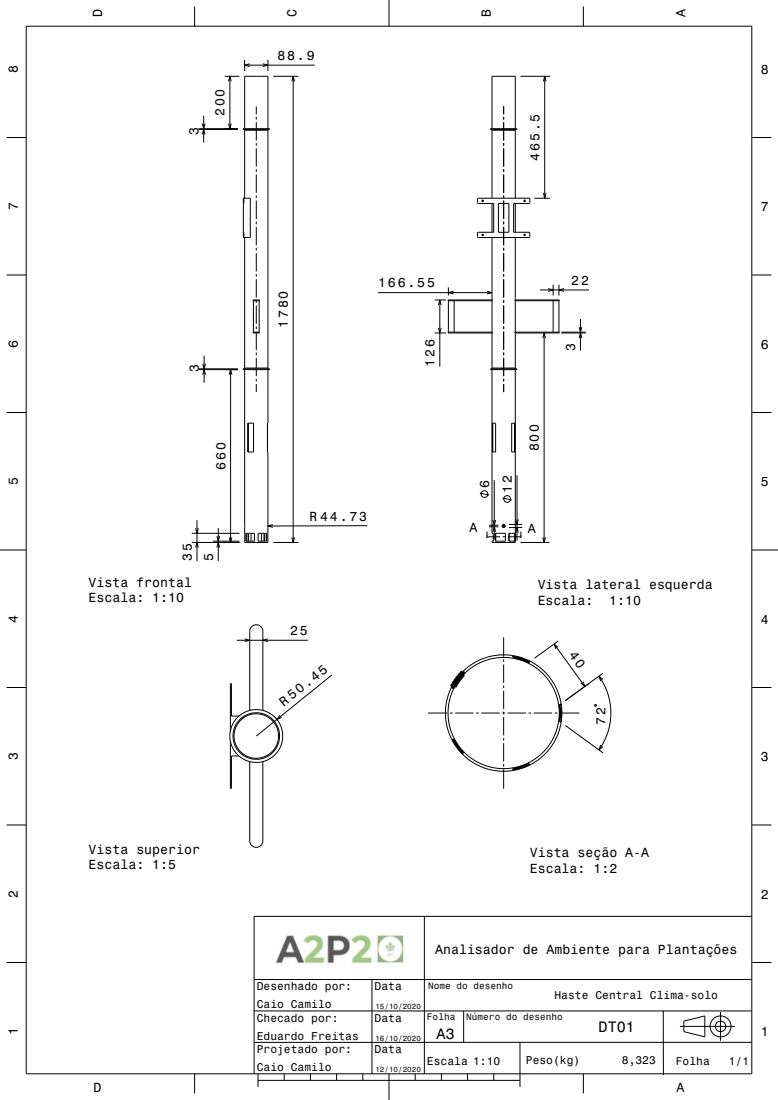
[picture p187: page 1]
Vista frontal Escala: 1:10; Vista superior Escala: 1:5; Vista seção A-A Escala: 1:2

Vista lateral esquerda
Escala: 1:10

Analisador de Ambiente para Plantações

Desenhado por: Caio Camilo | Data 15/10/2020 | Nome do desenho Haste Central Clima-solo

Checado por: Eduardo Freitas | Data 16/10/2020 | Folha A3 | Número do desenho DT01

Projetado por: Caio Camilo | Data 12/10/2020 | Escala 1:10 | Peso(kg) 8,323 | Folha 1/1
