PI2-2020-1/documentos/Estrutura/DTs/haste_central_solo_DT10/haste_central_solo.pdf

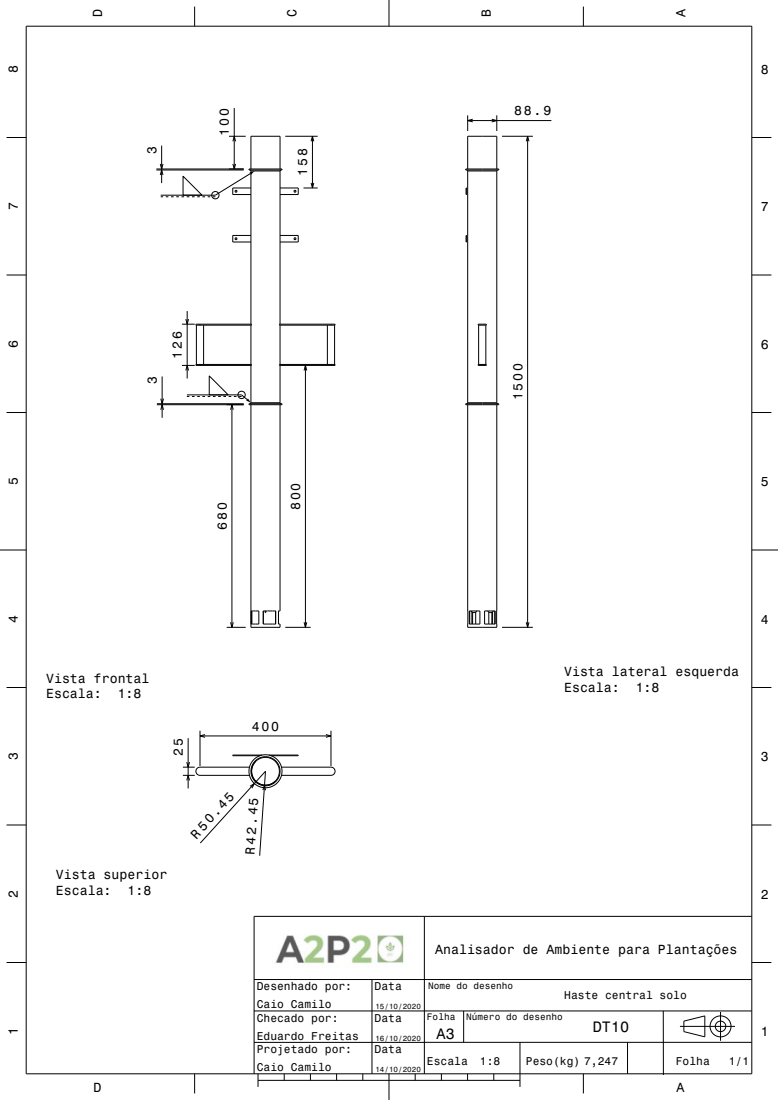
[picture p188: page 1]
Vista frontal Escala: 1:8; Vista superior Escala: 1:8

Vista lateral esquerda
Escala: 1:8

Analisador de Ambiente para Plantações

Desenhado por: Caio Camilo | Data 15/10/2020 | Nome do desenho Haste central solo

Checado por: Eduardo Freitas | Data 16/10/2020 | Folha A3 | Número do desenho DT10

Projetado por: Caio Camilo | Data 14/10/2020 | Escala 1:8 | Peso(kg) 7,247 | Folha 1/1
