PI2-2020-1/documentos/Estrutura/DTs/regulagem_apoio_DT07/regulagem_apoio.pdf

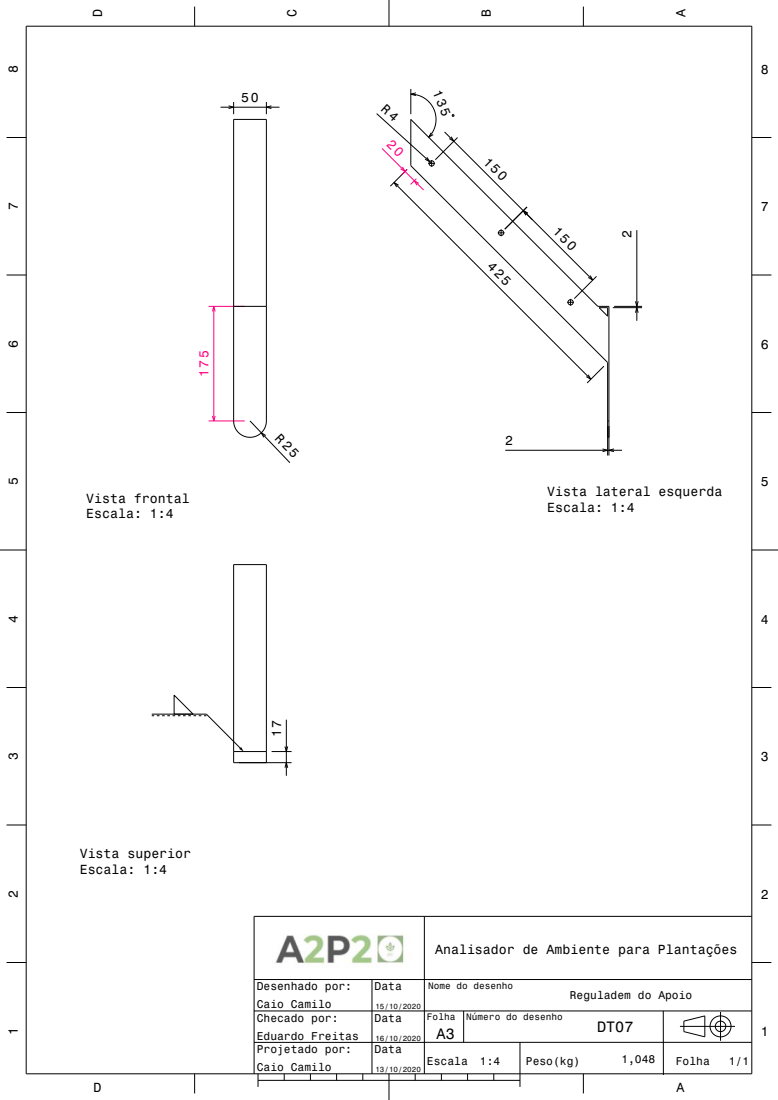
[picture p189: page 1]
Vista frontal Escala: 1:4; Vista superior Escala: 1:4

Vista lateral esquerda
Escala: 1:4

Analisador de Ambiente para Plantações

Desenhado por: Caio Camilo | Data 15/10/2020 | Nome do desenho Reguladem do Apoio

Checado por: Eduardo Freitas | Data 16/10/2020 | Folha A3 | Número do desenho DT07

Projetado por: Caio Camilo | Data 13/10/2020 | Escala 1:4 | Peso(kg) 1,048 | Folha 1/1
