PI2-2020-1/documentos/Estrutura/DTs/solo_DT09/solo.pdf

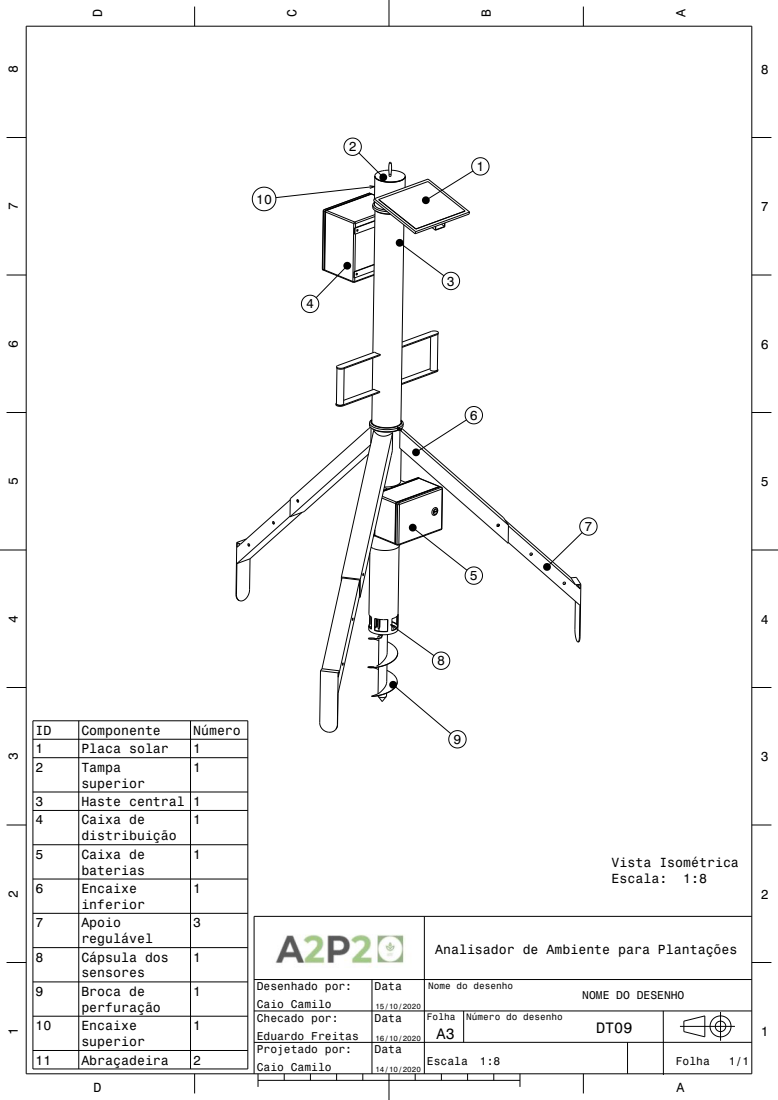
[picture p190: page 1]
Vista Isométrica Escala: 1:8

ID | Componente | Número
1 | Placa solar | 1
2 | Tampa superior | 1

3 | Haste central | 1
4 | Caixa de distribuição | 1

5 | Caixa de baterias | 1

6 | Encaixe inferior | 1

7 | Apoio regulável | 3

Analisador de Ambiente para Plantações

8 | Cápsula dos sensores | 1

9 | Broca de perfuração | 1

Desenhado por: Caio Camilo | Data 15/10/2020 | Nome do desenho NOME DO DESENHO

Checado por: Eduardo Freitas | Data 16/10/2020 | Folha A3 | Número do desenho DT09

10 | Encaixe superior | 1

Projetado por: Caio Camilo | Data 14/10/2020 | Escala 1:8 | | Folha 1/1

11 | Abraçadeira | 2
