PI2-2020-1/documentos/Estrutura/DTs/tampa_inferior_DT04/tampa_inferior.pdf

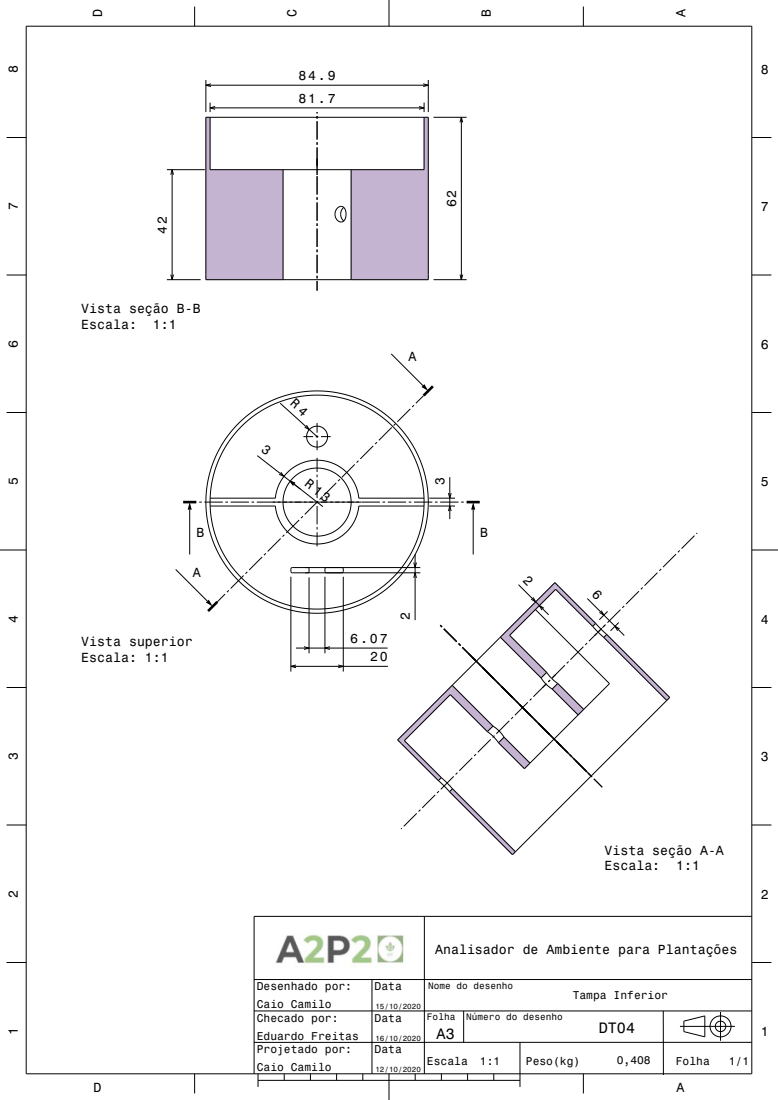
[picture p191: page 1]
Vista superior; Escala: 1:1; Vista seção A-A Escala: 1:1; Vista seção B-B Escala: 1:1

Analisador de Ambiente para Plantações

Desenhado por: Caio Camilo | Data 15/10/2020 | Nome do desenho Tampa Inferior

Checado por: Eduardo Freitas | Data 16/10/2020 | Folha A3 | Número do desenho DT04

Projetado por: Caio Camilo | Data 12/10/2020 | Escala 1:1 | Peso(kg) 0,408 | Folha 1/1
