PI2-2020-1/documentos/(list of files, drawings)

Other design files:
Eletrônica/Arquivos_PCB/Estação Clima-solo.pdsprj
Eletrônica/Arquivos_PCB/Estação do solo.pdsprj
